AndresMtzP/Globetrotters/README.md

# GlobeTrotter
##SDSU EE/CompE 490 Spring17

* This repository holds the Globetrotter project files (San Diego State University Spring 2017)

##Collaborators
* Leon Tran 
* Kevin Warner 
* Brian Pham 
* Andres Martinez Paz 
* Rence Abar 
* Mark Luna 
* Cristopher Pakosta 
* Jake Jabbora
