AndresMtzP/Globetrotters/ProjectFiles/Project/PCB design/CoilsTop/PCB/LogFiles/ForwardAnnotation.txt

                               Forward Annotation
                               ------------------

                        02:03 PM Tuesday, April 25, 2017
                     Job Name: J:\CoilsTop\PCB\CoilsTop.pcb

Version:  01.01.00

     The PDBs listed in the project file will be searched to satisfy the parts
      requirements of the iCDB only for parts not already found in the
      Target PDB.

     The schematic source is a Common Data Base.

     The AllowAlphaRefDes status indicates that reference
      designators containing all alpha characters should be deleted
      and the relevant symbols repackaged.

     Common Data Base has been read

     Target PDB Name: Work\Layout_Temp\PartsDB.pdb

     Number of Part Numbers: 4
          Part Numb: HallEffectSensor -> Vend Part: HallEffectSensor 
          Part Numb: LED_SMD_1206 -> Vend Part: LED_SMD_1206 
          Part Numb: Res_1206 -> Vend Part: Res_1206 
          Part Numb: 10_pin_sngl -> Vend Part: 10_pin_sngl 

     Number of Part Names: 0

     Number of Part Labels: 0

     Checking for value differences between symbol properties and PartsDB properties

    WARNING: Block Schematic1, Page 1, Symbol XCMP26:
	Symbol / PartsDB property mismatch:
      Resolved PartNumber = LED_SMD_1206
      Symbol Property: Description = LED, Photoemissive Diode
     PartsDB Property: Description = 

    WARNING: Block Schematic1, Page 1, Symbol XCMP26:
	Symbol / PartsDB property mismatch:
      Resolved PartNumber = LED_SMD_1206
      Symbol Property: Type = DIODE
     PartsDB Property: Type = IC

    WARNING: Block Schematic1, Page 1, Symbol XCMP25:
	Symbol / PartsDB property mismatch:
      Resolved PartNumber = LED_SMD_1206
      Symbol Property: Description = LED, Photoemissive Diode
     PartsDB Property: Description = 

    WARNING: Block Schematic1, Page 1, Symbol XCMP25:
	Symbol / PartsDB property mismatch:
      Resolved PartNumber = LED_SMD_1206
      Symbol Property: Type = DIODE
     PartsDB Property: Type = IC

    WARNING: Block Schematic1, Page 1, Symbol XCMP20:
	Symbol / PartsDB property mismatch:
      Resolved PartNumber = LED_SMD_1206
      Symbol Property: Description = LED, Photoemissive Diode
     PartsDB Property: Description = 

    WARNING: Block Schematic1, Page 1, Symbol XCMP20:
	Symbol / PartsDB property mismatch:
      Resolved PartNumber = LED_SMD_1206
      Symbol Property: Type = DIODE
     PartsDB Property: Type = IC

    WARNING: Block Schematic1, Page 1, Symbol XCMP19:
	Symbol / PartsDB property mismatch:
      Resolved PartNumber = LED_SMD_1206
      Symbol Property: Description = LED, Photoemissive Diode
     PartsDB Property: Description = 

    WARNING: Block Schematic1, Page 1, Symbol XCMP19:
	Symbol / PartsDB property mismatch:
      Resolved PartNumber = LED_SMD_1206
      Symbol Property: Type = DIODE
     PartsDB Property: Type = IC

    WARNING: Block Schematic1, Page 1, Symbol XCMP28:
	Symbol / PartsDB property mismatch:
      Resolved PartNumber = Res_1206
      Symbol Property: Description = Resistor
     PartsDB Property: Description = 

    WARNING: Block Schematic1, Page 1, Symbol XCMP28:
	Symbol / PartsDB property mismatch:
      Resolved PartNumber = Res_1206
      Symbol Property: Type = RES
     PartsDB Property: Type = Resistor

    WARNING: Block Schematic1, Page 1, Symbol XCMP27:
	Symbol / PartsDB property mismatch:
      Resolved PartNumber = Res_1206
      Symbol Property: Description = Resistor
     PartsDB Property: Description = 

    WARNING: Block Schematic1, Page 1, Symbol XCMP27:
	Symbol / PartsDB property mismatch:
      Resolved PartNumber = Res_1206
      Symbol Property: Type = RES
     PartsDB Property: Type = Resistor

    WARNING: Block Schematic1, Page 1, Symbol XCMP22:
	Symbol / PartsDB property mismatch:
      Resolved PartNumber = Res_1206
      Symbol Property: Description = Resistor
     PartsDB Property: Description = 

    WARNING: Block Schematic1, Page 1, Symbol XCMP22:
	Symbol / PartsDB property mismatch:
      Resolved PartNumber = Res_1206
      Symbol Property: Type = RES
     PartsDB Property: Type = Resistor

    WARNING: Block Schematic1, Page 1, Symbol XCMP21:
	Symbol / PartsDB property mismatch:
      Resolved PartNumber = Res_1206
      Symbol Property: Description = Resistor
     PartsDB Property: Description = 

    WARNING: Block Schematic1, Page 1, Symbol XCMP21:
	Symbol / PartsDB property mismatch:
      Resolved PartNumber = Res_1206
      Symbol Property: Type = RES
     PartsDB Property: Type = Resistor

     Checking the validity of the packaging of prepackaged schematic
      symbols.  Only the first error in symbols having the same
      Reference Designator will be reported.

     The packaging of all prepackaged schematic symbols is consistent
      with the Parts DataBase data for the cross mapping of
      symbol pin names to Part Number pin numbers.
      Symbols that were not prepackaged will now be packaged correctly.
      
     No errors in Existing Schematic Packaging.

     The Common DataBase has been read and will be packaged.
     Clustering 22 Symbols:
              22  *********************
     Clustering is Complete

     Packager Assignments successfully completed

     14 nets were found containing 38 pins
     13 components were found

     Creating a formatted Schematic Netlist (LogFiles\SchematicNetlist.txt)...
     A formatted Schematic Netlist has been created.

     The Logic DataBase has been compiled from the Schematic Design.
      Use Netload to bring the Component Design into sync.

     This Logic Data was Compiled with 16 warnings.
      Erroneous results may occur if not fixed.

                                     NetLoad
                                     -------

                        02:03 PM Tuesday, April 25, 2017
                     Job Name: J:\CoilsTop\PCB\CoilsTop.pcb

Version:  02.11.12

	Netloading the Layout.  Unused components will be changed to spares.

	Unconnected pins will be set to net "(Net0)".

	Schematic reference designator changes will be forward annotated.

     WARNING:  The "6_pin_sngl_.1sp" cell used by "J1" in the Layout is not
      valid for a "10_pin_sngl" Part Number.
     INFO: Cell "6_pin_sngl_.1sp" is being replaced by cell "10_pin_sngl_.1sp".

     The following 8 components have not been placed:

        D1
        D2
        D3
        D4
        R1
        R2
        R3
        R4

     Netload completed successfully with 1 warning(s).
     
     Back Annotating...

  Updating Logic Database...

     Version:  99.00.05

     No changes made to Existing Schematic Packaging.

     There is no symbol data to be back annotated to the schematic source.

     The Logic DataBase has been updated and the Common DataBase has
      automatically been brought into sync with the Logic DataBase.
      Please proceed with your design.

     Finished updating the Logic Database.

     Creating a formatted Schematic Netlist (LogFiles\AfterBakAnnoNetlist.txt)...
     A formatted Schematic Netlist has been created.

     Creating a new netlist text file (LogFiles\KeyinNetList.txt)
      from the Logic Database (Work\Layout_Temp\LogicDB.lgc)...
  A new netlist text file has been generated.

                 Beginning Netload on the Layout Design.
           ---------------------------------------------------
	Broke back a trace from the point (7112000, -92456000).
	Assigned net XSIG010007 to a trace which was originally on net XSIG010003.
	Broke back a trace from the point (2032000, -92456000).
	Assigned net XSIG010008 to a trace which was originally on net XSIG010004.
	Broke back a trace from the point (-508000, -92456000).
	Assigned net XSIG010009 to a trace which was originally on net XSIG010005.
	Broke back a trace from the point (-5588000, -92456000).
	Assigned net XSIG010010 to a trace which was originally on net XSIG010006.
	Broke back a trace from the point (-3048000, -92456000).

Some nets were completely deleted from the Layout Design....
	Deleted net XSIG010004, which has no pins, from the Layout Design.
	Deleted net XSIG010005, which has no pins, from the Layout Design.
	Deleted net XSIG010006, which has no pins, from the Layout Design.
	Deleted net XSIG010003, which has no pins, from the Layout Design.

Forward-Annotation on the Layout Design has been successfully completed.

There were 4 reassignments of nets.
There were 5 traces broken back.
There were 4 nets removed from the Layout Design.
