AndresMtzP/Globetrotters/ProjectFiles/Project/PCB design/GTLibrary/LayoutTemplates/Micro_mouse/PCB/LogFiles/PCBVersion.txt

Expedition PCB - Pinnacle Version: 05.010425.03 2000C
