AndresMtzP/Globetrotters/ProjectFiles/Project/PCB design/GTLibrary/Templates/Layout/2 Layer Generic Template/LogFiles/BackAnnotation.txt

                                 BackAnnotation
                                 --------------

                       02:56 PM Saturday, October 25, 2008
Job Name: C:\My Data\Design\Mentor\Libs\JPK_Lib\Templates\Layout\2 Layer Logic Root Module Template\Single_7seg.pcb

  Updating Logic Database...

     Version:  99.00.05

     Writing a list of routed plane pins to Logic\rtdplane.caf.

     Finished updating the Logic Database.

     Updating LogicDB Version from 5 to 6.

     Creating a formatted Schematic Netlist (LogFiles\AfterBakAnnoNetlist.txt)...
     A formatted Schematic Netlist has been created.

     Creating a new Keyin Netlist (C:\My Data\Design\Mentor\Libs\JPK_Lib\Templates\Layout\2 Layer Logic Root Module Template\NetList.kyn)
      from the Logic Database (Work\Layout_Temp\LogicDB.lgc)...
  A new Keyin Netlist has been generated.

     Completed Back Annotation
