AndresMtzP/Globetrotters/ProjectFiles/Project/PCB design/GTLibrary/Work/CellEditorFiles/jpk_Antenna/LogFiles/ReadGraphicsSettings.txt

Attempting to read Graphics Settings file <Graphics Settings.hkp>

The full pathname is <C:\cad\CentralLibs\JPK_Lib\Work\CellEditorFiles\jpk_Antenna\Config\Graphics Settings.hkp>

Successful completion
