AndresMtzP/Globetrotters/ProjectFiles/Project/PCB design/GTLibrary/Work/CellEditorFiles/jpk_conn/LogFiles/WriteGraphicsSettings.txt

Attempting to write Graphics Settings file <Graphics Settings.hkp>

The full pathname is   <C:\cad\CentralLibs\JPK_Lib\Work\CellEditorFiles\jpk_conn\Config\Graphics Settings.hkp>
The backup pathname is <C:\cad\CentralLibs\JPK_Lib\Work\CellEditorFiles\jpk_conn\Config\Graphics Settings.bak>

Successful completion
