AndresMtzP/Globetrotters/ProjectFiles/Project/PCB design/GTLibrary/Work/CellEditorFiles/jpk_Pot/LogFiles/ReadGraphicsSettings.txt

Attempting to read Graphics Settings file <Graphics Settings.hkp>

The full pathname is <C:\cad\CentralLibs\JPK_Lib\Work\CellEditorFiles\jpk_Pot\Config\Graphics Settings.hkp>

file <C:\cad\CentralLibs\JPK_Lib\Work\CellEditorFiles\jpk_Pot\Config\Graphics Settings.hkp> does not exist
