AndresMtzP/Globetrotters/ProjectFiles/Project/PCB design/GTLibrary/Work/CellEditorFiles/oda99_fuse/LogFiles/ReadGraphicsSettings.txt

Attempting to read Graphics Settings file <Graphics Settings.hkp>

The full pathname is <C:\cad\CentralLibs\JPK_Lib\Work\CellEditorFiles\oda99_fuse\Config\Graphics Settings.hkp>

file <C:\cad\CentralLibs\JPK_Lib\Work\CellEditorFiles\oda99_fuse\Config\Graphics Settings.hkp> does not exist
