AndresMtzP/Globetrotters/ProjectFiles/Project/PCB design/GTLibrary/Seed_Projects/Santa_Cruz/Santa_Cruz_Level_2/PCB/LogFiles/ReadGraphicsSettings.txt

Attempting to read Graphics Settings file <Graphics Settings.hkp>

The full pathname is <C:\cad\CentralLibs\JPK_Lib\Seed_Projects\Santa_Cruz\Santa_Cruz_Level_2\PCB\Config\Graphics Settings.hkp>

Successful completion
