AndresMtzP/Globetrotters/ProjectFiles/Weekly Reports/03-16-2017/WDRF_Rence_Week6.docx

ECE Senior Design Weekly Report

Engineer’s Name: Piorence Abar Date: 03.16.17

Team Name: The Globetrotters Lab Section: 4

Week’s Task: Finishing up the schematic for dismantled levitation model and researching information for the coils that we will be using for our project.

Results: This week much of my time was spent on preparing for our class presentation for Thursday, March 16. On top of that, I spent majority of my weekend finishing up the schematic of the dismantled levitation model. Being able to see the other side of PCB and being able to connect the pins I wasn’t able to before because of not seeing the connections, I was able to further examine the analog system. I, along with the help of the other EE’s, Chris and Jake, was able to gain a better understanding as to how exactly the analog system works and what changes we’d have to make to change the system from an analog to implementing a microcontroller. I have also been researching what parameters we would need for our coils because that has been my task this week in order to prep for starting the building of our circuit next week. With the help from http://info.ee.surrey.ac.uk/Workshop/advice/coils/index.html, I have a detailed step-by-step description from choosing the type of core, how many turns are needed, what wire is needed, testing and etc.
