AndresMtzP/Globetrotters/ProjectFiles/Weekly Reports/04-27-2017/Leon Tran Weekly Report 4-26-17.docx

ECE Senior Design Weekly Report

Engineer’s Name: Leon Tran Date: 04/26/17

Team Name: The Globetrotters Lab Section: 4

Week’s Task: Adding an about Page and Gallery Page for the GUI. Testing and soldering the PCBs for Levitation. Prepare Final Presentation

Results:

- Testing the PCBs
  - Soldering and fixing the shorts on the PCBs for the Hall Effects Sensor
- GUI
  - Created an About Page for the GUI
  - Created a Gallery Page that documents our progress from the initial creation to the finish product.
- Presentation
  - Constructed and organized the slides for the final presentation
