AndresMtzP/Globetrotters/ProjectFiles/Project/Minutes/Notes - 2-23-17.docx

# The Globetrotters Notes – 2/23/17

# Hugh Comments

## Try to look for cheap Mold for Globe

## Voice

- Change Alexa hot word to something else

## Design

- 3D Print Mounts

## Levitation

### Jake

- Get some calculations for the force and energy
  - Look into half Bridge and off-Bridge
  - Look at the Data Sheet

### Chris

- Calculations
- Get Calculations on the drive

### Rence
