AndresMtzP/Globetrotters/ProjectFiles/Project/Minutes/Notes - 3-14-17.docx

# The Globetrotters Notes – 3/14/17

# Reports

- Sensors and motors ordered last Friday
- Levitation team met last Friday and designed a new schematic
- Official Name of the project is Trotter

# Presentation

- Alexea will introduce the presentation
