AndresMtzP/Globetrotters/ProjectFiles/Project/Minutes/Notes - 4-6-17 .docx

# The Globetrotters Notes – 4/6/17

# Feedback

- Control System
  - H-Bridge
    - Control the Position of the Magnets
  - Get Numbers and know why and how it will affect the system
  - Find the correct voltage to get the sweet spot for PWM
    - Middle Range
- Need Heat Sensor to know when to shutdown the system
- Keep Looking into painting material
- Frequency of PWM has to be faster than the sampling rate
- Describe the details of the Chips in the presentation
  - H-Bridge
