AndresMtzP/Globetrotters/ProjectFiles/Project Proposal/Progress Report.pdf

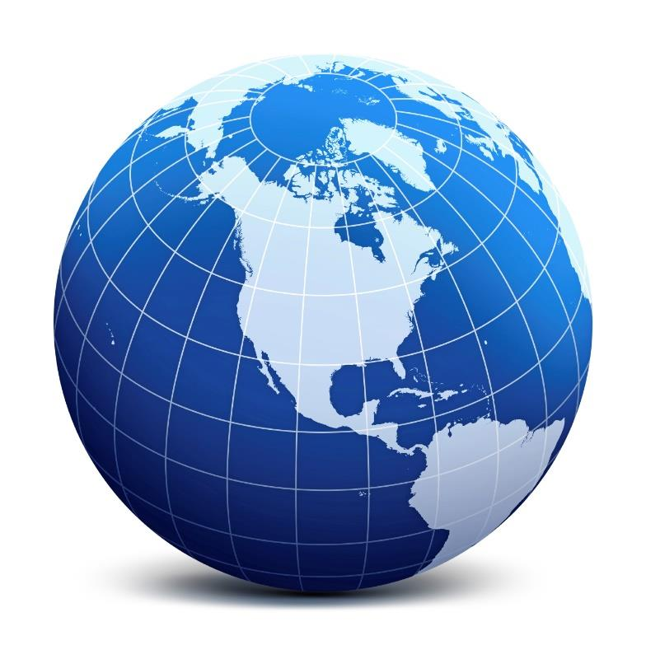
[picture p28: figure]

2017

# The GlobeTrotters

## PROPOSAL FOR MAGLEV GLOBE ENGINEERS ____________________________

## Brian Pham Andres Martinez Paz Leon Tran Christopher Pakosta Kevin Warner Rence Abar Mark Luna Jake Jabbora

## Sponsored By: Morris Cerullo World Evangelism

1 | P a g e | T h e G l o b e t r o t t e r s

## Table of Contents

## Introduction | 1

### Abstract | 2 Project Description | 2

## Design | 3

### Block Diagrams | 3, 4, 5 Mock-Up Illustration | 5, 6 Performance Requirement | 7

## Testing and Verification | 8

### Testing Procedures | 8 Benchmarks | 8

## Project Management | 9

### Project Plan (Gantt Charts) | 9 Milestones | 10

## Budget | 10

### Cost Analysis | 10, 11

## Promotional Flyer | 12

2 | P a g e | T h e G l o b e t r o t t e r s

## I. Introduction

## Abstract:

MCWE has requested for a levitating globe that users can interact with to explore and learn about different regions of the world. The user will be able to use non-contact methods, such as gesture and voice commands, to navigate the globe and select areas of interest. Information about the area will be collected through various API sources which will be stored on a local database. The Raspberry Pi will then present the information on an external display while the globe rotates to the location selected by the user.

## Project Description:

### Levitating interactive globe

The globe will enable the user to provide gesture inputs and make vocal requests for various geographical facts. It will present the user with geographic and statistical data about the various countries and cities of the world upon request while it rotates to the requested country. The globe is designed with a focus on ease of use and accommodating people with disabilities.

### Features

- Raspberry Pi 3 and PIC microcontroller powered
- 12-inch acrylic globe surface
- Electromagnetic levitation
- Laser projected azimuthal equidistant maps
- Non-contact IR based gesture inputs with velocity control
- Voice enabled user input and feedback using Amazon Web Services
- QGIS enabled graphical user interface elements
- DSI connected 7-inch 800 x 480 LCD display
- Ultrasonic sensor for user detection and greeting

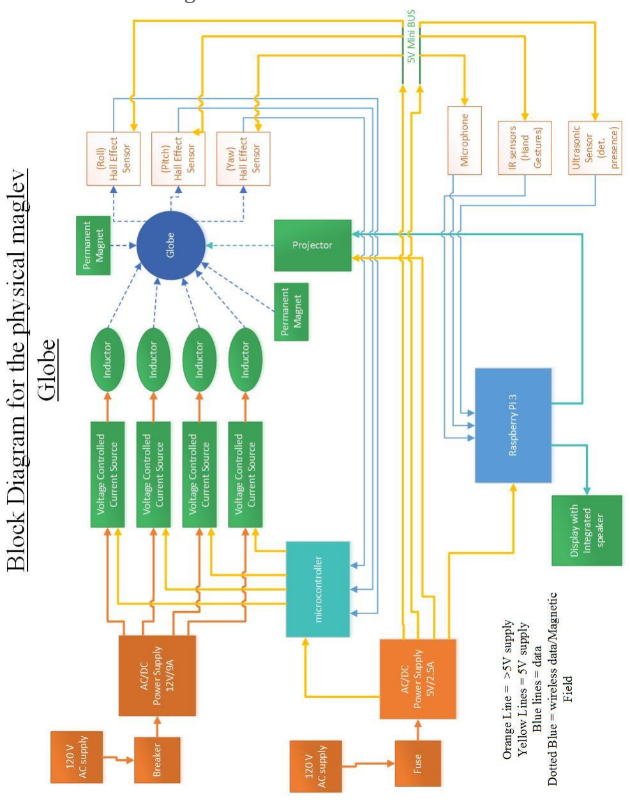
[picture p29: figure]

3 | P a g e | T h e G l o b e t r o t t e r s

## II. Design

## Hardware Block Diagram

### Figure 1 | Top Level Hardware Hierarchy

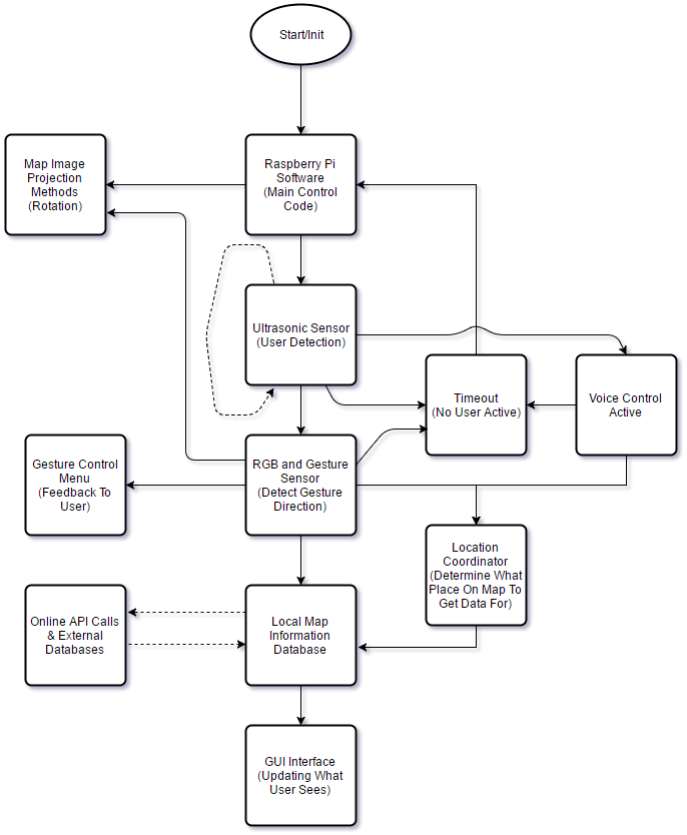
[picture p30: figure]

4 | P a g e | T h e G l o b e t r o t t e r s

## Software Block Diagram

### Software Block Diagram Flow Charts

### Figure 2 | GUI, Projection, and Map Data Processing View

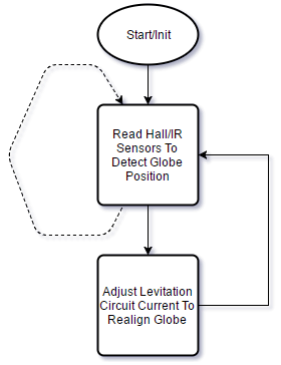
[picture p31: figure]
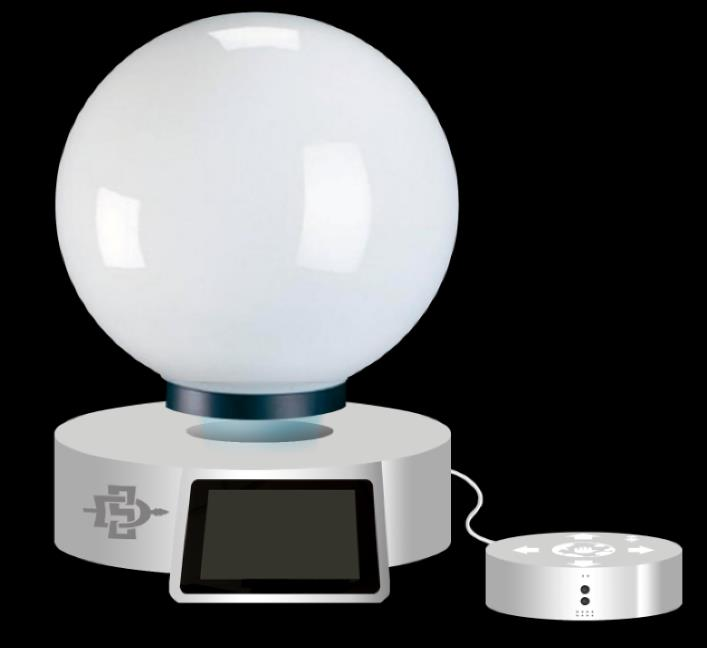
[picture p32: figure]

5 | P a g e | T h e G l o b e t r o t t e r s

### Levitation Microcontroller

### Figure 3 | Top Level Control View

## Mock Up Illustrations

### Figure 4 | General View

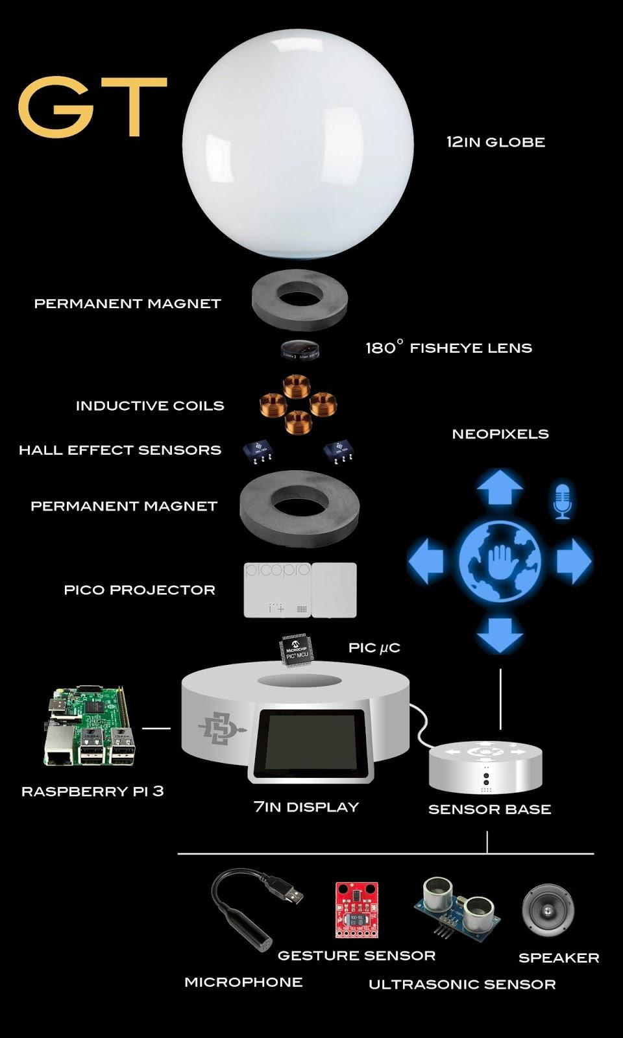
[picture p33: figure]

6 | P a g e | T h e G l o b e t r o t t e r s

### Figure 5 | Drill Down View

7 | P a g e | T h e G l o b e t r o t t e r s

## Performance Requirements

### Hardware

Power Supply
The two Power Supply’s for the system will continue to operate continuously provided the line power stays on. The power supply for the electronics will provide a continuous DC supply of 5V/3A. The power supply for the larger maglev system will provide a continuous DC supply of 12V/9A.

Sample Rate
The current and voltage sensors will operate at a sampling rate of 3 kHz. This will allow detection of signals up to the 15th harmonic.

Hall effect sensors
Latching Hall effect sensors will be able to provide feedback into the system with a switching time fall and rise of 1.5 microseconds allowing enough time to correct for disturbances within the system.

APDS-9960 Digital Proximity, Ambient Light, RGB and Gesture Sensor
UV and IR blocking filters - Programmable gain and integration time - Very high sensitivity – Ideally suited for operation behind dark glass

Microphone
The microphone will be able to pick up speech about 10 feet away from the sensor. The holding time for the sensor is 30ms.

Magnasonic PP71 Mini Portable Pico Video Projector
Will provide an adequate projection onto the acrylic globe.

Raspberry Pi 3
Provide adequate timing for proper response to I/O ports, and other function. See raspberry pi 3 datasheets from manufacturer.

PIC16(L)F18325/18345
Provide adequate timing for proper response to I/O ports, and other function. See datasheets from manufacturer for more detail.

### Software

- Requests to APIs will timeout in the range of 3 - 5 seconds
- Parsed JSON response will be stored in MySQL database within 7 - 8 units of time after the response is received
- Globe will respond to user interaction and display location-specific information under 5 seconds
- Software applications will be multithreaded in Python

8 | P a g e | T h e G l o b e t r o t t e r s

## III. Testing and Verification

## Testing Procedures

### Levitating test

Due to the use of Hall effect sensors, we will demonstrate the globe’s magnetic levitation by simply having a ring magnet for the levitating portion of the system as well as a larger ring magnet for the base part of the system. We will expose the globe to different scenarios, for example weight increase/decrease and maldistribution. We will also test for other disturbances to the system due to human interaction, and forces due to the environment— to analyze the stability of the levitation and how well the mechanism corrects itself under disorder.

### Voice test

The second test is to show the globe moving to a specific location based only on voice commands. Changing between three places will complete the test. For example, when someone says “Go to USA”, the globe will rotate to the United States of America, once the globe has stopped rotating we will provide another command and repeat the same process for different geographic locations. As we expand the registry of voice commands, an adequate test will be incorporated for every new command.

### Sensor test

This test will be similar to voice commands, but instead focusing on gesture controls. Our tests will measure the globe’s reaction to our gesture controls in different settings, such as varying the amount of light in the room, and proximity to the sensors. We will observe how well the sensor inputs integrate into the project, and what the response time will be.

### Display test

The display must show the information of the location that is being projected on the globe (min. of 2 second stop time to display image to prevent display from looking like it is glitching out from passing so many countries at once).

### Rotating test

The projection for the globe is implemented using an interactive graphics library. For this reason, our tests must measure the frame rate of the projection under heavy use of the Raspberry Pi’s processor. The goal is to optimize the algorithms so that the globe’s rotation looks as smooth and natural as possible. As a constraint, the globe must continue to rotate while it is idle. By introducing this constraint, we are making the projection a finite-state machine, so we will incorporate adequate testing techniques to ensure that the timing and response of the program work well.

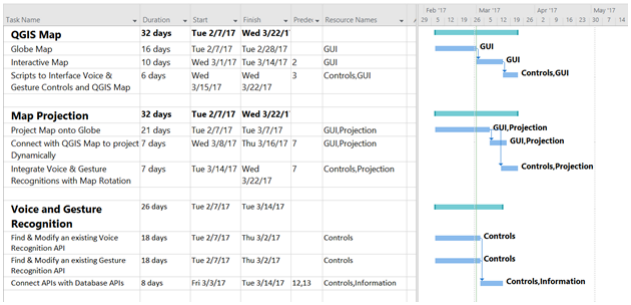
[picture p34: figure]

9 | P a g e | T h e G l o b e t r o t t e r s

## Benchmarks

### Software Benchmarks

- The projected images of the map will transition to give the appearance of rotation
- The globe will allow non-contact commands to rotate to a specified area
- The globe will present location-specific information on a GUI
- The globe will have Wi-Fi connectivity and be able to retrieve information from the internet
- The globe will continuously rotate when idle and no user is detected

### Hardware Benchmarks

- Stability achieved by using the hall effect sensors for feedback
- Voltage controlled Current Sources will respond fast enough to support feedback.
- Microcontroller I/O timing achieved fast enough for minimum power consumption
- The physical globe will levitate via the maglev system.

## IV. Program Management

## Gantt Chart: Software

### Figure 6 | Software Tasks

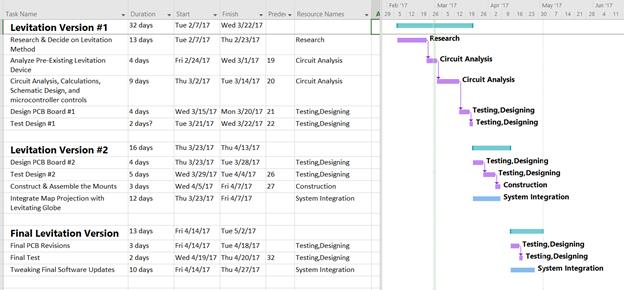
[picture p35: figure]

10 | P a g e | T h e G l o b e t r o t t e r s

## Gantt Chart: Hardware

### Figure 7 | Hardware Tasks

## Milestones

Task | Date Requirements
Software Individually Complete | Fri 3/17/17 | Complete the QGIS Maps (both for the Globe & Monitor), Control Systems, and Projection Separately
Software Integration at 50% | Wed 3/22/17 | Able to control the QGIS Maps with Gesture and Voice Recognition Controls
Software Integration at 100% | Thu 4/13/17 | Able to Project the QGIS Maps onto the Globe and able to control it with Gesture and Voice Recognition
Levitate an Object | Fri 3/24/17 | Able to Levitate any small object
Levitate the Globe | Fri 4/7/17 | Able to Levitate the weight of the Globe with the additional add-ons (lens & magnets)
Levitate the Projected Globe | Fri 4/28/17 | Able to levitate the projected Globe and control it through voice and gesture controls

### Figure 8 | Milestone Deadlines

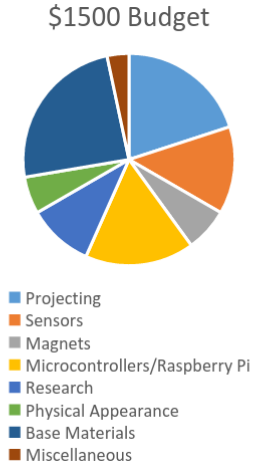
[picture p36: figure]

11 | P a g e | T h e G l o b e t r o t t e r s

## V. Budget

## Cost Analysis

Area | Amount
Research | $150
Sensors | $200
Magnets | $100
Microcontrollers/Raspberry Pi | $250
Projecting | $300
Physical Appearance | $85
Base Materials | $365
Miscellaneous | $50
Total | $1500

### Figure 9| Budget Breakdown

### Figure 10| PI Chart Budget Breakdown

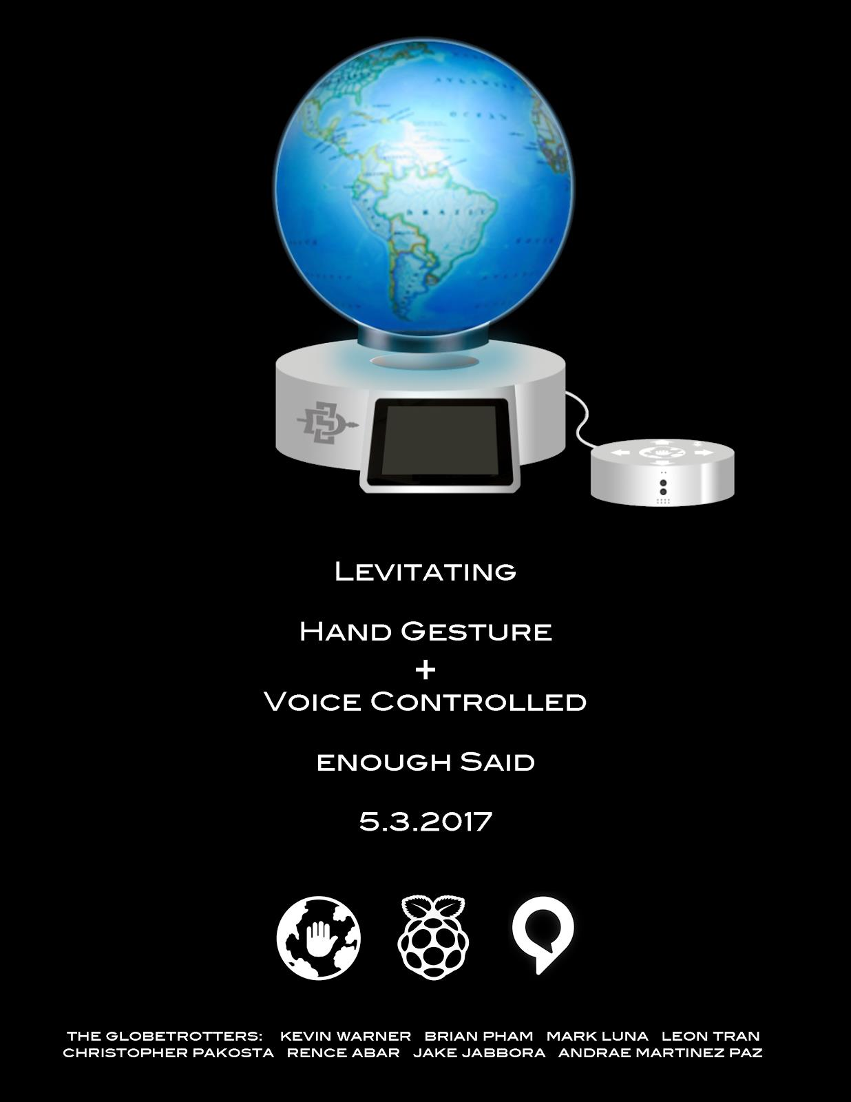
[picture p37: figure]

12 | P a g e | T h e G l o b e t r o t t e r s

## VI. Promo Flyer

### Figure 10| Flyer
