AndresMtzP/Globetrotters/ProjectFiles/Gantt Chart.pdf

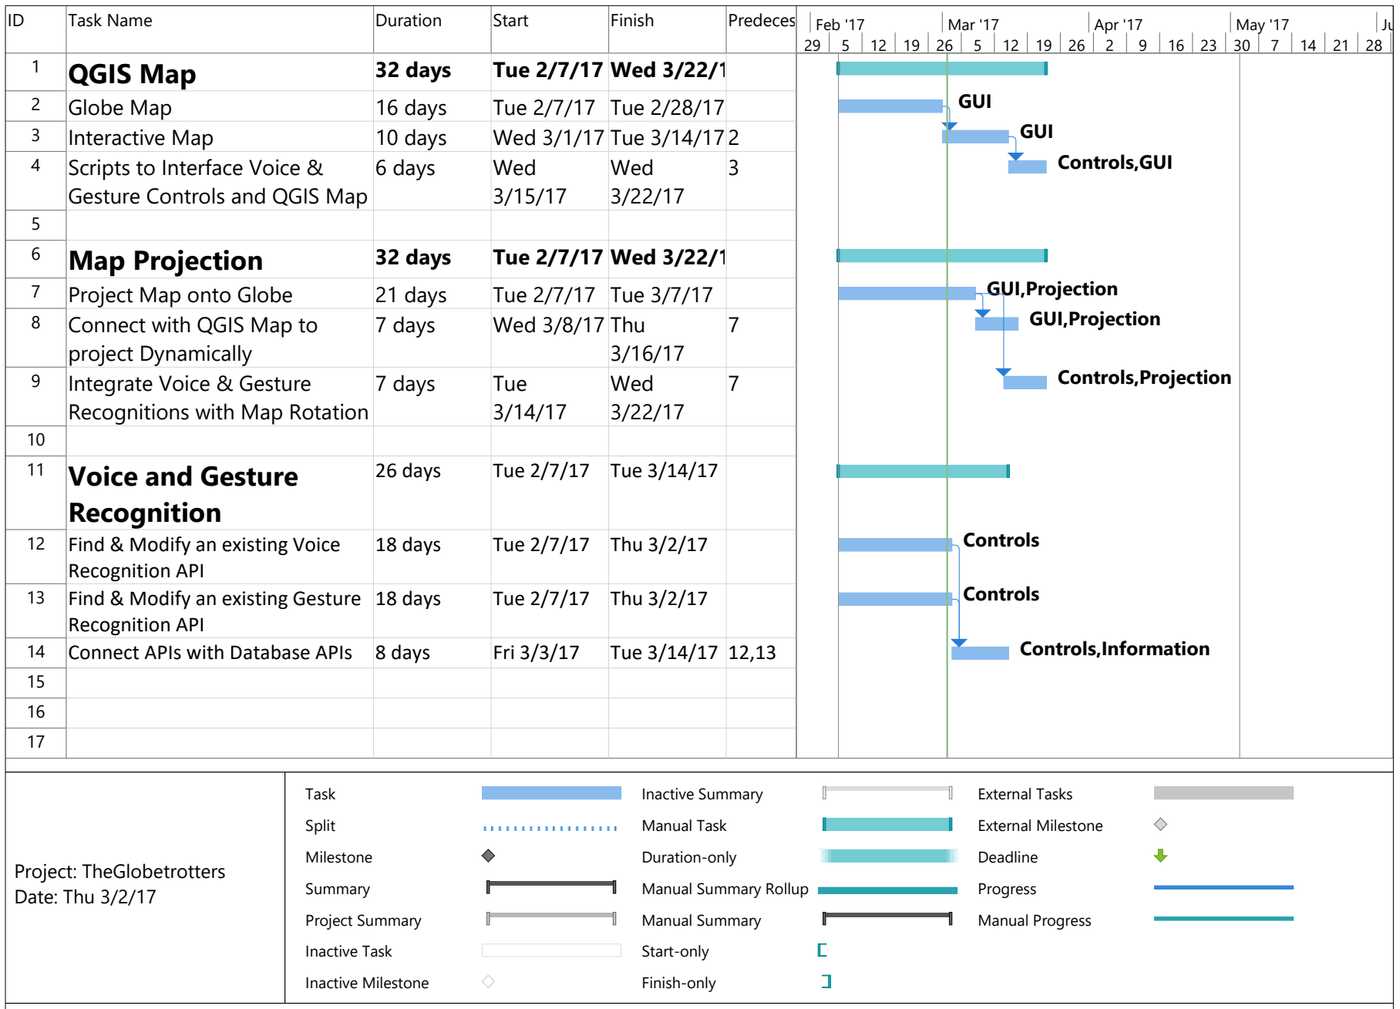
[picture p38: figure]
Task Name; Duration; Start; Finish; Predecessors; QGIS Map; 32 days; Tue 2/7/17; Wed 3/22/17; Globe Map; 16 days; Tue 2/28/17; Interactive Map; 10 days; Wed 3/1/17 Tue 3/14/17 2; Scripts to Interface Voice &; Gesture Controls and QGIS Map; 6 days; Wed; Map Projection; Project Map onto Globe; 21 days; Tue 3/7/17; Connect with QGIS Map to; project Dynamically; 7 days; Wed 3/8/17 Thu; Integrate Voice & Gesture; Recognitions with Map Rotation; Tue; Voice and Gesture; Recognition; 26 days; Tue 3/14/17; Find & Modify an existing Voice; Recognition API; 18 days; Thu 3/2/17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
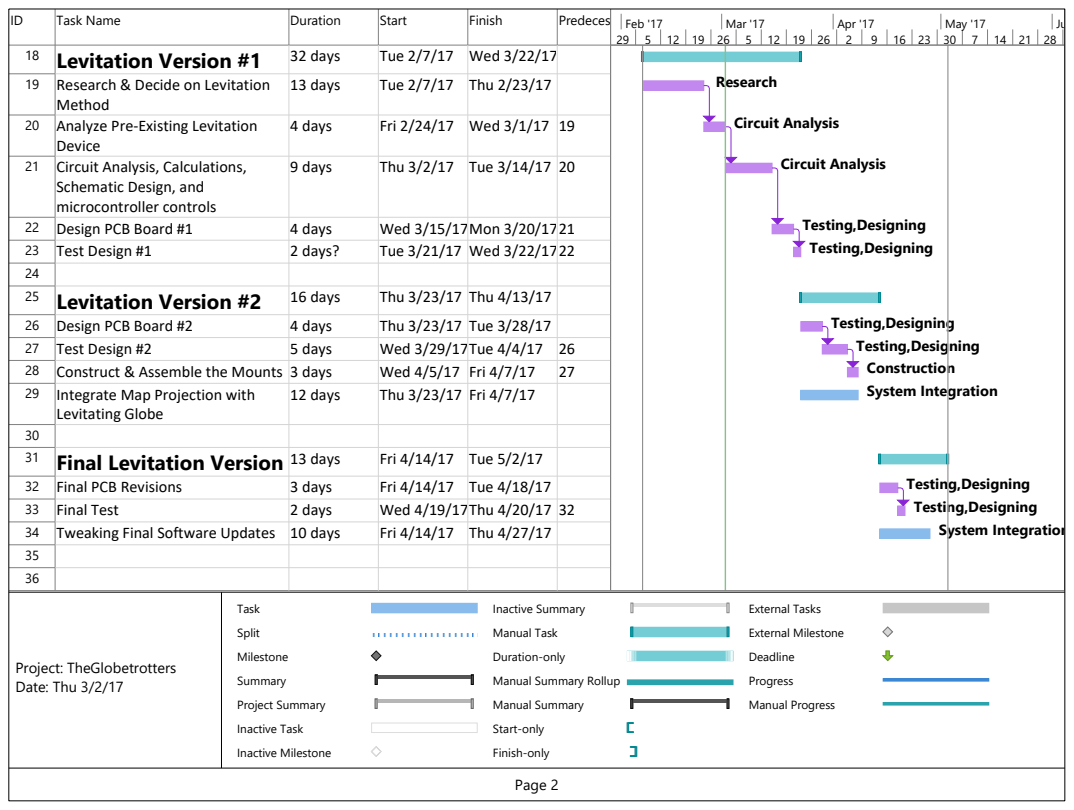
[picture p39: page 2]
Levitation Version #1; 32 days; Tue 2/7/17; Wed 3/22/17; Research & Decide on Levitation; 13 days; Thu 2/23/17; Analyze Pre-Existing Levitation; 4 days; Fri 2/24/17; Wed 3/1/17; Circuit Analysis, Calculations,; 9 days; Thu 3/2/17; Tue 3/14/17; Design PCB Board #1; Wed 3/15/17Mon 3/20/1721; Test Design #1; 2 days?; Tue 3/21/17; Wed 3/22/1722; Levitation Version #2; 16 days; Thu 3/23/17; Thu 4/13/17; Design PCB Board #2; Tue 3/28/17; Test Design #2; 5 days; Wed 3/29/17Tue 4/4/17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

Method
Device
Schematic Design, and
microcontroller controls

Manual Summary Rollup

37 | Milestones
38 | Software Individually Complete | 0 days | Fri 3/17/17 | Fri 3/17/17
39 | Software Integration at 50% | 0 days | Wed 3/22/17Wed 3/22/17
40 | Software Integration at 100% | 0 days | Thu 4/13/17 | Thu 4/13/17

41
42 | Levitate an Object | 0 days | Fri 3/24/17 | Fri 3/24/17
43 | Levitate the Globe | 0 days | Fri 4/7/17 | Fri 4/7/17
44 | Construct an Aesthetic Levitating Globe | 0 days | Fri 4/28/17 | Fri 4/28/17

3/17
3/22
4/13

3/24
4/7
4/28
29 | 5 | 12 | 19 | 26 | 5 | 12 | 19 | 26 | 2 | 9 | 16 | 23 | 30 | 7 | 14 | 21 | 28

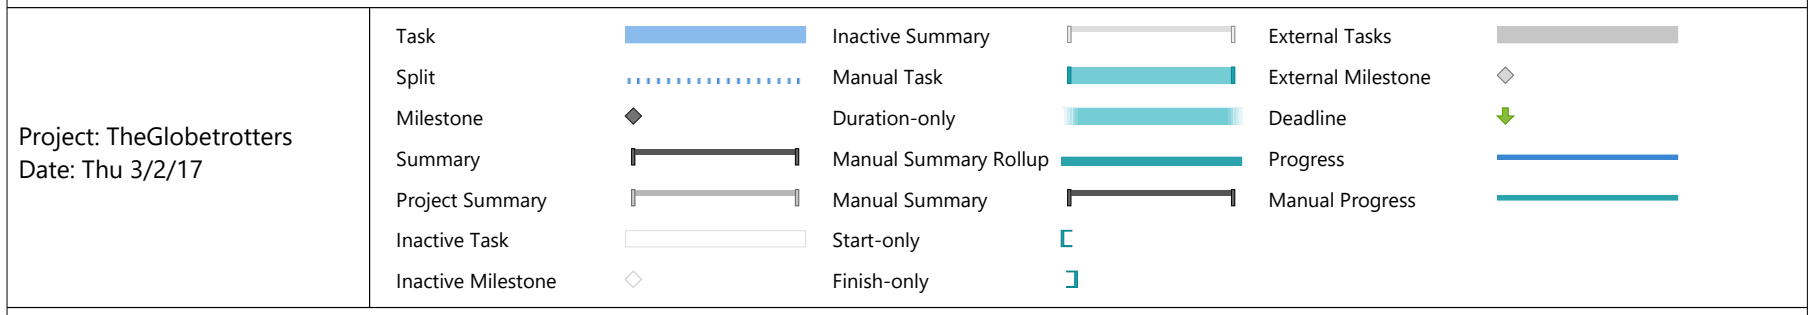
[picture p40: figure]
Task; Split; Milestone; Summary; Project Summary; Inactive Task; Inactive Milestone; Inactive Summary; Manual Task; Duration-only; Manual Summary Rollup; Manual Summary; Start-only; Finish-only; External Tasks; External Milestone; Deadline; Progress; Manual Progress; Project: TheGlobetrotters Date: Thu 3/2/17
