AndresMtzP/Globetrotters/ProjectFiles/Project/PCB design/GTLibrary/Notes/DRILLS AND PADS.xls

Hole Size | Drill Number | Pad Size TH. | Plane Size TH. | Soldermask TH.
12.5 | T82 | 44.5 | 25.0 | 50.5
15.8 | T298 | 47.8 | 31.6 | 53.8
19.7 | T299 | 51.7 | 39.4 | 57.7
20.0 | T76 | 52.0 | 40.0 | 58.0
25.0 | T72 | 57.0 | 50.0 | 63.0
27.6 | T301 | 59.6 | 55.2 | 65.6
31.5 | T302 | 63.5 | 63.0 | 69.5
35.4 | T303 | 67.4 | 70.8 | 73.4
39.4 | T304 | 71.4 | 78.8 | 77.4
45.3 | T305.5 | 77.3 | 90.6 | 83.3
52.0 | T55 | 84.0 | 104.0 | 90.0
59.1 | T310 | 91.1 | 118.2 | 97.1
59.5 | T53 | 91.5 | 119.0 | 97.5
78.7 | T315 | 110.7 | 157.4 | 116.7
116.1 | T321.35 | 148.1 | 232.2 | 154.1
118.1 | T322 | 150.1 | 236.2 | 156.1
