AndresMtzP/Globetrotters/ProjectFiles/Weekly Reports/03-23-2017/Leon Tran Weekly Report 3-23-17.docx

ECE Senior Design Weekly Report

Engineer’s Name: Leon Tran Date: 03/23/17

Team Name: The Globetrotters Lab Section: 4

Week’s Task: Make the GUI formatted for various different sizes, integrate the various voice commands, creating additional windows for the GUI and testing out the new projector.

Results:

- GUI is successfully formatted for different screen size
- Integrated zooming, opening different windows(Help screen, Info about the Project, more details about the location)
- We received our new projector and the image quality on the 12 inch acrylic sphere is much sharper than before.
  - I’m currently looking into purchasing a new globe and frosting it with a lighter level of frost so we would be able to get a clearer image quality on the globe.
