AndresMtzP/Globetrotters/ProjectFiles/Weekly Reports/04-06-2017/Weekly Report 8 (Brian Pham).docx

ECE Senior Design Weekly Report

Engineer’s Name: Brian Pham Date: April 5, 2017

Team Name: Globetrotters Lab Section: TH

Week’s Task: Incorporate some database tables into user search requests to provide more options for locations and to refine searches. Reformatted JSON returned from queries to make them more general regardless of location type to support new ‘options’ feature. Worked on basic content for website and moving files to Jason servers.

Results:

MySQL Database and Teleport API

- Searches now use database information that is included in JSON file generated
- Searches now query for locations in the order of country>state>city to refine searches
- Reformatted JSON file to provide a list of dictionaries for locations and to support new features added
- Dictionaries return in list in order of largest geographical area to smallest (ex. Countries have more priority than states and cities)

Website

- Added different sections to website including software, hardware, media
- Began adding content to software section
- Transferred files onto Jason servers and verified that it’s running

Summary

The past week I have been including the MySQL database information on countries and states to refine our searches and support new features for our GUI. Now the user has a list of options to choose from that are related to the location requested for in case locations have naming and region conflicts. I’ve been working closely with the Kevin and Leon to provide a standard format for our JSON files to support several types of location. I’ve also made progress on our website by adding interesting content of our project. The website is also up but still under construction at globetrotters.sdsu.edu
