AndresMtzP/Globetrotters/ProjectFiles/Project/PCB design/GTLibrary/Notes/MM-TH-MM Conversion Chart.xls

MM-TH-MM Conversion Chart
MM | TH | MM | TH | TH | MM | TH | MM
0.0 | 0.000 | 5.0 | 196.850 | 0 | 0.000 | 250 | 6.350
0.1 | 3.937 | 5.1 | 200.787 | 5 | 0.127 | 255 | 6.477
0.2 | 7.874 | 5.2 | 204.724 | 10 | 0.254 | 260 | 6.604
0.3 | 11.811 | 5.3 | 208.661 | 15 | 0.381 | 265 | 6.731
0.4 | 15.748 | 5.4 | 212.598 | 20 | 0.508 | 270 | 6.858
0.5 | 19.685 | 5.5 | 216.535 | 25 | 0.635 | 275 | 6.985
0.6 | 23.622 | 5.6 | 220.472 | 30 | 0.762 | 280 | 7.112
0.7 | 27.559 | 5.7 | 224.409 | 35 | 0.889 | 285 | 7.239
0.8 | 31.496 | 5.8 | 228.346 | 40 | 1.016 | 290 | 7.366
0.9 | 35.433 | 5.9 | 232.283 | 45 | 1.143 | 295 | 7.493
1.0 | 39.370 | 6.0 | 236.220 | 50 | 1.270 | 300 | 7.620
1.1 | 43.307 | 6.1 | 240.157 | 55 | 1.397 | 305 | 7.747
1.2 | 47.244 | 6.2 | 244.094 | 60 | 1.524 | 310 | 7.874
1.3 | 51.181 | 6.3 | 248.031 | 65 | 1.651 | 315 | 8.001
1.4 | 55.118 | 6.4 | 251.969 | 70 | 1.778 | 320 | 8.128
1.5 | 59.055 | 6.5 | 255.906 | 75 | 1.905 | 325 | 8.255
1.6 | 62.992 | 6.6 | 259.843 | 80 | 2.032 | 330 | 8.382
1.7 | 66.929 | 6.7 | 263.780 | 85 | 2.159 | 335 | 8.509
1.8 | 70.866 | 6.8 | 267.717 | 90 | 2.286 | 340 | 8.636
1.9 | 74.803 | 6.9 | 271.654 | 95 | 2.413 | 345 | 8.763
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
