AndresMtzP/Globetrotters/ProjectFiles/Project/Gesture/apds9960 layout.png

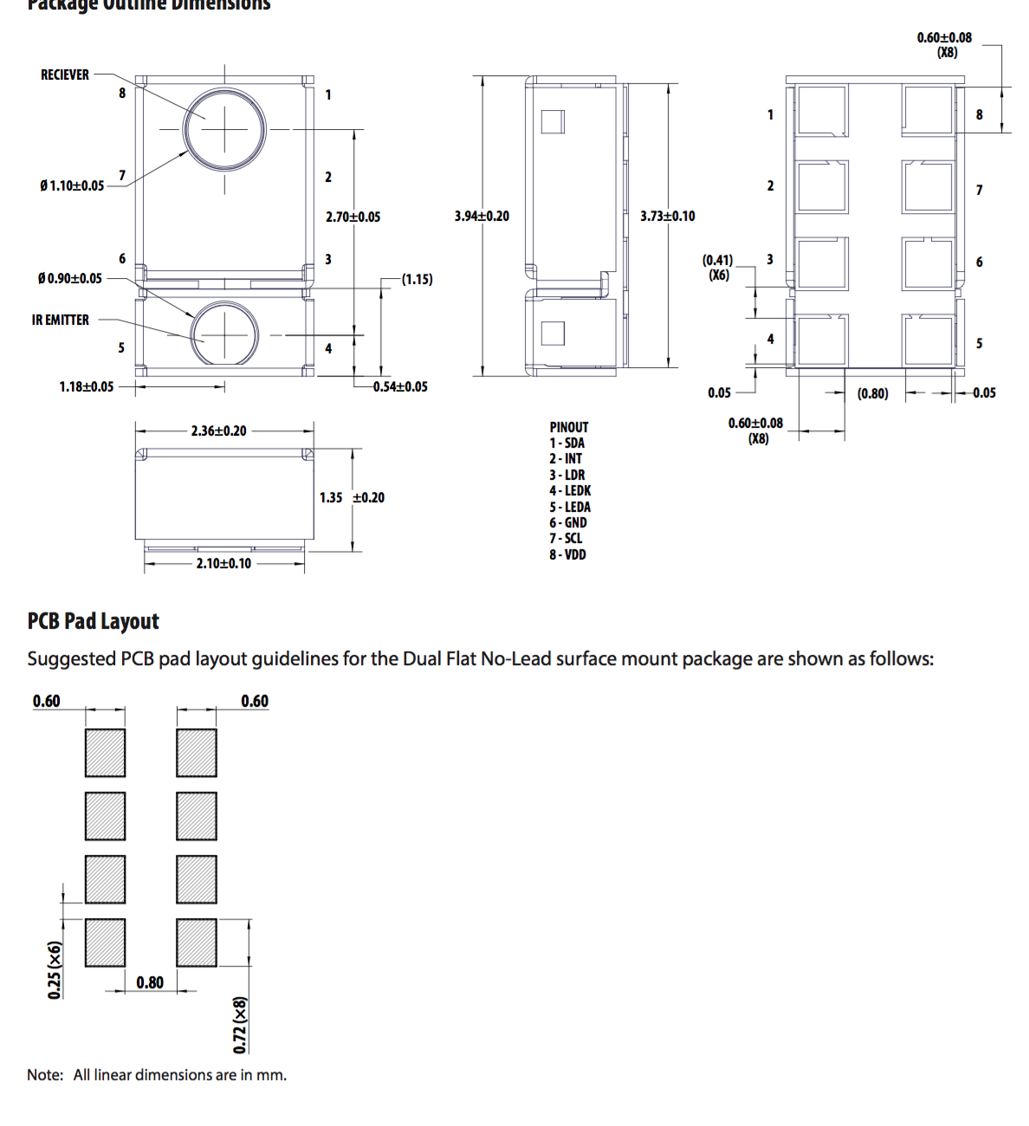
ProjectFiles/Project/Gesture/apds9960 layout.png
