AndresMtzP/Globetrotters/ProjectFiles/Project/PCB design/CoilsTop/PCBSS.JPG

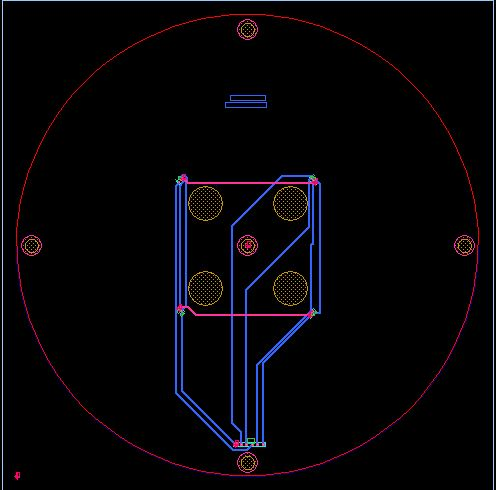
ProjectFiles/Project/PCB design/CoilsTop/PCBSS.JPG
