AndresMtzP/Globetrotters/ProjectFiles/Website/images/backendflow.png

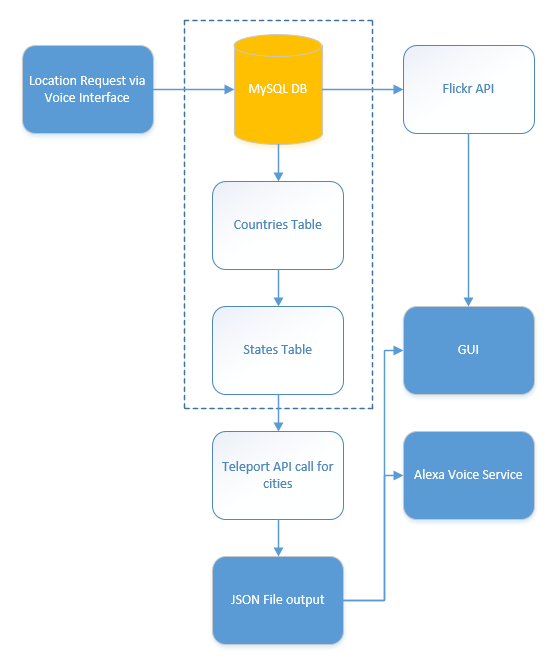
ProjectFiles/Website/images/backendflow.png
