AndresMtzP/Globetrotters/ProjectFiles/Website/images/breakout.png

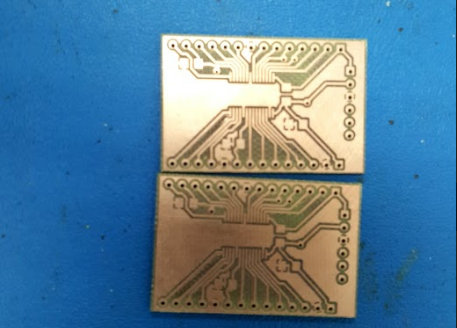
ProjectFiles/Website/images/breakout.png
