AndresMtzP/Globetrotters/ProjectFiles/Website/images/coil1.jpg

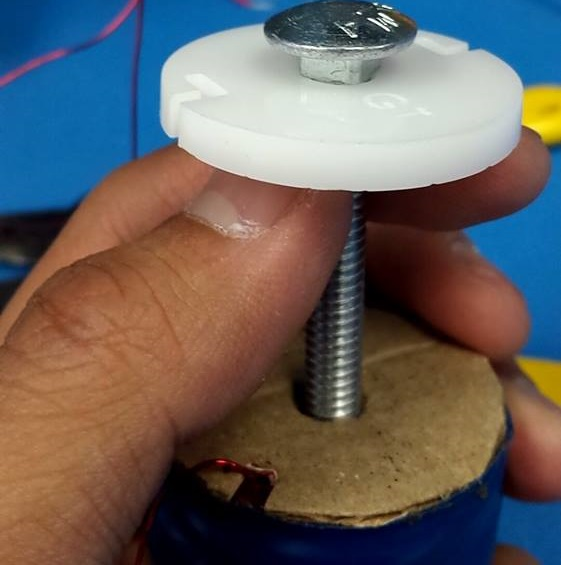
ProjectFiles/Website/images/coil1.jpg
