AndresMtzP/Globetrotters/ProjectFiles/Website/images/coil2.jpg

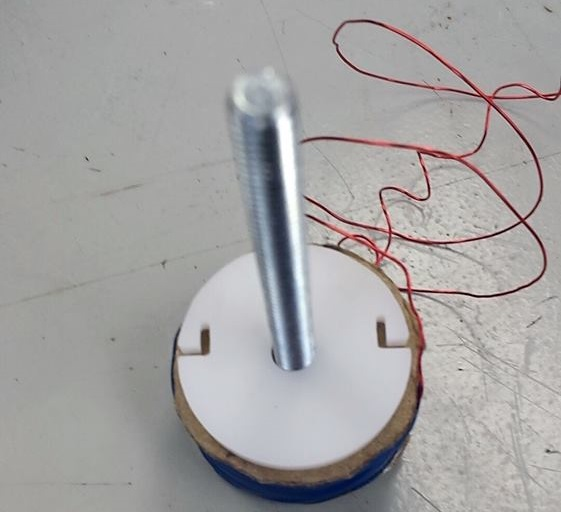
ProjectFiles/Website/images/coil2.jpg
