AndresMtzP/Globetrotters/ProjectFiles/Website/images/coilcaps.jpg

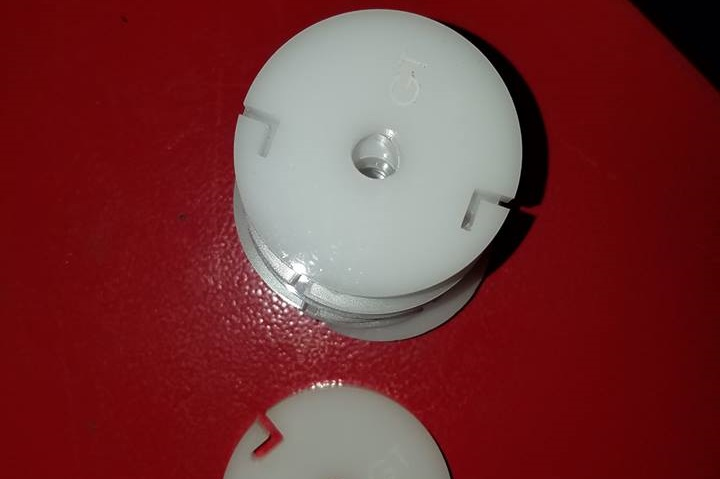
ProjectFiles/Website/images/coilcaps.jpg
