AndresMtzP/Globetrotters/ProjectFiles/Website/images/coilspace1.jpg

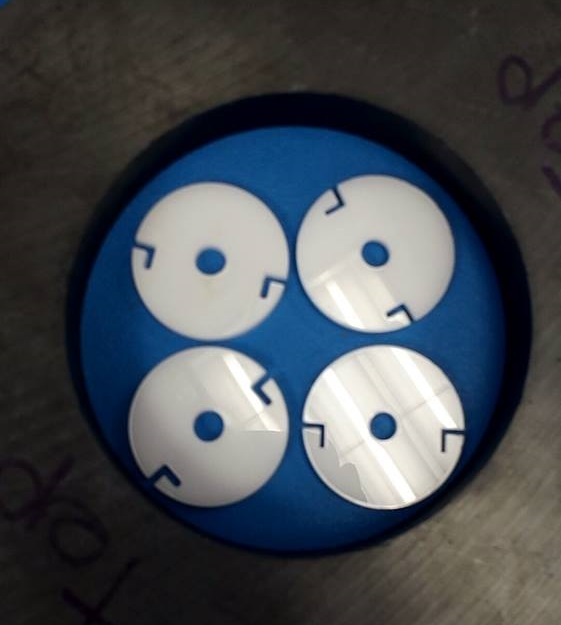
ProjectFiles/Website/images/coilspace1.jpg
