AndresMtzP/Globetrotters/ProjectFiles/Website/images/coilstest2.jpg

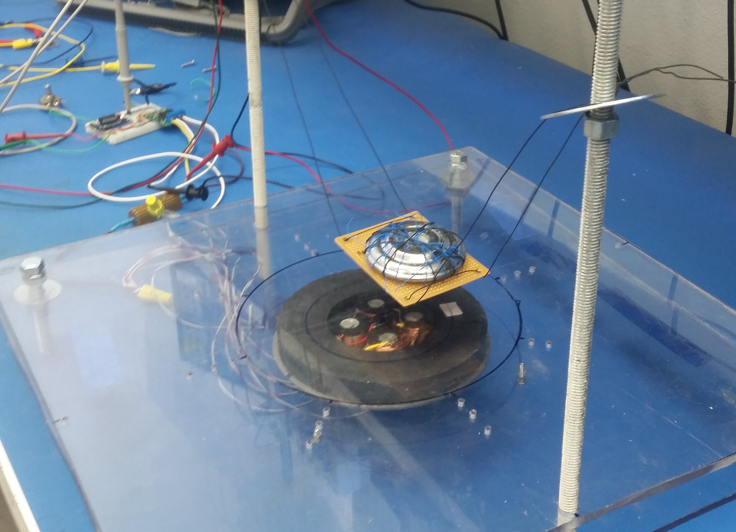
ProjectFiles/Website/images/coilstest2.jpg
