AndresMtzP/Globetrotters/ProjectFiles/Website/images/coilstest.jpg

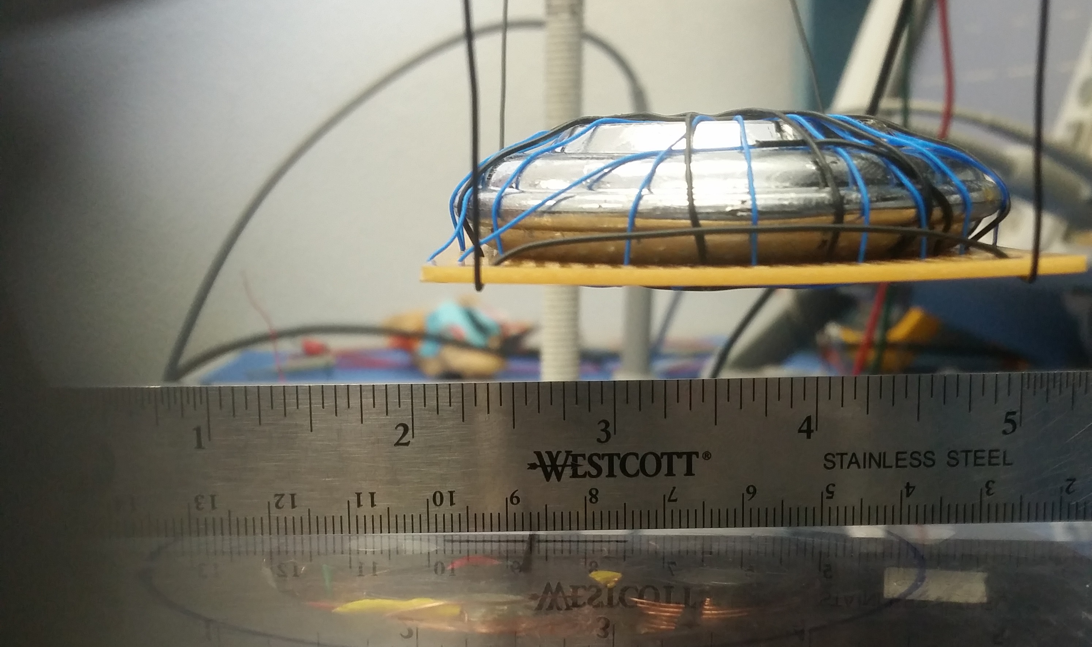
ProjectFiles/Website/images/coilstest.jpg
