AndresMtzP/Globetrotters/ProjectFiles/Website/images/comparison.png

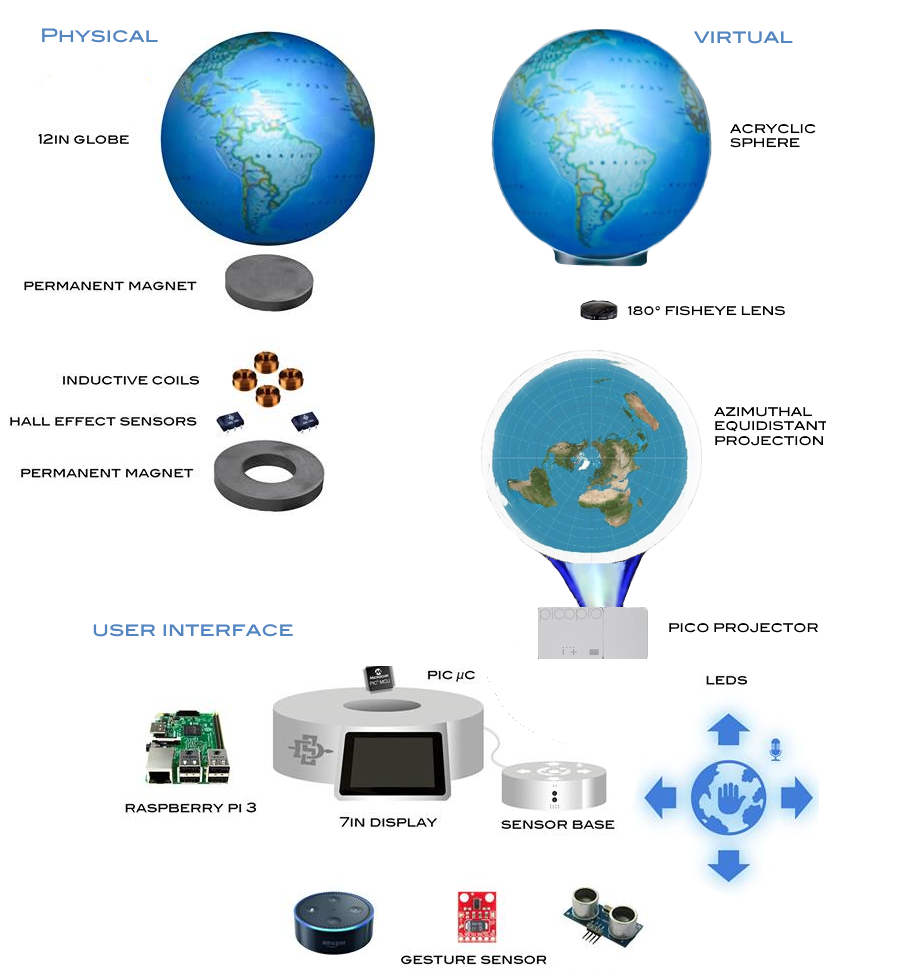
ProjectFiles/Website/images/comparison.png
