AndresMtzP/Globetrotters/ProjectFiles/Website/images/display1.jpg

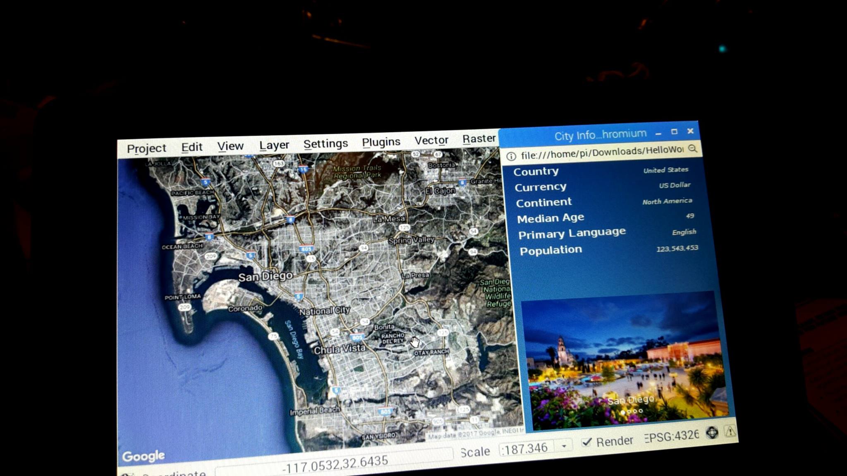
ProjectFiles/Website/images/display1.jpg
