AndresMtzP/Globetrotters/ProjectFiles/Website/images/Globe.png

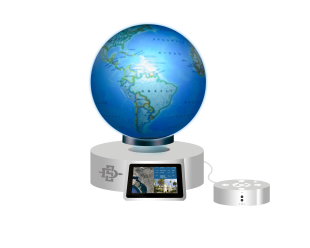
ProjectFiles/Website/images/Globe.png
