AndresMtzP/Globetrotters/ProjectFiles/Website/images/gui_display.png

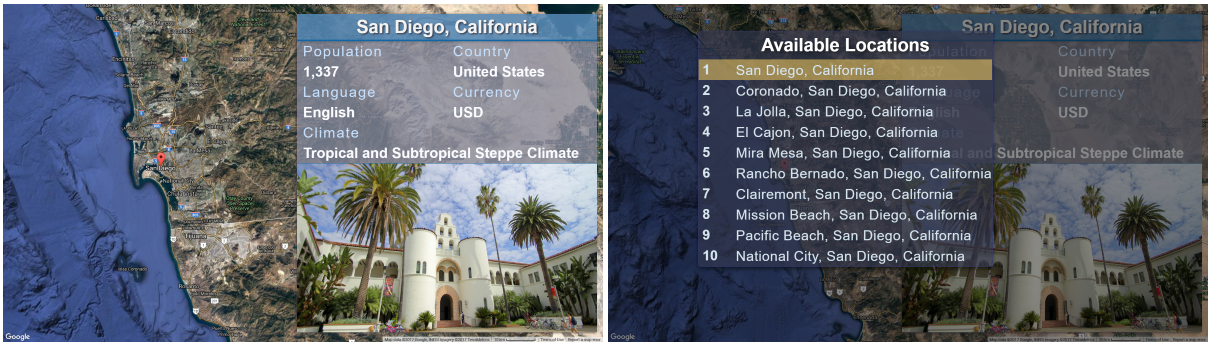
ProjectFiles/Website/images/gui_display.png
