AndresMtzP/Globetrotters/ProjectFiles/Website/images/guimain.png

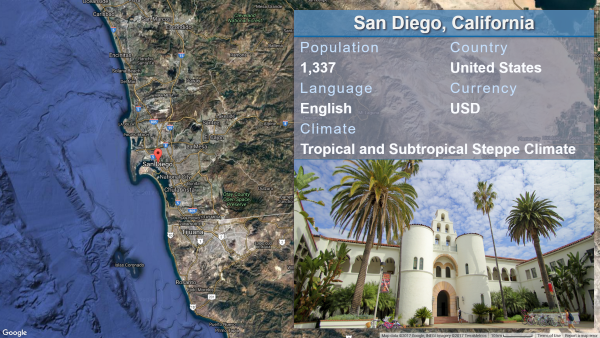
ProjectFiles/Website/images/guimain.png
