AndresMtzP/Globetrotters/ProjectFiles/Website/images/guioptions.png

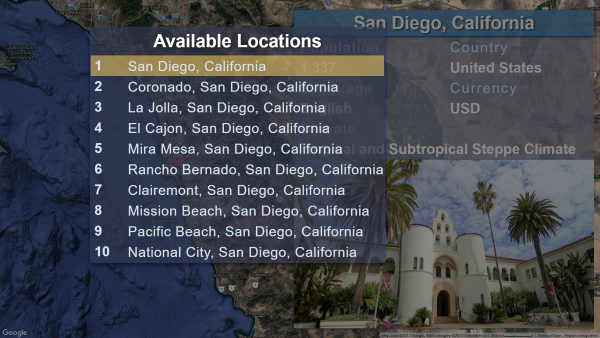
ProjectFiles/Website/images/guioptions.png
