AndresMtzP/Globetrotters/ProjectFiles/Website/images/hallmapping2.jpg

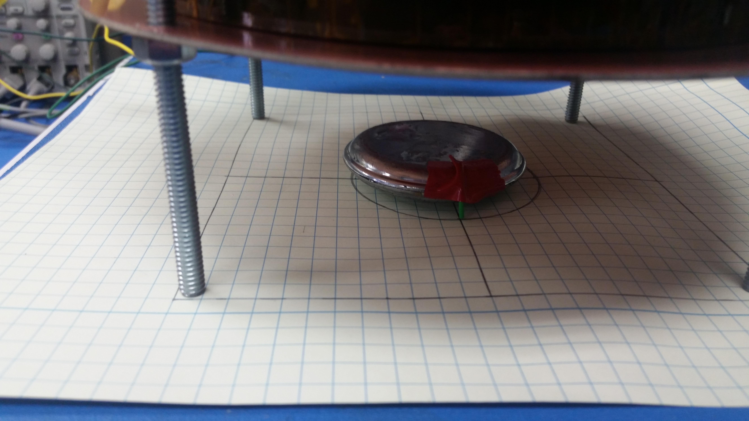
ProjectFiles/Website/images/hallmapping2.jpg
