AndresMtzP/Globetrotters/ProjectFiles/Website/images/hallmapping.jpg

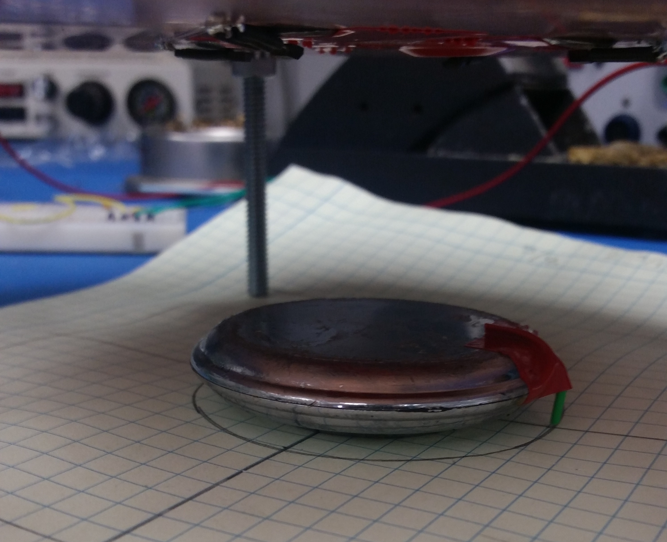
ProjectFiles/Website/images/hallmapping.jpg
