AndresMtzP/Globetrotters/ProjectFiles/Website/images/halltest1.jpg

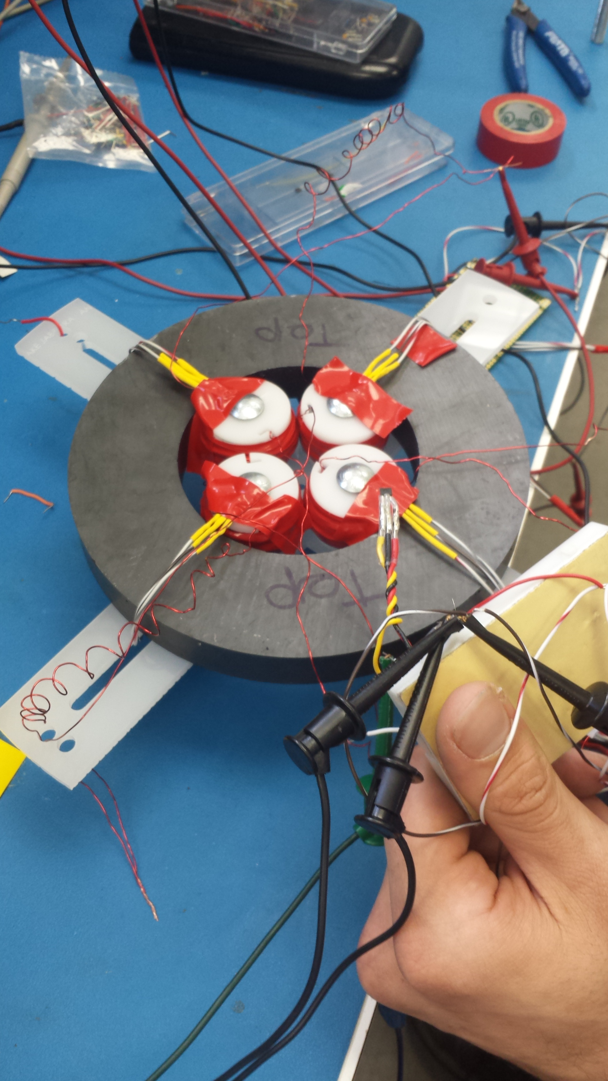
ProjectFiles/Website/images/halltest1.jpg
