AndresMtzP/Globetrotters/ProjectFiles/Website/images/hardware_comm.png

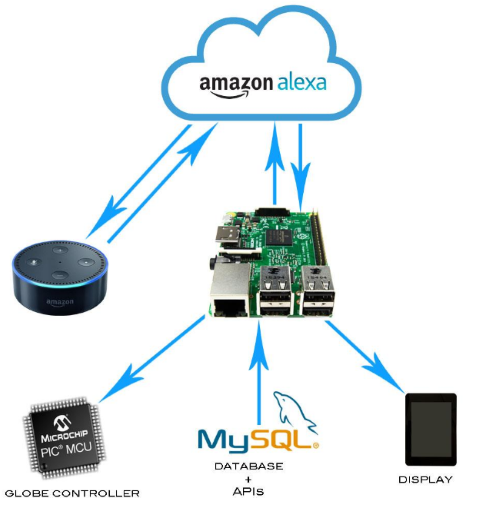
ProjectFiles/Website/images/hardware_comm.png
