AndresMtzP/Globetrotters/ProjectFiles/Website/images/KW1.jpg

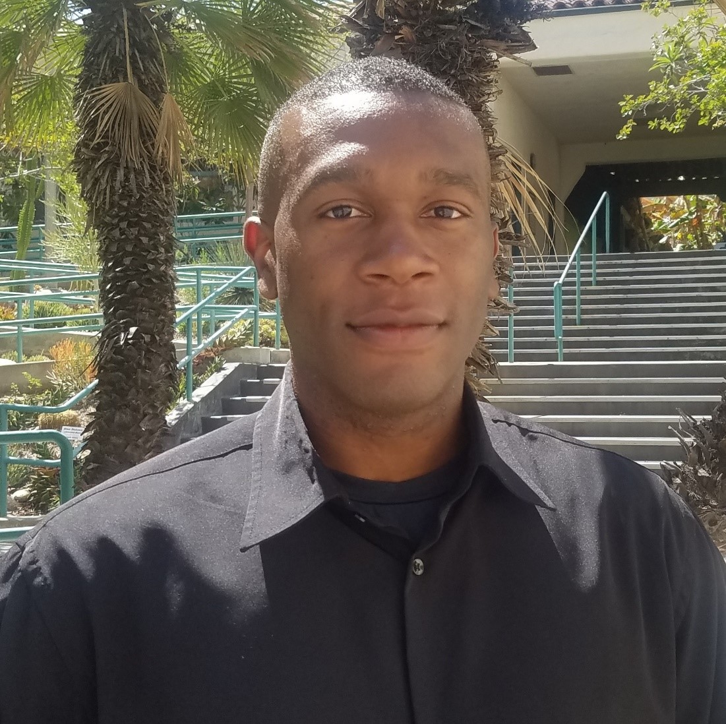
ProjectFiles/Website/images/KW1.jpg
