AndresMtzP/Globetrotters/ProjectFiles/Website/images/lev_circuit.png

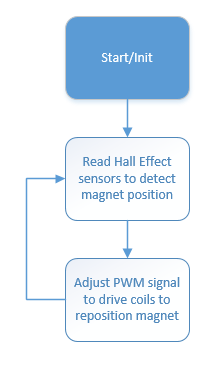
ProjectFiles/Website/images/lev_circuit.png
