AndresMtzP/Globetrotters/ProjectFiles/Website/images/mount1.jpg

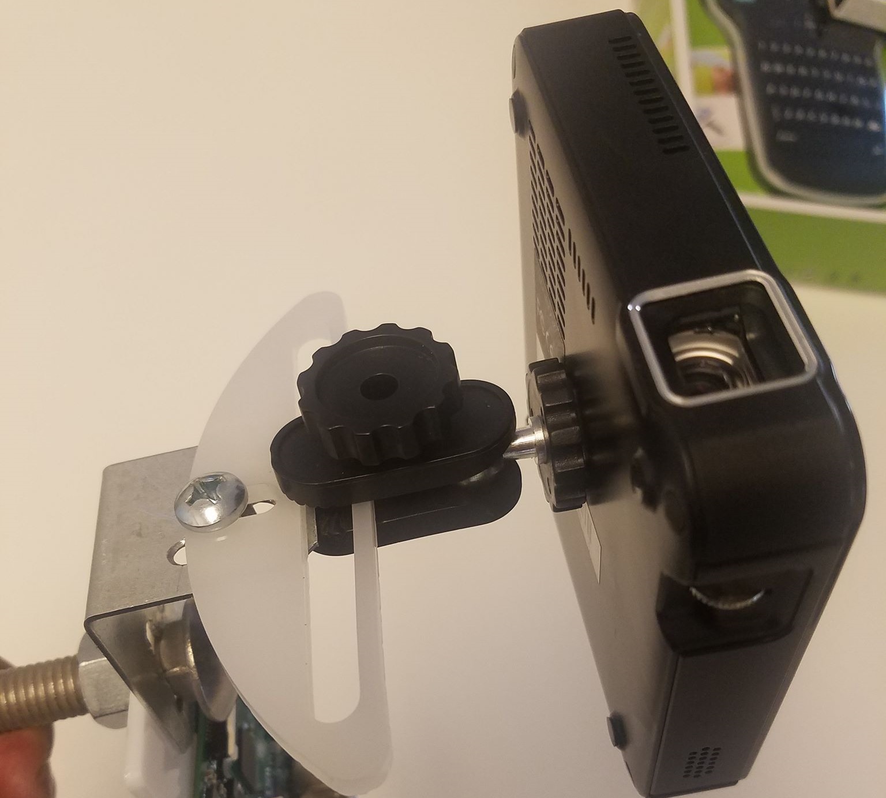
ProjectFiles/Website/images/mount1.jpg
