AndresMtzP/Globetrotters/ProjectFiles/Website/images/mount2.jpg

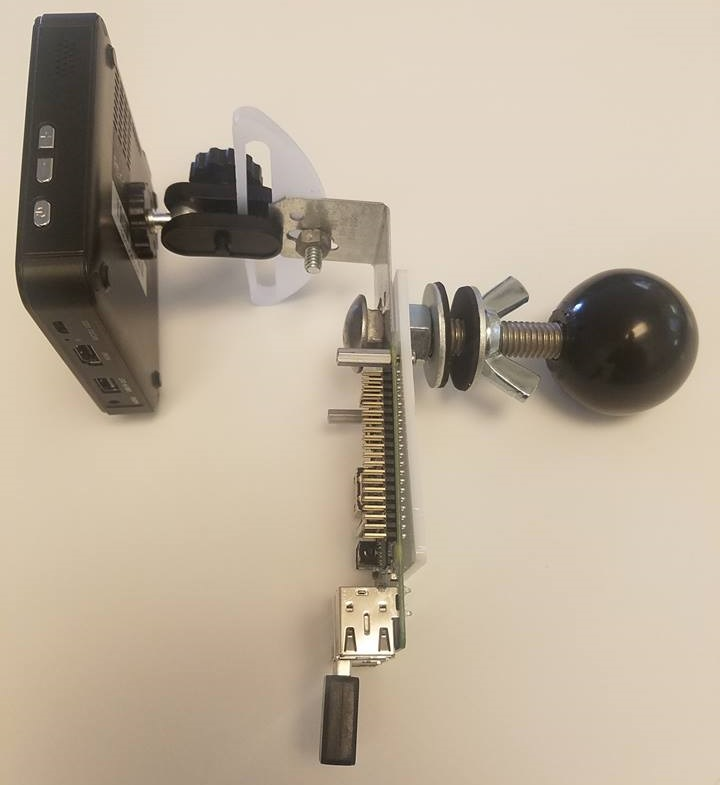
ProjectFiles/Website/images/mount2.jpg
