AndresMtzP/Globetrotters/ProjectFiles/Website/images/mount3.jpg

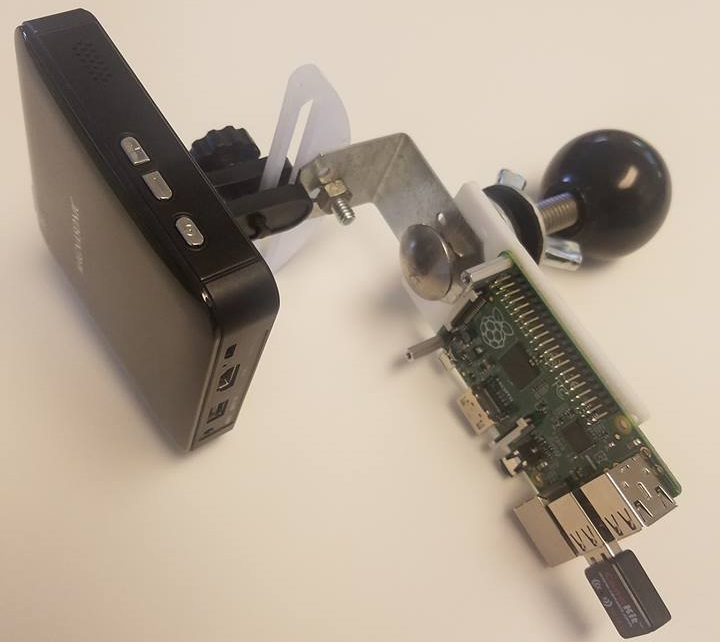
ProjectFiles/Website/images/mount3.jpg
