AndresMtzP/Globetrotters/ProjectFiles/Website/images/mount4.jpg

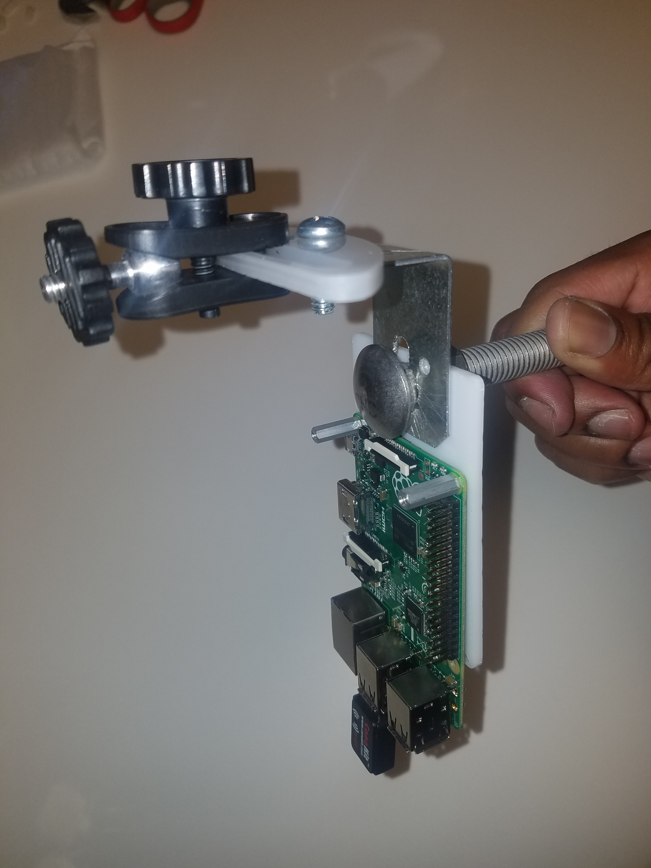
ProjectFiles/Website/images/mount4.jpg
