AndresMtzP/Globetrotters/ProjectFiles/Website/images/mount5.jpg

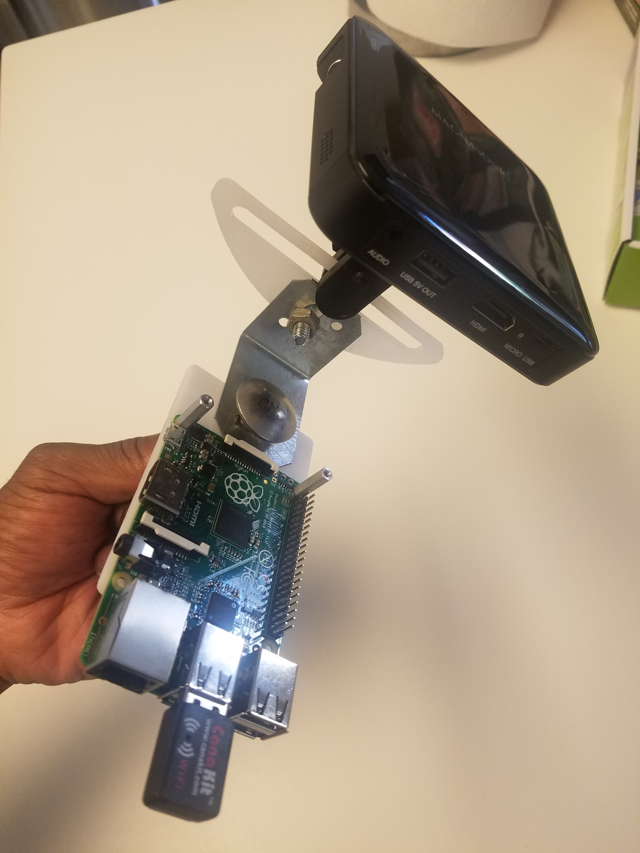
ProjectFiles/Website/images/mount5.jpg
