AndresMtzP/Globetrotters/ProjectFiles/Website/images/physexplosion.jpg

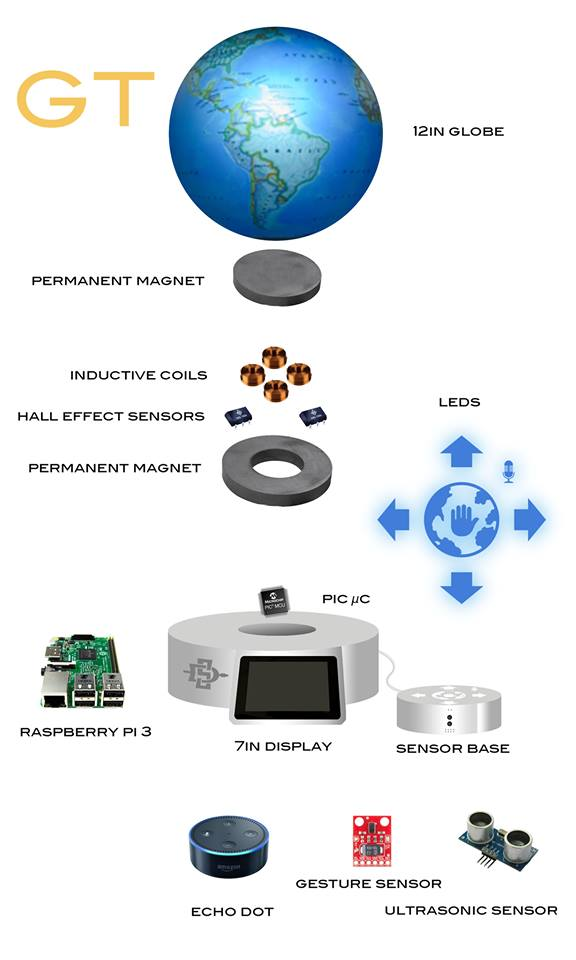
ProjectFiles/Website/images/physexplosion.jpg
