AndresMtzP/Globetrotters/ProjectFiles/Website/images/pic24.png

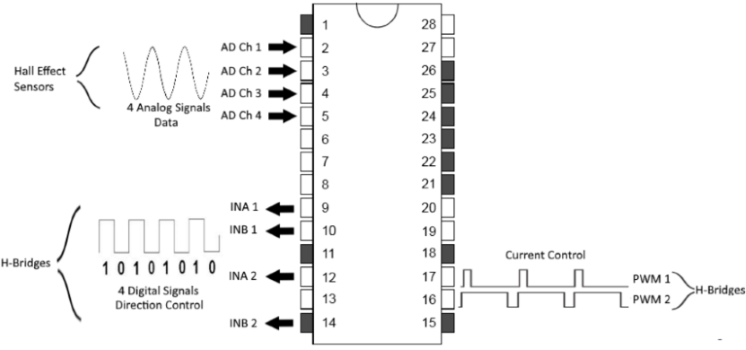
ProjectFiles/Website/images/pic24.png
