AndresMtzP/Globetrotters/ProjectFiles/Website/images/proj1.png

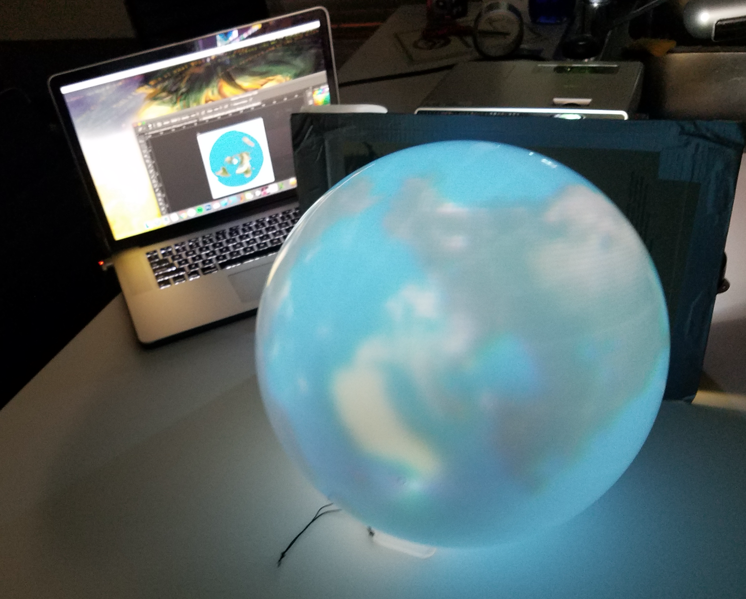
ProjectFiles/Website/images/proj1.png
