AndresMtzP/Globetrotters/ProjectFiles/Website/images/projglobe2.jpg

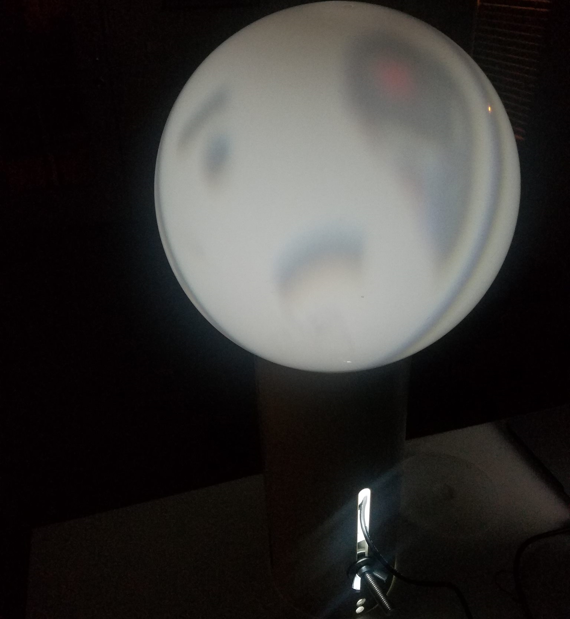
ProjectFiles/Website/images/projglobe2.jpg
