AndresMtzP/Globetrotters/ProjectFiles/Website/images/projglobe.jpg

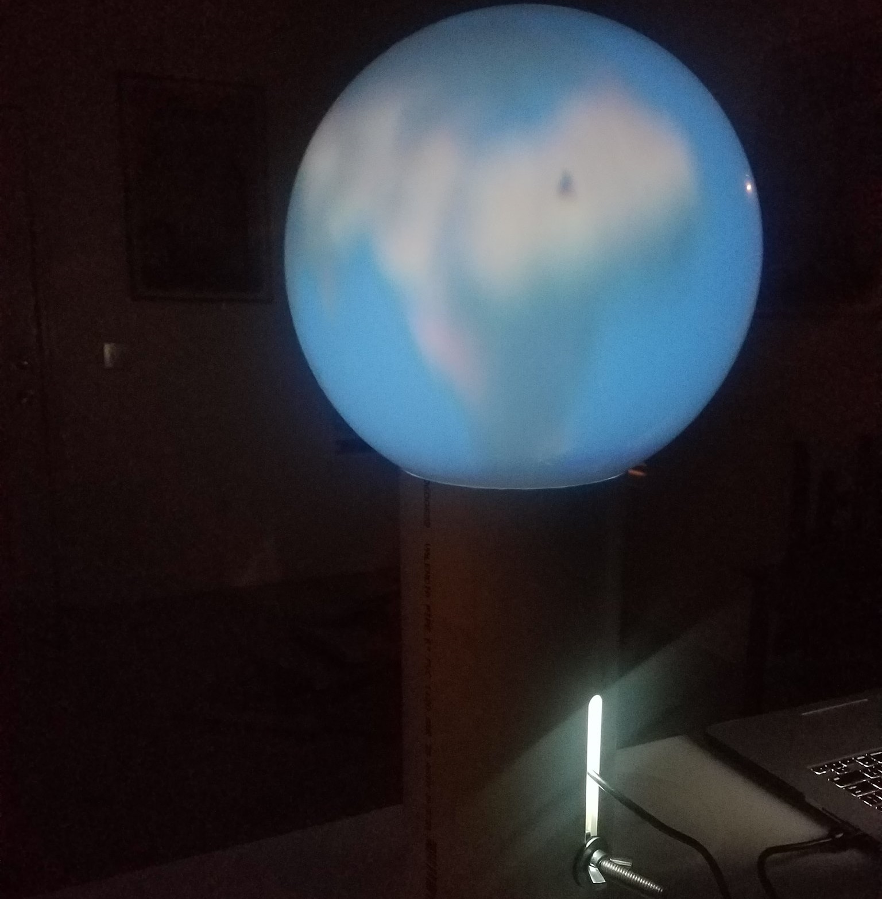
ProjectFiles/Website/images/projglobe.jpg
