AndresMtzP/Globetrotters/ProjectFiles/Website/images/projglobe.png

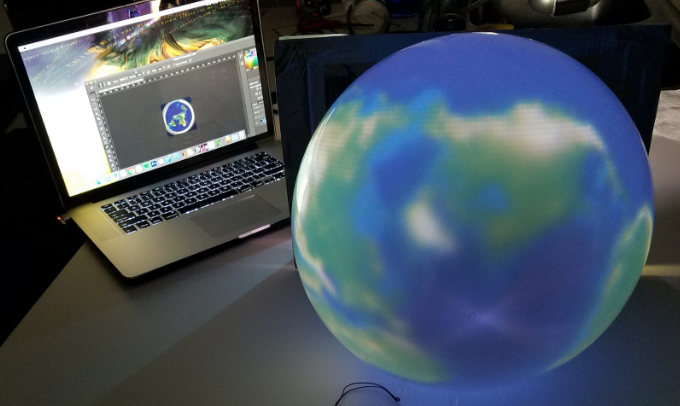
ProjectFiles/Website/images/projglobe.png
