AndresMtzP/Globetrotters/ProjectFiles/Website/images/projtest4.png

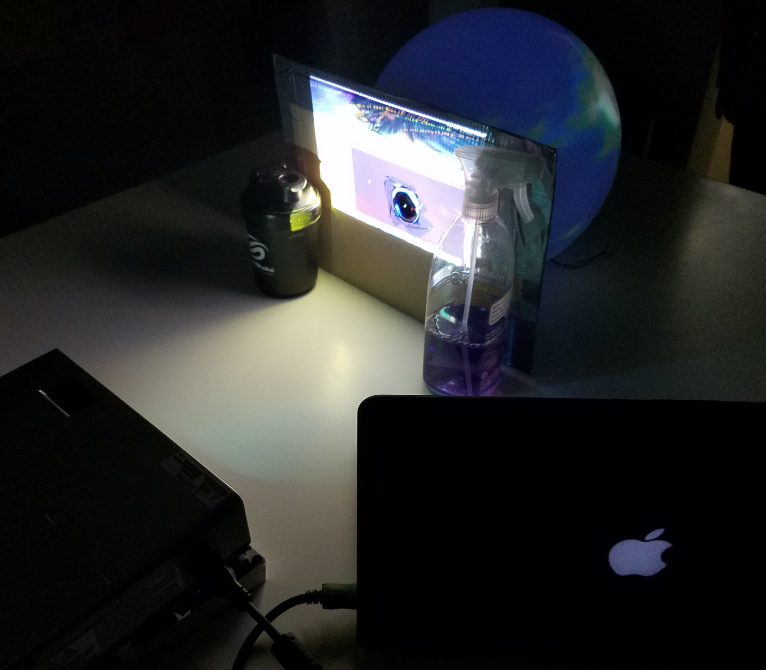
ProjectFiles/Website/images/projtest4.png
