AndresMtzP/Globetrotters/ProjectFiles/Website/images/secondrevpcb.jpg

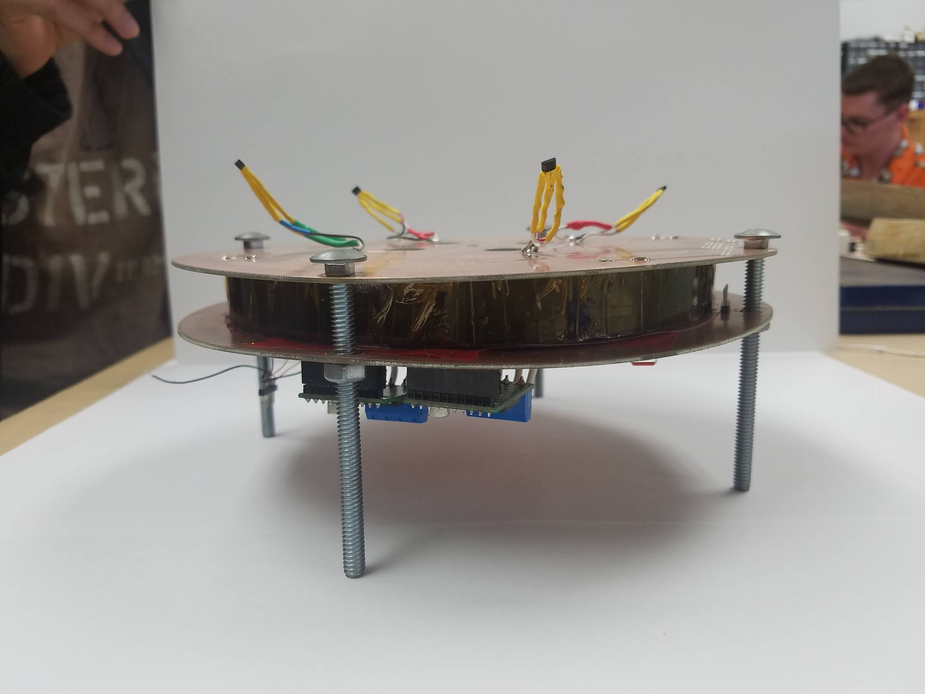
ProjectFiles/Website/images/secondrevpcb.jpg
