AndresMtzP/Globetrotters/ProjectFiles/Website/images/secondrevtop2.png

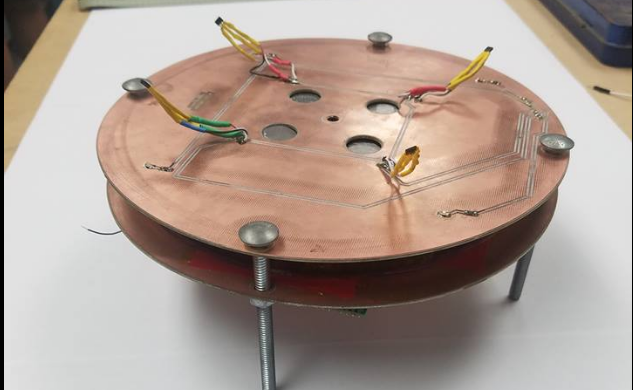
ProjectFiles/Website/images/secondrevtop2.png
