AndresMtzP/Globetrotters/ProjectFiles/Website/images/secondrevtop.png

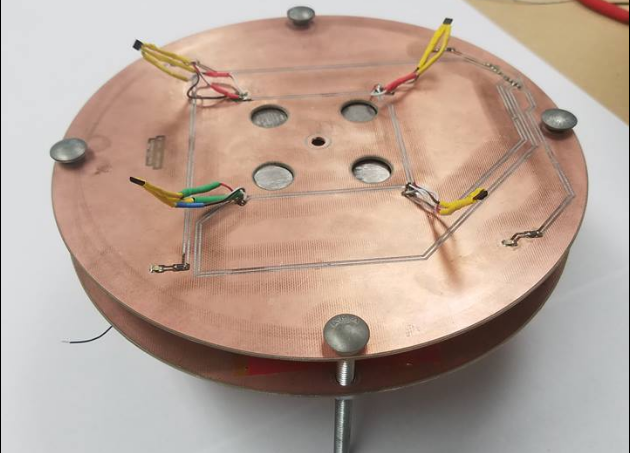
ProjectFiles/Website/images/secondrevtop.png
