AndresMtzP/Globetrotters/ProjectFiles/Website/images/software_flow.png

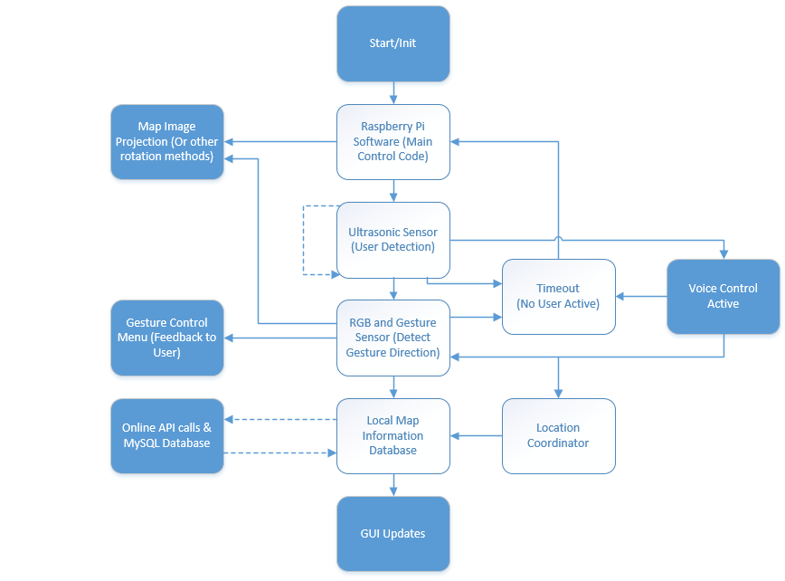
ProjectFiles/Website/images/software_flow.png
