AndresMtzP/Globetrotters/ProjectFiles/Website/images/sponsors.png

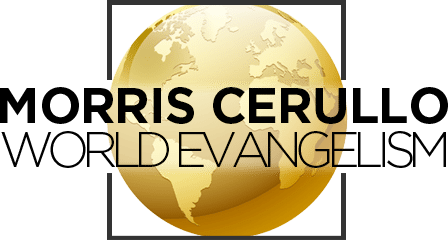
ProjectFiles/Website/images/sponsors.png
