AndresMtzP/Globetrotters/ProjectFiles/Website/images/stand2.jpg

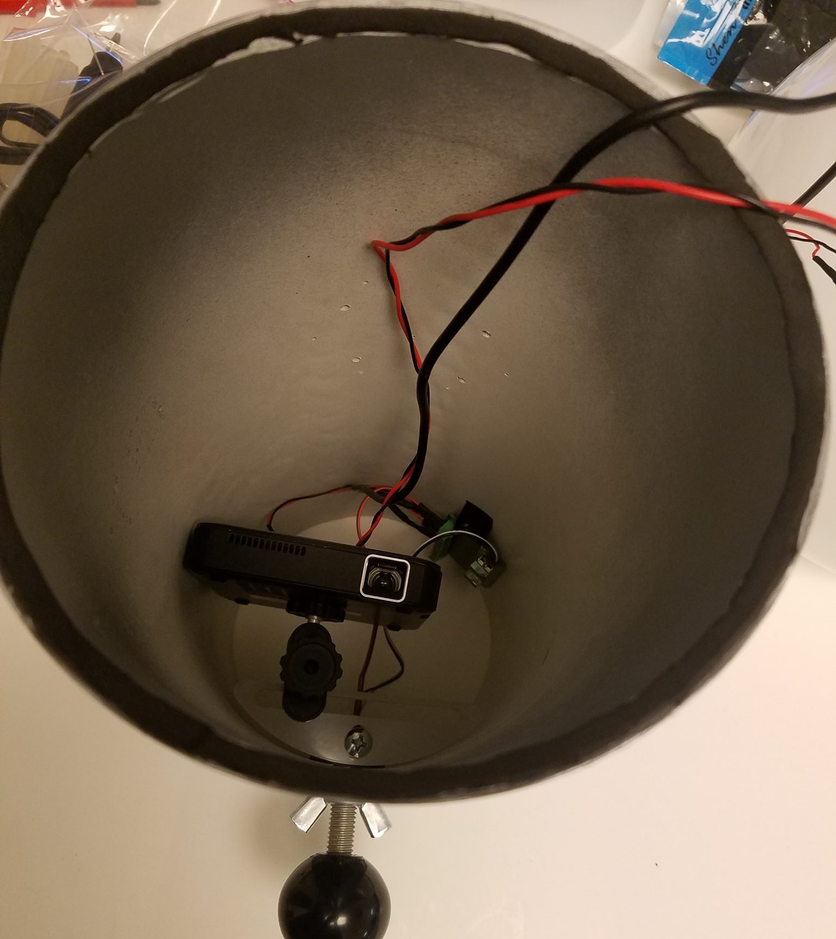
ProjectFiles/Website/images/stand2.jpg
