AndresMtzP/Globetrotters/ProjectFiles/Website/images/stand3.jpg

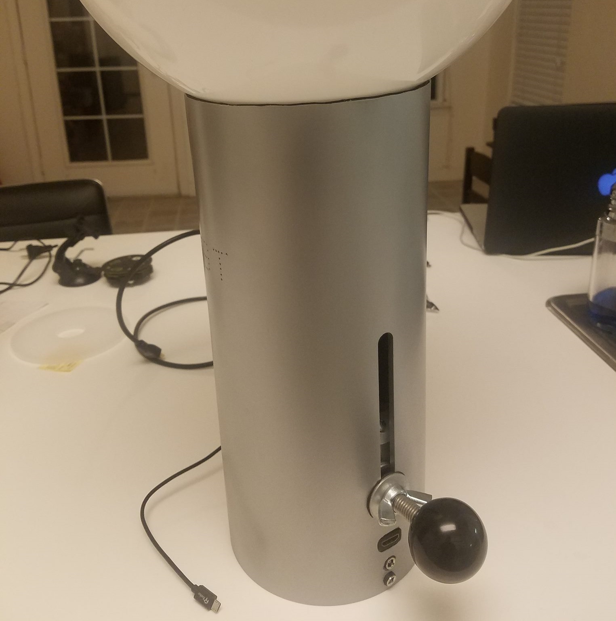
ProjectFiles/Website/images/stand3.jpg
