AndresMtzP/Globetrotters/ProjectFiles/Website/images/stand.jpg

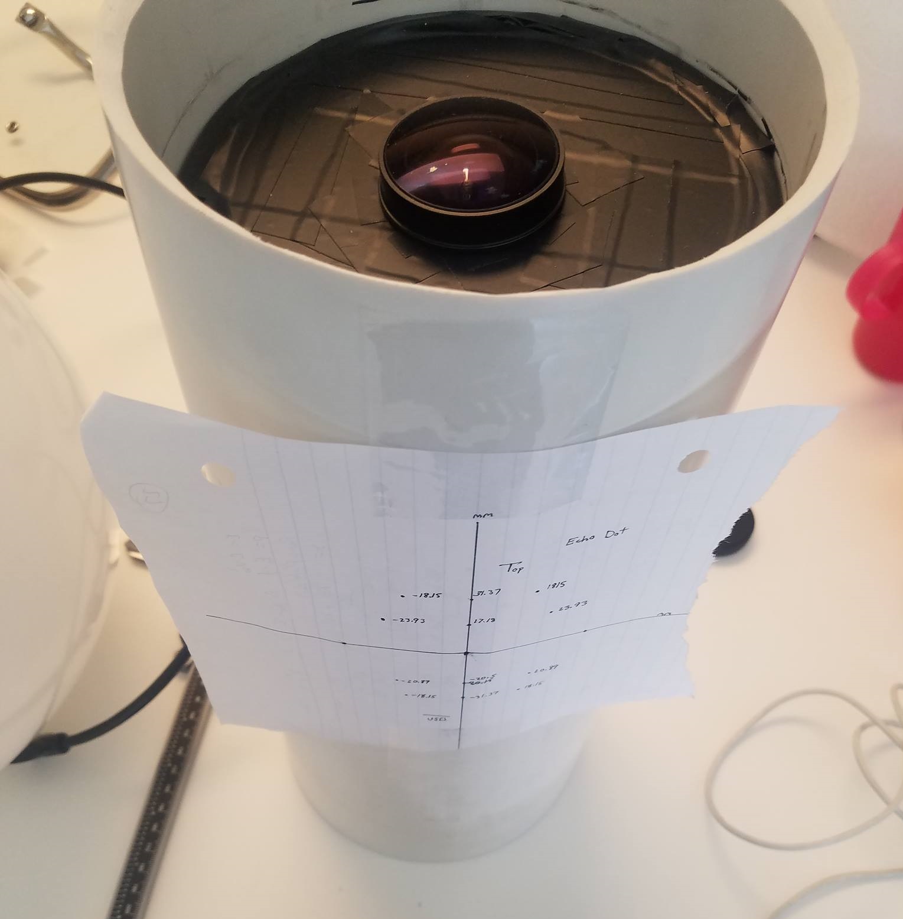
ProjectFiles/Website/images/stand.jpg
