AndresMtzP/Globetrotters/ProjectFiles/Weekly Reports/02-09-2017/20170208_204041.jpg

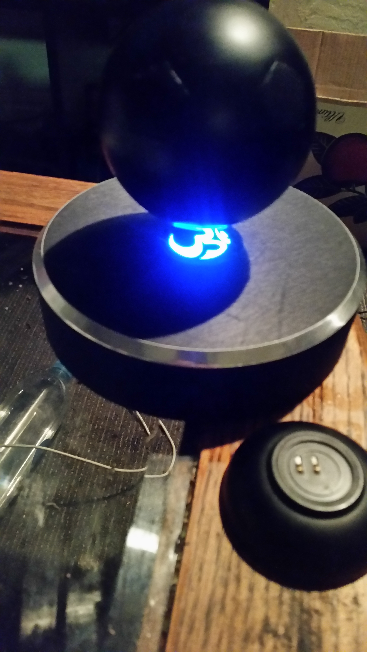
ProjectFiles/Weekly Reports/02-09-2017/20170208_204041.jpg
