AndresMtzP/Globetrotters/ProjectFiles/Project/PCB design/GTLibrary/Notes/LIB PART INFO.xls

Sheet: PART INFORMATION
ECE MENTOR GRAPHICS LIBRARY PARTS INFORMATION FILE
FILE NAME: LIB PART INFO
DIR:C:/Documents and Settings/blizzard/Desktop/ECE Lib Info
 |  | PART ORDERING INFORMATION |  |  |  |  |  |  | PARTITION INFORMATION |  |  |  |  |  |  | PAD STACK INFORMATION
RESITORS - THRU - MOUNT - CARBON FILM - 5%Tol |  |  |  |  |  |  |  | RESITORS - CARBON - 1/4Watt - 5%Tol |  |  |  |  |  |  |  | RESITORS - CARBON - 1/4Watt - 5%Tol
DESCRIPTION | VALUE | DISTRIBUTOR | BRAND | PART # | Ls (mm) | Ls (in) | Lead dia (in) | PART PARTITION | PART NAME | SYMBOL PARTITION | SYMBOL NAME | SYMBOL IMPORT | CELL PARTITION | CELL NAME | CELL IMPORT | PADSTACK | PAD TYPE | HOLE | Drill # | COMMENTS
1/4Watt | ALL | MOUSER | XICON | 291-XXX / 1000 | 30.7 | 0.475 | 0.024 | RESISTORS | RES.25W | RESISTORS | RES | EE210.lmc | RESISTORS | RC07_.25W | vbcore.lmc / RC07 | RND_45pad_27.6drl_T301 | Round 45 | 27.6th | T301 | Verified Cell
1/2Watt | ALL | MOUSER | XICON |  |  |  |  | RESISTORS | RES_.5W | RESISTORS | RES | EE210.lmc | RESISTORS | RC07_.5W | vbcore.lmc / RC07 | RND_45pad_27.6drl_T301 | Round 45 | 27.6th | T301
1Watt | ALL | MOUSER | XICON |  |  |  |  |  |  | RESISTORS | RES | EE210.lmc | RESISTORS
 |  |  |  |  |  |  |  |  |  |  |  |  |  |  |  |  |  |  |  | Verified Cell
RESISTORS - THROUGH - SIP |  |  |  |  |  |  |  | RESISTORS - SIP |  |  |  |  |  |  |  | RESISTORS - SIP
DESCRIPTION | VALUE | DISTRIBUTOR | BRAND | PART # | Ls(mm) | Ls(in) | Lead dia (in) | PART PARTITION | PART NAME | SYMBOL PARTITION | SYMBOL NAME | SYMBOL IMPORT | CELL PARTITION | CELL NAME | CELL IMPORT | PAD STACK | PAD TYPE | HOLE | DRILL # | COMMENTS
10Pin Sip Package Resistors | ALL | MOUSER | XICON | 266-Value | 2.54 | 0.1 | 0.025 | RESISTORS | 10Pin_Sip | Resistors | RES | EE210.lmc | RESISTORS | SIP10 | vbcore.lmc / SIP10 | RND _55pad_35.4drl_T303 | Round 55 | 35.4th | T303 | Common Buss Pin = Sqare Pin / Cell Verified
RESISTORS - THRU - MOUNT - TRIM |  |  |  |  |  |  |  | RESISTORS - TRIM |  |  |  |  |  |  |  | RESISTORS - TRIM
DESCRIPTION | VALUE | DISTRIBUTOR | BRAND | PART # | LS (MM) | LS (in) | LEAD dia (in) | PART PARTITION | PART NAME | SYMBOL PARTITION | SYMBOL NAME | SYMBOL IMPORT | CELL PARTITION | CELL NAME | CELL IMPORT | PAD STACK | PAD TYPE | HOLE | DRILL # | COMMENTS
BOURNS TYPE 3386P | ALL | MOUSER | BOURNS | SEE CATALOG | 2.54 | 0.1 | 0.02 | POTENTIOMETERS | TRIM_POT | POTENTIOMETERS | POT | vbcore.lmc / POT | POTENTIOMETERS | TRIM_3386P | ECECore.lmc | RND_50pad_27.6drl_T301 | Round 50 | 27.6th | T301 | CELL UNVERIFIED
BOURNS TYPE 3386C | ALL | MOUSER | BOURNS | SEE CATALOG | 2.54 | 0.1 | 0.02 | POTENTIOMETERS | TRIM_POT | POTENTIOMETERS | POT | vbcore.lmc / POT | POTENTIOMETERS | TRIM_3386C | ECECore.lmc | RND_50pad_27.6drl_T301 | Round 50 | 27.6th | T301 | CELL UNVERIFIED
RESISTORS - SURFACE - MOUNT |  |  |  |  |  |  |  | RESISTORS - SURFACE - MOUNT |  |  |  |  |  |  |  | RESISTORS - SURFACE - MOUNT
DESCRIPTION | VALUE | DISTRIBUTOR | BRAND | PART # | LS (MM) | LS (in) | LEAD dia (in) | PART PARTITION | PART NAME | SYMBOL PARTITION | SYMBOL NAME | SYMBOL IMPORT | CELL PARTITION | CELL NAME | CELL IMPORT | PAD STACK | PAD TYPE | HOLE | DRILL # | COMMENTS
CAPACITORS - ELECTROLYTIC - 50V |  |  |  |  |  |  |  | CAPACITORS - ELECTROLYTIC - 50V |  |  |  |  |  |  |  | CAPACITORS - ELECTROLYTIC - 50V
DESCRIPTION | VALUE uF | DISTRIBUTOR | BRAND | PART # | Ls (mm) | Ls (in) | Ld (in) | PART PARTITION | PART NAME | SYMBOL PARTITION | SYMBOL NAME | SYMBOL IMPORT | CELL PARTITION | CELL NAME | CELL IMPORT | PADSTACK | PAD TYPE | HOLE | Drill # | COMMENTS
 | 1 | MOUSER | XICON | 140-XRL50V1.0 | 2.0 | 0.0787 | 0.0197 | Capacitors_Electrolytic | 1uF | Capacitors_Electrolytic | 1uF | vbcore.lmc / ECAP | Capacitors_Electrolytic | 1_10uF_Electrolytic | ECECore.lmc | RND_35pad_27.6drl_T301 | RND/SQR 35 | 27.6th | T301
 | 2.2 | MOUSER |  |  | 2.0 | 0.0787 | 0.0197 | Capacitors_Electrolytic | 2.2uF | Capacitors_Electrolytic | 2.2uF | vbcore.lmc / ECAP | Capacitors_Electrolytic | 1_10uF_Electrolytic | ECECore.lmc | RND_35pad_27.6drl_T301 | RND/SQR 35 | 27.6th | T301
 | 3.3 | MOUSER | XICON | 140-XRL50V3.3 | 2.0 | 0.0787 | 0.0197 | Capacitors_Electrolytic | 3.3uF | Capacitors_Electrolytic | 3.3uF | vbcore.lmc / ECAP | Capacitors_Electrolytic | 1_10uF_Electrolytic | ECECore.lmc | RND_35pad_27.6drl_T301 | RND/SQR 35 | 27.6th | T301
 | 4.7 | MOUSER |  |  | 2.0 | 0.0787 | 0.0197 | Capacitors_Electrolytic | 4.7uF | Capacitors_Electrolytic | 4.7uF | vbcore.lmc / ECAP | Capacitors_Electrolytic | 1_10uF_Electrolytic | ECECore.lmc | RND_35pad_27.6drl_T301 | RND/SQR 35 | 27.6th | T301
 | 10 | MOUSER |  |  | 2.0 | 0.0787 | 0.0197 | Capacitors_Electrolytic | 10uF | Capacitors_Electrolytic | 10uF | vbcore.lmc / ECAP | Capacitors_Electrolytic | 1_10uF_Electrolytic | ECECore.lmc | RND_35pad_27.6drl_T301 | RND/SQR 35 | 27.6th | T301
 | 22 | MOUSER |  |  | 2.5 | 0.0984 | 0.0197 | Capacitors_Electrolytic | 22uF | Capacitors_Electrolytic | 22uF | vbcore.lmc / ECAP | Capacitors_Electrolytic | 22_33uF_Electrolytic | ECECore.lmc | RND_45pad_27.6drl_T301 | RND/SQR 45 | 27.6th | T301
 | 33 | MOUSER | XICON | 140-XRL50V33 | 2.5 | 0.0984 | 0.0197 | Capacitors_Electrolytic | 33uF | Capacitors_Electrolytic | 33uF | vbcore.lmc / ECAP | Capacitors_Electrolytic | 22_33uF_Electrolytic | ECECore.lmc | RND_45pad_27.6drl_T301 | RND/SQR 45 | 27.6th | T301
 | 47 | MOUSER |  |  | 3.5 | 0.1377 | 0.0197 | Capacitors_Electrolytic | 47uF | Capacitors_Electrolytic | 47uF | vbcore.lmc / ECAP | Capacitors_Electrolytic | 47_100uF_Electrolytic | ECECore.lmc | RND_45pad_27.6drl_T301 | RND/SQR 45 | 27.6th | T301
 | 100 | MOUSER | XICON | 140-XRL50V100 | 3.5 | 0.1377 | 0.0237 | Capacitors_Electrolytic | 100uF | Capacitors_Electrolytic | 100uF | vbcore.lmc / ECAP | Capacitors_Electrolytic | 47_100uF_Electrolytic | ECECore.lmc | RND_45pad_27.6drl_T301 | RND/SQR 65 | 27.6th | T301
 | 220 | MOUSER |  |  | 5.0 | 0.1968 | 0.0237 | Capacitors_Electrolytic | 220uF | Capacitors_Electrolytic | 220uF | vbcore.lmc / ECAP | Capacitors_Electrolytic | 220_470uF_Electrolytic | ECECore.lmc | RND_75pad_31.5drl_T302 | RND/SQR 75 | 27.6th | T302
 | 330 | MOUSER | XICON | 140-XRL50V330 | 5.0 | 0.1968 | 0.0237 | Capacitors_Electrolytic | 330uF | Capacitors_Electrolytic | 330uF | vbcore.lmc / ECAP | Capacitors_Electrolytic | 220_470uF_Electrolytic | ECECore.lmc | RND_75pad_31.5drl_T302 | RND/SQR 75 | 27.6th | T302
 | 470 | MOUSER |  |  | 5.0 | 0.1968 | 0.0237 | Capacitors_Electrolytic | 470uF | Capacitors_Electrolytic | 470uF | vbcore.lmc / ECAP | Capacitors_Electrolytic | 220_470uF_Electrolytic | ECECore.lmc | RND_75pad_31.5drl_T302 | RND/SQR 75 | 27.6th | T302
 | 1000 | MOUSER |  |  | 7.5 | 0.2952 | 0.0315 | Capacitors_Electrolytic | 1000uF | Capacitors_Electrolytic | 1000uF | vbcore.lmc / ECAP | Capacitors_Electrolytic | 1000uF_Electrolytic | ECECore.lmc | RND_75pad_35.4drl_T303 | RND/SQR 75 | 27.6th | T303
 | Any Other |  |  |  |  |  |  | Capacitors_Electrolytic | Cap_Elect | Capacitors_Electrolytic | ECAP | vbcore.lmc / ECAP | Capacitors_Electrolytic | All Electrolytic Cells Available | ECECore.lmc
CAPACITORS - POLYESTER FILM (100V) 10% TOL |  |  |  |  |  |  |  | CAPACITORS - POLYESTER FILM (100V) 10% TOL |  |  |  |  |  |  |  | CAPACITORS - POLYESTER FILM (100V) 10% TOL
DESCRIPTION | VALUE uF | DISTRIBUTOR | BRAND | PART # | Ls (mm) | Ls (in) | Ld (in) | PART PARTITION | PART NAME | SYMBOL PARTITION | SYMBOL NAME | SYMBOL IMPORT | CELL PARTITION | CELL NAME | CELL IMPORT | PADSTACK | PAD TYPE | HOLE | Drill # | COMMENTS
 | 0.001 | MOUSER | XICON | 140-PF2A102K | 3.5 | 0.138 | 0.0197 | Capacitors_ Film | .001uF | Capacitors_Non Polarized | .001uF | EE210.lmc / Cap_NP | Capacitors_Non_Polarized | .001_.01_Film | ECECore.lmc | RND_45pad_27.6drl_T301 | Round 45 | 27.6th | T301
 | 0.0022 | MOUSER | XICON | 140-PF2A222K | 3.5 | 0.138 | 0.0197 | Capacitors_ Film | .0022uF | Capacitors_Non Polarized | .0022uF | EE210.lmc / Cap_NP | Capacitors_Non_Polarized | .001_.01_Film | ECECore.lmc | RND_45pad_27.6drl_T301 | Round 45 | 27.6th | T301
 | 0.0033 | MOUSER | XICON | 140-PF2A332K | 3.5 | 0.138 | 0.0197 | Capacitors_ Film | .0033uF | Capacitors_Non Polarized | .0033uF | EE210.lmc / Cap_NP | Capacitors_Non_Polarized | .001_.01_Film | ECECore.lmc | RND_45pad_27.6drl_T301 | Round 45 | 27.6th | T301
 | 0.0047 | MOUSER | XICON | 140-PF2A472K | 3.5 | 0.138 | 0.0197 | Capacitors_ Film | .0047uF | Capacitors_Non Polarized | .0047uF | EE210.lmc / Cap_NP | Capacitors_Non_Polarized | .001_.01_Film | ECECore.lmc | RND_45pad_27.6drl_T301 | Round 45 | 27.6th | T301
 | 0.0056 | MOUSER | XICON | 140-PF2A562K | 3.5 | 0.138 | 0.0197 | Capacitors_ Film | .0056uF | Capacitors_Non Polarized | .0056uF | EE210.lmc / Cap_NP | Capacitors_Non_Polarized | .001_.01_Film | ECECore.lmc | RND_45pad_27.6drl_T301 | Round 45 | 27.6th | T301
 | 0.0068 | MOUSER | XICON | 140-PF2A682K | 3.5 | 0.138 | 0.0197 | Capacitors_ Film | .0068uF | Capacitors_Non Polarized | .0068uF | EE210.lmc / Cap_NP | Capacitors_Non_Polarized | .001_.01_Film | ECECore.lmc | RND_45pad_27.6drl_T301 | Round 45 | 27.6th | T301
 | 0.0082 | MOUSER | XICON | 140-PF2A822K | 3.5 | 0.138 | 0.0197 | Capacitors_ Film | .0082uF | Capacitors_Non Polarized | .0082uF | EE210.lmc / Cap_NP | Capacitors_Non_Polarized | .001_.01_Film | ECECore.lmc | RND_45pad_27.6drl_T301 | Round 45 | 27.6th | T301
 | 0.01 | MOUSER | XICON | 140-PF2A103K | 3.5 | 0.138 | 0.0197 | Capacitors_ Film | .01uF | Capacitors_Non Polarized | .01uF | EE210.lmc / Cap_NP | Capacitors_Non_Polarized | .001_.01_Film | ECECore.lmc | RND_45pad_27.6drl_T301 | Round 45 | 27.6th | T301 | out of stock
 | 0.022 | MOUSER | XICON | 140-PF2A223K | 4.0 | 0.157 | 0.0197 | Capacitors_ Film | .022uF | Capacitors_Non Polarized | .022uF | EE210.lmc / Cap_NP | Capacitors_Non_Polarized | .022_.056_Film | ECECore.lmc | RND_45pad_27.6drl_T301 | Round 45 | 27.6th | T301
 | 0.027 | MOUSER | XICON | 140-PF2A273K | 4.0 | 0.157 | 0.0197 | Capacitors_ Film | .027uF | Capacitors_Non Polarized | .027uF | EE210.lmc / Cap_NP | Capacitors_Non_Polarized | .022_.056_Film | ECECore.lmc | RND_45pad_27.6drl_T301 | Round 45 | 27.6th | T301
 | 0.047 | MOUSER | XICON | 140-PF2A473K | 5.0 | 0.197 | 0.0197 | Capacitors_ Film | .047uF | Capacitors_Non Polarized | .047uF | EE210.lmc / Cap_NP | Capacitors_Non_Polarized | .022_.056_Film | ECECore.lmc | RND_45pad_27.6drl_T301 | Round 45 | 27.6th | T301
 | 0.056 | MOUSER | XICON | 140-PF2A563K | 5.0 | 0.197 | 0.0197 | Capacitors_ Film | .056uF | Capacitors_Non Polarized | .056uF | EE210.lmc / Cap_NP | Capacitors_Non_Polarized | .022_.056_Film | ECECore.lmc | RND_45pad_27.6drl_T301 | Round 45 | 27.6th | T301
 | 0.068 | MOUSER | XICON | 140-PF2A683K | 7.5 | 0.295 | 0.0197 | Capacitors_ Film | .068uF | Capacitors_Non Polarized | .068uF | EE210.lmc / Cap_NP | Capacitors_Non_Polarized | .068_Film | ECECore.lmc | RND_45pad_27.6drl_T301 | Round 45 | 27.6th | T301
 | 0.1 | MOUSER | XICON | 140-PF2A104K | 7.5 | 0.295 | 0.0197 | Capacitors_ Film | .1uF | Capacitors_Non Polarized | .1uF | EE210.lmc / Cap_NP | Capacitors_Non_Polarized | .1_Film | ECECore.lmc | RND_45pad_27.6drl_T301 | Round 45 | 27.6th | T301
 | 0.22 | MOUSER | XICON | 140-PF2A224K | 9.0 | 0.354 | 0.0197 | Capacitors_ Film | .22uF | Capacitors_Non Polarized | .22uF | EE210.lmc / Cap_NP | Capacitors_Non_Polarized | .22_Film | ECECore.lmc | RND_45pad_27.6drl_T301 | Round 45 | 27.6th | T301
 | 0.27 | MOUSER | XICON | 140-PF2A274K | 9.0 | 0.354 | 0.0197 | Capacitors_ Film | .27uF | Capacitors_Non Polarized | .27uF | EE210.lmc / Cap_NP | Capacitors_Non_Polarized | .27_.47_Film | ECECore.lmc | RND_45pad_27.6drl_T301 | Round 45 | 27.6th | T301
 | 0.47 | MOUSER | XICON | 140-PF2A474K | 10.0 | 0.394 | 0.0237 | Capacitors_ Film | .47uF | Capacitors_Non Polarized | .47uF | EE210.lmc / Cap_NP | Capacitors_Non_Polarized | .27_.47_Film | ECECore.lmc | RND_45pad_27.6drl_T301 | Round 45 | 27.6th | T301
 | Any Other |  |  |  |  |  |  | Capacitors_ Film | uF_Cap | Capacitors_Non Polarized | Generic_uF_Cap | EE210.lmc / Cap_NP | Capacitors_Non_Polarized | All Non Polarized Cells Available | ECECore.lmc | SEE CELL NAMES
CAPACITORS - CERAMIC - 5% |  |  |  |  |  |  |  |  | CAPACITORS - CERAMIC - 5% |  |  |  |  |  |  | CAPACITORS - CERAMIC - 5%
DESCRIPTION | VALUE pF | DISTRIBUTOR | BRAND | PART # | Ls (mm) | Ls (in) | Ld (in) | PART PARTITION | PART NAME | SYMBOL PARTITION | SYMBOL NAME | SYMBOL IMPORT | CELL PARTITION | CELL NAME | CELL IMPORT | PADSTACK | Pad Size | Hole dia (in) | Drill # | COMMENTS
 | 22 | MOUSER | XICON | 140-100N5-220J | 5.0 | 0.197 | 0.0197 | Capacitors_Ceramic | 22pF | Capacitors_Non Polarized | 22pF | EE210.lmc / Cap_NP | Capacitors_Non_Polarized | pF_CAP | ECECore.lmc | RND_45pad_27.6drl_T301 | Round 45 | 27.6th | T301
 | 33 | MOUSER | XICON | 140-100N5-330J | 5.0 | 0.197 | 0.0197 | Capacitors_Ceramic | 33pF | Capacitors_Non Polarized | 33pF | EE210.lmc / Cap_NP | Capacitors_Non_Polarized | pF_CAP | ECECore.lmc | RND_45pad_27.6drl_T301 | Round 45 | 27.6th | T301
 | 47 | MOUSER | XICON | 140-100N5-470J | 5.0 | 0.197 | 0.0197 | Capacitors_Ceramic | 47pF | Capacitors_Non Polarized | 47pF | EE210.lmc / Cap_NP | Capacitors_Non_Polarized | pF_CAP | ECECore.lmc | RND_45pad_27.6drl_T301 | Round 45 | 27.6th | T301
 | 56 | MOUSER | XICON | 140-100N5-560J | 5.0 | 0.248 | 0.0197 | Capacitors_Ceramic | 56pF | Capacitors_Non Polarized | 56pF | EE210.lmc / Cap_NP | Capacitors_Non_Polarized | pF_CAP | ECECore.lmc | RND_45pad_27.6drl_T301 | Round 45 | 27.6th | T301
 | 68 | MOUSER | XICON | 140-100N5-680J | 5.0 | 0.248 | 0.0197 | Capacitors_Ceramic | 68pF | Capacitors_Non Polarized | 68pF | EE210.lmc / Cap_NP | Capacitors_Non_Polarized | pF_CAP | ECECore.lmc | RND_45pad_27.6drl_T301 | Round 45 | 27.6th | T301
 | 100 | MOUSER | XICON | 140-100N5-101J | 5.0 | 0.197 | 0.0197 | Capacitors_Ceramic | 100pF | Capacitors_Non Polarized | 100pF | EE210.lmc / Cap_NP | Capacitors_Non_Polarized | pF_CAP | ECECore.lmc | RND_45pad_27.6drl_T301 | Round 45 | 27.6th | T301
 | 180 | MOUSER | XICON |  | 5.0 | 0.197 | 0.0197 | Capacitors_Ceramic | 180pF | Capacitors_Non Polarized | 180pF | EE210.lmc / Cap_NP | Capacitors_Non_Polarized | pF_CAP | ECECore.lmc | RND_45pad_27.6drl_T301 | Round 45 | 27.6th | T301
 | 270 | MOUSER | XICON |  | 5.0 | 0.197 | 0.0197 | Capacitors_Ceramic | 270pF | Capacitors_Non Polarized | 270pF | EE210.lmc / Cap_NP | Capacitors_Non_Polarized | pF_CAP | ECECore.lmc | RND_45pad_27.6drl_T301 | Round 45 | 27.6th | T301
 | 330 | MOUSER | XICON |  | 5.0 | 0.197 | 0.0197 | Capacitors_Ceramic | 330pF | Capacitors_Non Polarized | 330pF | EE210.lmc / Cap_NP | Capacitors_Non_Polarized | pF_CAP | ECECore.lmc | RND_45pad_27.6drl_T301 | Round 45 | 27.6th | T301
 | 470 | MOUSER | XICON |  | 5.0 | 0.197 | 0.0197 | Capacitors_Ceramic | 470pF | Capacitors_Non Polarized | 470pF | EE210.lmc / Cap_NP | Capacitors_Non_Polarized | pF_CAP | ECECore.lmc | RND_45pad_27.6drl_T301 | Round 45 | 27.6th | T301
 | 680 | MOUSER | XICON |  | 5.0 | 0.197 | 0.0197 | Capacitors_Ceramic | 680pF | Capacitors_Non Polarized | 680pF | EE210.lmc / Cap_NP | Capacitors_Non_Polarized | pF_CAP | ECECore.lmc | RND_45pad_27.6drl_T301 | Round 45 | 27.6th | T301
 |  |  |  |  |  |  |  |  |  | Capacitors_Non Polarized | Generic_pF_Cap | EE210.lmc / Cap_NP | Capacitors_Non_Polarized | pF_CAP | ECECore.lmc | RND_45pad_27.6drl_T302
OP-AMPS |  |  |  |  |  |  |  | OP-AMPS |  |  |  |  |  |  |  | OP-AMPS - THRU - MOUNT
DESCRIPTION | TYPE | DISTRIBUTOR | BRAND | PART # | SPACING | LS (in) | Lead dia | PART PARTITION | PART NAME | SYMBOL PARTITION | SYMBOL NAME | SYMBOL IMPORT | CELL PARTITION | CELL NAME | CELL IMPORT | PADSTACK | Pad Size | Hole dia (in) | Drill # | COMMENTS
Dual_OP_ Thru | 1458 | MOUSER |  |  | DIP 8 |  |  | OP AMPS | 1458 | OP_AMPS | 1458 | vbcore.lmc / OPAMP5 | DIP_IC's | DIP8 | vbcore.lmc / DIP8 | RND_65pad_27.6drl_T301 | Round 65 | 27.6th | T301
Dual_OP_ Thru | 5532 | MOUSER | NJR | 513-NJM5532D | DIP 8 |  |  | OP AMPS | 5532 | OP_AMPS | 5532 | vbcore.lmc / OPAMP5 | DIP_IC's | DIP8 | vbcore.lmc / DIP8 | RND_65pad_27.6drl_T301 | Round 65 | 27.6th | T301
Dual_OP_ Thru | 4558 | MOUSER | ROHM |  | DIP 8 |  |  | OP AMPS | 4558 | OP_AMPS | 4558 | vbcore.lmc / OPAMP5 | DIP_IC's | DIP8 | vbcore.lmc / DIP8 | RND_65pad_27.6drl_T301 | Round 65 | 27.6th | T301
Dual_OP_ Surface | 4558 | MOUSER | ST | 511-MC4558CD | SO8 |  |  | OP AMPS | 4558 | OP_AMPS | 4558 | vbcore.lmc / OPAMP5 | Surface_IC's | SO8 / SO8NB / SO8WB | vbcore.lmc / SO8/NB/WB | SMT Plus,74th x 24th oblong | 74th x 24th oblong | None | None
Dual_OP_ Surface | 1458 | MOUSER | ST | 511-MC1458D | SO8 |  |  | OP AMPS | 1458 | OP_AMPS | 1458 | vbcore.lmc / OPAMP5 | Surface_IC's | SO8 / SO8NB / SO8WB | vbcore.lmc / SO8/NB/WB | SMT Plus,74th x 24th oblong | 74th x 24th oblong | None | None
INTEGRATED CIRCUITS |  |  |  |  |  |  |  | INTEGRATED CIRCUITS |  |  |  |  |  |  |  | INTEGRATED CIRCUITS
 | TYPE | DISTRIBUTOR | BRAND | PART # | SPACING | LS (in) | Lead dia | PART PARTITION | PART NAME | SYMBOL PARTITION | SYMBOL NAME | SYMBOL IMPORT | CELL PARTITION | CELL NAME | CELL IMPORT | PADSTACK | Pad Size | Hole dia (in) | Drill # | COMMENTS
RS 232 LEVEL SHIFTER | ICL232 | MOUSER | INTERSIL | 570-ICL232CPE | DIP16 | 0.1 | 0.018 | INTEGRATED CIRCUITS | ICL232 | Integrated Circuits | ICL_232 | ECECore.lmc | DIP_IC's | DIP16 | vbcore.lmc | RND_65pad_27.6drl_T301 | Round 65 | 27.6th | T301
A/D LED Display Driver | ICL7107 | JDR/Jameco | INTERSIL | SEE CATALOG | DIP40 | 0.1 | 0.018 | DISPLAY DRIVERS | ICL_7107 | Display Drivers | ICL_7107 | ECECore.lmc | DIP_IC's | DIP40X | vbcore.lmc | RND_65pad_27.6drl_T301 | Round 65 | 27.6th | T301
DIODES - THRU |  |  |  |  |  |  |  | DIODES - RECTIFIYING - ZENER - SIGNAL |  |  |  |  |  |  |  | DIODES - RECTIFIYING - ZENER - SIGNAL
DESCRIPTION | TYPE | DISTRIBUTOR | BRAND | PART # | SPACING | LS (in) | Lead dia | PART PARTITION | PART NAME | SYMBOL PARTITION | SYMBOL NAME | SYMBOL IMPORT | CELL PARTITION | CELL NAME | CELL IMPORT | PADSTACK | Pad Size | Hole dia (in) | Drill # | COMMENTS
Rectifying Diode | 1N4001 |  |  |  |  |  |  | DIODES | 1N4001 | DIODES | 1N4001 | EE330.lmc | DIODES | Diode_1NXXXX_Thru | vbcore.lmc / T18 | RND_60pad_31.5drl_T302 | Round 60 | 31.5th | T302
Rectifying Diode | 1N4003 |  |  |  |  |  |  | DIODES | 1N4003 | DIODES | 1N4003 | EE330.lmc | DIODES | Diode_1NXXXX_Thru | vbcore.lmc / T18 | RND_60pad_31.5drl_T302 | Round 60 | 31.5th | T302
Rectifying Diode | 1N4004 |  |  |  |  |  |  | DIODES | 1N4004 | DIODES | 1N4004 | EE330.lmc | DIODES | Diode_1NXXXX_Thru | vbcore.lmc / T18 | RND_60pad_31.5drl_T302 | Round 60 | 31.5th | T302
Rectifying Diode | 1N4007 |  |  |  |  |  |  | DIODES | 1N4007 | DIODES | 1N4007 | EE330.lmc | DIODES | Diode_1NXXXX_Thru | vbcore.lmc / T18 | RND_60pad_31.5drl_T302 | Round 60 | 31.5th | T302
Signal Diode | 1N914 |  |  |  |  |  |  | DIODES | 1N914 | DIODES | 1N914 | EE330.lmc | DIODES | Diode_1NXXXX_Thru | vbcore.lmc / T18 | RND_60pad_31.5drl_T302 | Round 60 | 31.5th | T302
Zener Diode |  |  |  |  |  |  |  | DIODES | Zener | DIODES | Zener | EE330.lmc | DIODES | Diode_1NXXXX_Thru | vbcore.lmc / T18 | RND_60pad_31.5drl_T302 | Round 60 | 31.5th | T302
FUSE MOUNTS
DESCRIPTION | TYPE | DISTRIBUTOR | BRAND | PART # | SPACING | LS(in) | Lead dia | PART PARTITION | PART NAME | SYMBOL PARTITION | SYMBOL NAME | SYMBOL IMPORT | CELL PARTITION | CELL NAME | CELL IMPORT
PCB MOUNT | 5X20mm |  |  |  |  |  |  | Fuse_Mounts_Sockets | PCBt_5x20mm | Fuses | Fuse | vbcore.lmc / | Fuses | PCB_5X20mm | ECECore.lmc | REC_90x50pad_27.6x60slot | REC_90x50 | 27.6x60slot
PCB MOUNT | 1/4 X 1 1/4 |  |  |  |  |  |  | Fuse_Mounts_Sockets | PCB_1/4x1_1/4 | Fuses | Fuse | vbcore.lmc / | Fuses | PCB_1/4X1_1/4 | ECECore.lmc | REC_90x50pad_27.6x60slot | REC_90x51 | 27.6x60slot

Sheet: CELL INFORMATION
CELL INFORMATION
RESISTORS
RANGE | Cell # | Pad size | Hole size | Drill #
1/4W All Values
1/2W All Values
1W All Values
5W
CAPACITORS ELECTROLYTIC 50V
RANGE | Cell # | Pad size | Hole size | Drill #
1.0uF - 22uF
33uF - 100uF
220uF - 470uF
1000uF
CAPACITORS POLY FILM
RANGE | Cell # | Pad size | Hole size | Drill #
.001uF - .022uF
.047uF - .1uF
.22uF - .47uF
CAPACITORS CERAMIC
RANGE | Cell # | Pad size | Hole size | Drill #
22pF - 680pF
RANGE | Cell # | Pad size | Hole size

Sheet: SEARCH BY CELL#
SEARCH BY CELL #
CELL # | PART | DESCRIPTION
