AndresMtzP/Globetrotters/ProjectFiles/Project/PCB design/GTLibrary/Docs/ECE Lib Info/lpkf  bit  Info.xls

LPKF PCB - DRILL - ROUTER - CUTTER - BIT INFORMATION
File: lpkf bit Info
Updated: 7/01/01
DRILL BITS
PART # | SIZE th | SIZE mm | QTY
T 53 | 59.5 | 1.51 | 10
T 55 | 52.0 | 1.32 | 10
T 72 | 25.0 | 0.635 | 9
T 76 | 20.0 | 0.508 | 10
T 82 | 12.5 | 0.3175 | 8
T 298 | 15.8 | 0.4 | 9
T 299 | 19.7 | 0.5 | 10
T 301 | 27.6 | 0.7 | 10
T302 | 31.5 | 0.8 | 6
T 303 | 35.4 | 0.9 | 9
T 304 | 39.4 | 1.0 | 11
T 305.5 | 45.3 | 1.1 | 10
T 310 | 59.1 | 1.5 | 14
T 315 | 78.7 | 2.0 | 10
T 321.35 Guide Drl | 116.1 | 2.95 | 3
T 322 PCB Drl | 118.1 | 3.0 | 2
ROUTER BITS
PART # | SIZE th | SIZE mm | QTY
RH 300 | 39.4 | 1.0 | 12
RH 302 | 78.7 | 2.0 | 15
CUTTER BITS
PART # | SIZE th | SIZE mm | QTY
C 200 | UNIVERSAL CUTTER |  | 14
