AndresMtzP/Globetrotters/ProjectFiles/Website/images/PCBsetup1.jpg

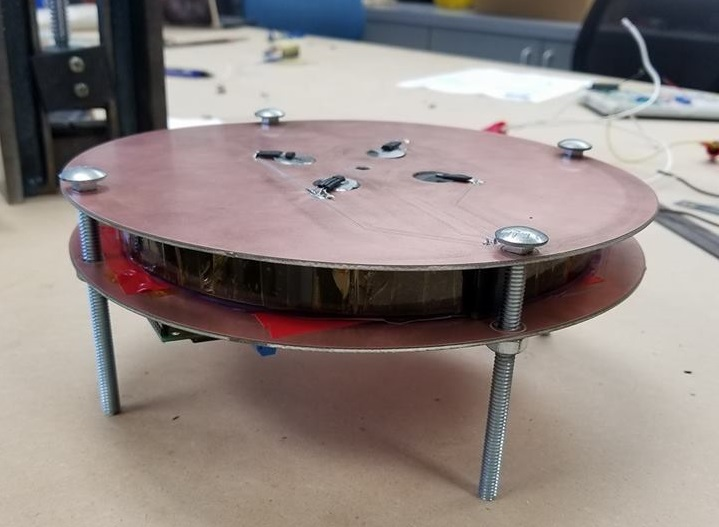
ProjectFiles/Website/images/PCBsetup1.jpg
