AndresMtzP/Globetrotters/ProjectFiles/Website/images/initialtestsetup.jpg

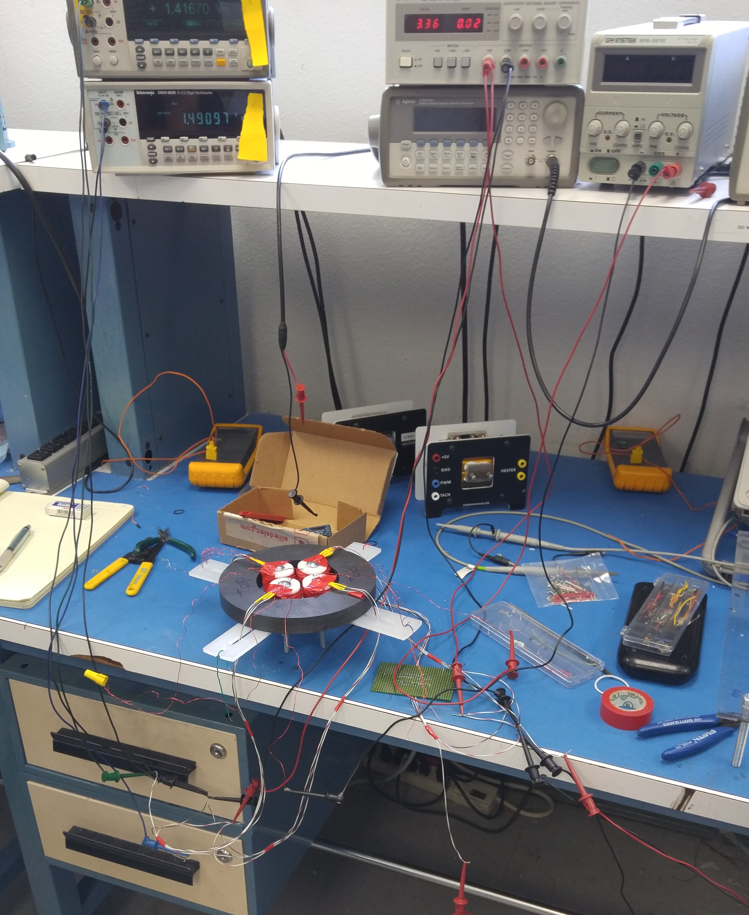
ProjectFiles/Website/images/initialtestsetup.jpg
