AndresMtzP/Globetrotters/ProjectFiles/Website/images/testing.jpg

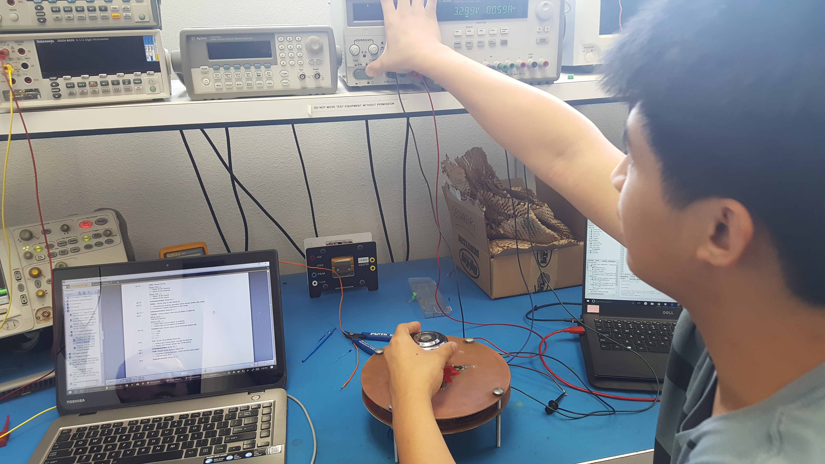
ProjectFiles/Website/images/testing.jpg
