AndresMtzP/Globetrotters/ProjectFiles/Website/images/testproj2.jpg

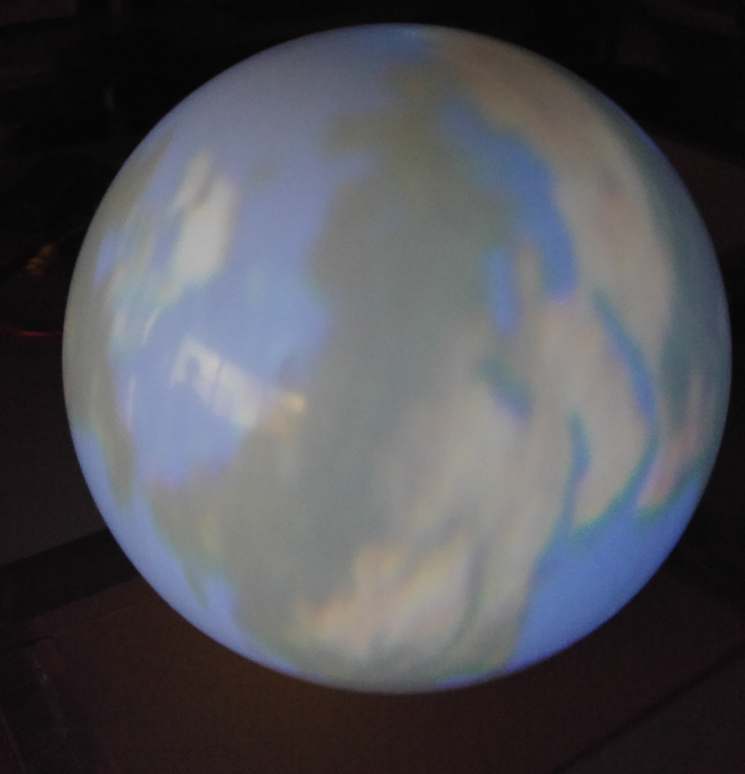
ProjectFiles/Website/images/testproj2.jpg
