AndresMtzP/Globetrotters/ProjectFiles/Website/images/testproj.jpg

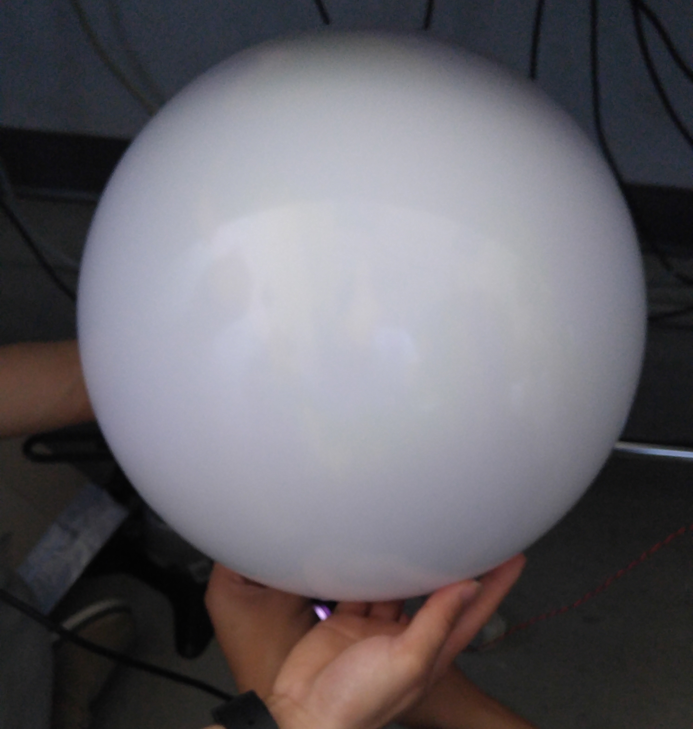
ProjectFiles/Website/images/testproj.jpg
