AndresMtzP/Globetrotters/ProjectFiles/Project/Gesture/SparkFun_APDS-9960_RGB_and_Gesture_Sensor-v10.pdf

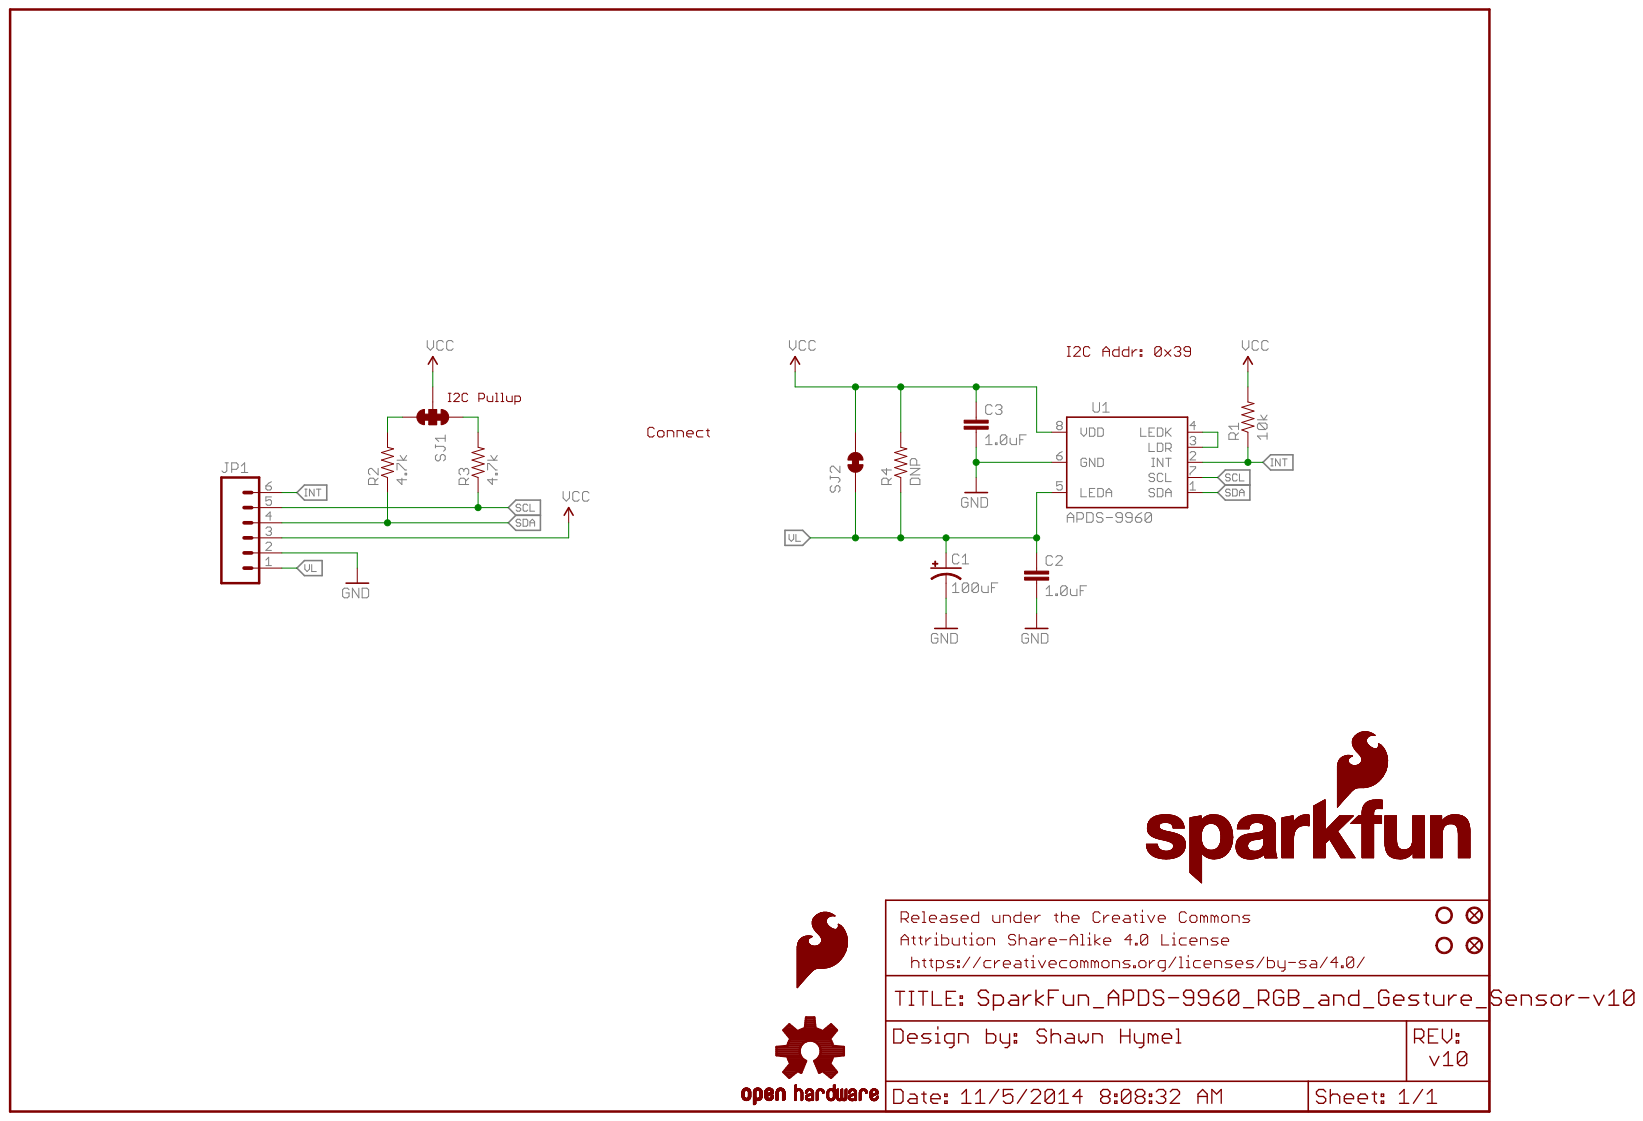
[picture p98: page 1]
