AndresMtzP/Globetrotters/(list of files, drawings)

Other design files:
ProjectFiles/Project/PCB design/Coils_bottom_RevA/PCB/Coils_bottom_2.pcb
ProjectFiles/Project/PCB design/Coils_bottom_RevA/PCB/Layout/LayoutDB.lyt
ProjectFiles/Project/PCB design/Coils_bottom_RevA/PCB/Output/Gerber/Coils_bottom_2.dsn
ProjectFiles/Project/PCB design/Coils_bottom_RevA/PCB/Output/Gerber/Single_7seg.dsn
ProjectFiles/Project/PCB design/Coils_bottom_RevA/PCB/Work/BackupDatabase/LayoutDB.lyt
ProjectFiles/Project/PCB design/Coils_bottom_RevA/PCB/Work/Layout_Temp/LayoutDB.lyt
ProjectFiles/Project/PCB design/Coils_bottom_RevB/PCB/Coils_bottom_2.pcb
ProjectFiles/Project/PCB design/Coils_bottom_RevB/PCB/Layout/LayoutDB.lyt
ProjectFiles/Project/PCB design/Coils_bottom_RevB/PCB/Output/Gerber/Single_7seg.dsn
ProjectFiles/Project/PCB design/Coils_bottom_RevB/PCB/Work/BackupDatabase/LayoutDB.lyt
ProjectFiles/Project/PCB design/Coils_bottom_RevB/PCB/Work/Layout_Temp/LayoutDB.lyt
ProjectFiles/Project/PCB design/CoilsTop/PCB/CoilsTop.pcb
ProjectFiles/Project/PCB design/CoilsTop/PCB/Layout/LayoutDB.lyt
ProjectFiles/Project/PCB design/CoilsTop/PCB/Output/Gerber/CoilsTop.dsn
ProjectFiles/Project/PCB design/CoilsTop/PCB/Output/Gerber/Single_7seg.dsn
ProjectFiles/Project/PCB design/CoilsTop/PCB/Work/BackupDatabase/LayoutDB.lyt
ProjectFiles/Project/PCB design/CoilsTop/PCB/Work/Layout_Temp/LayoutDB.lyt
ProjectFiles/Project/PCB design/CoilsTopRevB/PCB/CoilsTopRevB.pcb
ProjectFiles/Project/PCB design/CoilsTopRevB/PCB/Layout/LayoutDB.lyt
ProjectFiles/Project/PCB design/CoilsTopRevB/PCB/Output/Gerber/CoilsTopRevB.dsn
ProjectFiles/Project/PCB design/CoilsTopRevB/PCB/Output/Gerber/Single_7seg.dsn
ProjectFiles/Project/PCB design/CoilsTopRevB/PCB/Work/BackupDatabase/LayoutDB.lyt
ProjectFiles/Project/PCB design/CoilsTopRevB/PCB/Work/Layout_Temp/LayoutDB.lyt
ProjectFiles/Project/PCB design/CommandModule/PCB/CommandModule.pcb
ProjectFiles/Project/PCB design/CommandModule/PCB/Layout/LayoutDB.lyt
ProjectFiles/Project/PCB design/CommandModule/PCB/Output/Gerber/CommandModule.dsn
ProjectFiles/Project/PCB design/CommandModule/PCB/Output/Gerber/Single_7seg.dsn
ProjectFiles/Project/PCB design/CommandModule/PCB/Work/BackupDatabase/LayoutDB.lyt
ProjectFiles/Project/PCB design/CommandModule/PCB/Work/Layout_Temp/LayoutDB.lyt
ProjectFiles/Project/PCB design/GT_PowerBoard/PCB/GT_PowerBoard.pcb
ProjectFiles/Project/PCB design/GT_PowerBoard/PCB/Layout/LayoutDB.lyt
ProjectFiles/Project/PCB design/GT_PowerBoard/PCB/Output/Gerber/GT_PowerBoard.dsn
ProjectFiles/Project/PCB design/GT_PowerBoard/PCB/Output/Gerber/Single_7seg.dsn
ProjectFiles/Project/PCB design/GT_PowerBoard/PCB/Work/BackupDatabase/LayoutDB.lyt
ProjectFiles/Project/PCB design/GT_PowerBoard/PCB/Work/Layout_Temp/LayoutDB.lyt
ProjectFiles/Project/PCB design/GTLibrary/LayoutTemplates/2 Layer Template/PCB/Layout/LayoutDB.lyt
ProjectFiles/Project/PCB design/GTLibrary/LayoutTemplates/2 Layer Template/PCB/template.pcb
ProjectFiles/Project/PCB design/GTLibrary/LayoutTemplates/2 Layer Template/PCB/Work/BackupDatabase/LayoutDB.lyt
ProjectFiles/Project/PCB design/GTLibrary/LayoutTemplates/2 Layer Template/PCB/Work/Layout_Temp/LayoutDB.lyt
ProjectFiles/Project/PCB design/GTLibrary/LayoutTemplates/4 Layer Template/Layout/LayoutDB.lyt
ProjectFiles/Project/PCB design/GTLibrary/LayoutTemplates/4 Layer Template/template.pcb
ProjectFiles/Project/PCB design/GTLibrary/LayoutTemplates/8 Layer Template/Layout/LayoutDB.lyt
ProjectFiles/Project/PCB design/GTLibrary/LayoutTemplates/8 Layer Template/template.pcb
ProjectFiles/Project/PCB design/GTLibrary/LayoutTemplates/Micro_mouse/PCB/Layout/LayoutDB.lyt
ProjectFiles/Project/PCB design/GTLibrary/LayoutTemplates/Micro_mouse/PCB/template.pcb
ProjectFiles/Project/PCB design/GTLibrary/LayoutTemplates/Micro_mouse/PCB/Work/BackupDatabase/LayoutDB.lyt
ProjectFiles/Project/PCB design/GTLibrary/Seed_Projects/Santa_Cruz/Santa_Cruz_Level_1/PCB/Layout/LayoutDB.lyt
ProjectFiles/Project/PCB design/GTLibrary/Seed_Projects/Santa_Cruz/Santa_Cruz_Level_1/PCB/Santa_Cruz_Level1.pcb
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
