AndresMtzP/Globetrotters/ProjectFiles/Project/Code/p24EP64GP202.h

/*-------------------------------------------------------------------------
 * MPLAB-Cxx  PIC24EP64GP202 processor header
 *
 * (c) Copyright 1999-2011 Microchip Technology, All rights reserved
 *-------------------------------------------------------------------------*/

#ifndef __PIC24EP64GP202__
#error "Include file does not match processor setting"
#endif

#ifndef __24EP64GP202_H
#define __24EP64GP202_H

extern volatile unsigned int  WREG0 __attribute__((__sfr__,__deprecated__,__unsafe__));
extern volatile unsigned int  WREG1 __attribute__((__sfr__,__deprecated__,__unsafe__));
extern volatile unsigned int  WREG2 __attribute__((__sfr__,__deprecated__,__unsafe__));
extern volatile unsigned int  WREG3 __attribute__((__sfr__,__deprecated__,__unsafe__));
extern volatile unsigned int  WREG4 __attribute__((__sfr__,__deprecated__,__unsafe__));
extern volatile unsigned int  WREG5 __attribute__((__sfr__,__deprecated__,__unsafe__));
extern volatile unsigned int  WREG6 __attribute__((__sfr__,__deprecated__,__unsafe__));
extern volatile unsigned int  WREG7 __attribute__((__sfr__,__deprecated__,__unsafe__));
extern volatile unsigned int  WREG8 __attribute__((__sfr__,__deprecated__,__unsafe__));
extern volatile unsigned int  WREG9 __attribute__((__sfr__,__deprecated__,__unsafe__));
extern volatile unsigned int  WREG10 __attribute__((__sfr__,__deprecated__,__unsafe__));
extern volatile unsigned int  WREG11 __attribute__((__sfr__,__deprecated__,__unsafe__));
extern volatile unsigned int  WREG12 __attribute__((__sfr__,__deprecated__,__unsafe__));
extern volatile unsigned int  WREG13 __attribute__((__sfr__,__deprecated__,__unsafe__));
extern volatile unsigned int  WREG14 __attribute__((__sfr__,__deprecated__,__unsafe__));
extern volatile unsigned int  WREG15 __attribute__((__sfr__,__deprecated__,__unsafe__));
extern volatile unsigned int  SPLIM __attribute__((__sfr__));
extern volatile unsigned int  PCL __attribute__((__sfr__));
extern volatile unsigned char PCH __attribute__((__sfr__));
extern volatile unsigned int  DSRPAG __attribute__((__sfr__));
typedef struct tagDSRPAGBITS {
  unsigned DSRPAG:10;
} DSRPAGBITS;
extern volatile DSRPAGBITS DSRPAGbits __attribute__((__sfr__));

extern volatile unsigned int  DSWPAG __attribute__((__sfr__));
typedef struct tagDSWPAGBITS {
  unsigned DSWPAG:9;
} DSWPAGBITS;
extern volatile DSWPAGBITS DSWPAGbits __attribute__((__sfr__));

extern volatile unsigned int  RCOUNT __attribute__((__sfr__));
extern volatile unsigned int  SR __attribute__((__sfr__));
__extension__ typedef struct tagSRBITS {
  union {
    struct {
      unsigned C:1;
      unsigned Z:1;
      unsigned OV:1;
      unsigned N:1;
      unsigned RA:1;
      unsigned IPL:3;
      unsigned DC:1;
      unsigned DA:1;
      unsigned SAB:1;
      unsigned OAB:1;
      unsigned SB:1;
      unsigned SA:1;
      unsigned OB:1;
      unsigned OA:1;
    };
    struct {
      unsigned :5;
      unsigned IPL0:1;
      unsigned IPL1:1;
      unsigned IPL2:1;
    };
  };
} SRBITS;
extern volatile SRBITS SRbits __attribute__((__sfr__));

extern volatile unsigned int  CORCON __attribute__((__sfr__));
__extension__ typedef struct tagCORCONBITS {
  union {
    struct {
      unsigned IF:1;
      unsigned RND:1;
      unsigned SFA:1;
      unsigned IPL3:1;
      unsigned ACCSAT:1;
      unsigned SATDW:1;
      unsigned SATB:1;
      unsigned SATA:1;
      unsigned DL:3;
      unsigned EDT:1;
      unsigned US:2;
      unsigned :1;
      unsigned VAR:1;
    };
    struct {
      unsigned :8;
      unsigned DL0:1;
      unsigned DL1:1;
      unsigned DL2:1;
      unsigned :1;
      unsigned US0:1;
      unsigned US1:1;
    };
  };
} CORCONBITS;
extern volatile CORCONBITS CORCONbits __attribute__((__sfr__));

extern volatile unsigned int  DISICNT __attribute__((__sfr__));
extern volatile unsigned int  TBLPAG __attribute__((__sfr__));
typedef struct tagTBLPAGBITS {
  unsigned TBLPAG:8;
} TBLPAGBITS;
extern volatile TBLPAGBITS TBLPAGbits __attribute__((__sfr__));

extern volatile unsigned int  MSTRPR __attribute__((__sfr__));
extern volatile unsigned int  TMR1 __attribute__((__sfr__));
extern volatile unsigned int  PR1 __attribute__((__sfr__));
extern volatile unsigned int  T1CON __attribute__((__sfr__));
__extension__ typedef struct tagT1CONBITS {
  union {
    struct {
      unsigned :1;
      unsigned TCS:1;
      unsigned TSYNC:1;
      unsigned :1;
      unsigned TCKPS:2;
      unsigned TGATE:1;
      unsigned :6;
      unsigned TSIDL:1;
      unsigned :1;
      unsigned TON:1;
    };
    struct {
      unsigned :4;
      unsigned TCKPS0:1;
      unsigned TCKPS1:1;
    };
  };
} T1CONBITS;
extern volatile T1CONBITS T1CONbits __attribute__((__sfr__));

extern volatile unsigned int  TMR2 __attribute__((__sfr__));
extern volatile unsigned int  TMR3HLD __attribute__((__sfr__));
extern volatile unsigned int  TMR3 __attribute__((__sfr__));
extern volatile unsigned int  PR2 __attribute__((__sfr__));
extern volatile unsigned int  PR3 __attribute__((__sfr__));
extern volatile unsigned int  T2CON __attribute__((__sfr__));
__extension__ typedef struct tagT2CONBITS {
  union {
    struct {
      unsigned :1;
      unsigned TCS:1;
      unsigned :1;
      unsigned T32:1;
      unsigned TCKPS:2;
      unsigned TGATE:1;
      unsigned :6;
      unsigned TSIDL:1;
      unsigned :1;
      unsigned TON:1;
    };
    struct {
      unsigned :4;
      unsigned TCKPS0:1;
      unsigned TCKPS1:1;
    };
  };
} T2CONBITS;
extern volatile T2CONBITS T2CONbits __attribute__((__sfr__));

extern volatile unsigned int  T3CON __attribute__((__sfr__));
__extension__ typedef struct tagT3CONBITS {
  union {
    struct {
      unsigned :1;
      unsigned TCS:1;
      unsigned :2;
      unsigned TCKPS:2;
      unsigned TGATE:1;
      unsigned :6;
      unsigned TSIDL:1;
      unsigned :1;
      unsigned TON:1;
    };
    struct {
      unsigned :4;
      unsigned TCKPS0:1;
      unsigned TCKPS1:1;
    };
  };
} T3CONBITS;
extern volatile T3CONBITS T3CONbits __attribute__((__sfr__));

extern volatile unsigned int  TMR4 __attribute__((__sfr__));
extern volatile unsigned int  TMR5HLD __attribute__((__sfr__));
extern volatile unsigned int  TMR5 __attribute__((__sfr__));
extern volatile unsigned int  PR4 __attribute__((__sfr__));
extern volatile unsigned int  PR5 __attribute__((__sfr__));
extern volatile unsigned int  T4CON __attribute__((__sfr__));
__extension__ typedef struct tagT4CONBITS {
  union {
    struct {
      unsigned :1;
      unsigned TCS:1;
      unsigned :1;
      unsigned T32:1;
      unsigned TCKPS:2;
      unsigned TGATE:1;
      unsigned :6;
      unsigned TSIDL:1;
      unsigned :1;
      unsigned TON:1;
    };
    struct {
      unsigned :4;
      unsigned TCKPS0:1;
      unsigned TCKPS1:1;
    };
  };
} T4CONBITS;
extern volatile T4CONBITS T4CONbits __attribute__((__sfr__));

extern volatile unsigned int  T5CON __attribute__((__sfr__));
__extension__ typedef struct tagT5CONBITS {
  union {
    struct {
      unsigned :1;
      unsigned TCS:1;
      unsigned :2;
      unsigned TCKPS:2;
      unsigned TGATE:1;
      unsigned :6;
      unsigned TSIDL:1;
      unsigned :1;
      unsigned TON:1;
    };
    struct {
      unsigned :4;
      unsigned TCKPS0:1;
      unsigned TCKPS1:1;
    };
  };
} T5CONBITS;
extern volatile T5CONBITS T5CONbits __attribute__((__sfr__));

extern volatile unsigned int  IC1CON1 __attribute__((__sfr__));
__extension__ typedef struct tagIC1CON1BITS {
  union {
    struct {
      unsigned ICM:3;
      unsigned ICBNE:1;
      unsigned ICOV:1;
      unsigned ICI:2;
      unsigned :3;
      unsigned ICTSEL:3;
      unsigned ICSIDL:1;
    };
    struct {
      unsigned ICM0:1;
      unsigned ICM1:1;
      unsigned ICM2:1;
      unsigned :2;
      unsigned ICI0:1;
      unsigned ICI1:1;
      unsigned :3;
      unsigned ICTSEL0:1;
      unsigned ICTSEL1:1;
      unsigned ICTSEL2:1;
    };
  };
} IC1CON1BITS;
extern volatile IC1CON1BITS IC1CON1bits __attribute__((__sfr__));

extern volatile unsigned int  IC1CON2 __attribute__((__sfr__));
__extension__ typedef struct tagIC1CON2BITS {
  union {
    struct {
      unsigned SYNCSEL:5;
      unsigned :1;
      unsigned TRIGSTAT:1;
      unsigned ICTRIG:1;
      unsigned IC32:1;
    };
    struct {
      unsigned SYNCSEL0:1;
      unsigned SYNCSEL1:1;
      unsigned SYNCSEL2:1;
      unsigned SYNCSEL3:1;
      unsigned SYNCSEL4:1;
    };
  };
} IC1CON2BITS;
extern volatile IC1CON2BITS IC1CON2bits __attribute__((__sfr__));


/* Generic structure of entire SFR area for Input Capture modules */
typedef struct tagIC {
        unsigned int icxbuf;
        unsigned int icxcon;
} IC, *PIC;

/* SFR blocks for Input Capture modules */
extern volatile IC IC1 __attribute__((__sfr__));
extern volatile IC IC2 __attribute__((__sfr__));
extern volatile IC IC3 __attribute__((__sfr__));
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
      unsigned ICTRIG:1;
      unsigned IC32:1;
    };
    struct {
      unsigned SYNCSEL0:1;
      unsigned SYNCSEL1:1;
      unsigned SYNCSEL2:1;
      unsigned SYNCSEL3:1;
      unsigned SYNCSEL4:1;
    };
  };
} IC4CON2BITS;
extern volatile IC4CON2BITS IC4CON2bits __attribute__((__sfr__));

extern volatile unsigned int  IC4BUF __attribute__((__sfr__));
extern volatile unsigned int  IC4TMR __attribute__((__sfr__));
extern volatile unsigned int  I2C1RCV __attribute__((__sfr__));
extern volatile unsigned int  I2C1TRN __attribute__((__sfr__));
extern volatile unsigned int  I2C1BRG __attribute__((__sfr__));
extern volatile unsigned int  I2C1CON __attribute__((__sfr__));
typedef struct tagI2C1CONBITS {
  unsigned SEN:1;
  unsigned RSEN:1;
  unsigned PEN:1;
  unsigned RCEN:1;
  unsigned ACKEN:1;
  unsigned ACKDT:1;
  unsigned STREN:1;
  unsigned GCEN:1;
  unsigned SMEN:1;
  unsigned DISSLW:1;
  unsigned A10M:1;
  unsigned IPMIEN:1;
  unsigned SCLREL:1;
  unsigned I2CSIDL:1;
  unsigned :1;
  unsigned I2CEN:1;
} I2C1CONBITS;
extern volatile I2C1CONBITS I2C1CONbits __attribute__((__sfr__));

extern volatile unsigned int  I2C1STAT __attribute__((__sfr__));
typedef struct tagI2C1STATBITS {
  unsigned TBF:1;
  unsigned RBF:1;
  unsigned R_W:1;
  unsigned S:1;
  unsigned P:1;
  unsigned D_A:1;
  unsigned I2COV:1;
  unsigned IWCOL:1;
  unsigned ADD10:1;
  unsigned GCSTAT:1;
  unsigned BCL:1;
  unsigned :3;
  unsigned TRSTAT:1;
  unsigned ACKSTAT:1;
} I2C1STATBITS;
extern volatile I2C1STATBITS I2C1STATbits __attribute__((__sfr__));

extern volatile unsigned int  I2C1ADD __attribute__((__sfr__));
extern volatile unsigned int  I2C1MSK __attribute__((__sfr__));
extern volatile unsigned int  I2C2RCV __attribute__((__sfr__));
extern volatile unsigned int  I2C2TRN __attribute__((__sfr__));
extern volatile unsigned int  I2C2BRG __attribute__((__sfr__));
extern volatile unsigned int  I2C2CON __attribute__((__sfr__));
typedef struct tagI2C2CONBITS {
  unsigned SEN:1;
  unsigned RSEN:1;
  unsigned PEN:1;
  unsigned RCEN:1;
  unsigned ACKEN:1;
  unsigned ACKDT:1;
  unsigned STREN:1;
  unsigned GCEN:1;
  unsigned SMEN:1;
  unsigned DISSLW:1;
  unsigned A10M:1;
  unsigned IPMIEN:1;
  unsigned SCLREL:1;
  unsigned I2CSIDL:1;
  unsigned :1;
  unsigned I2CEN:1;
} I2C2CONBITS;
extern volatile I2C2CONBITS I2C2CONbits __attribute__((__sfr__));

extern volatile unsigned int  I2C2STAT __attribute__((__sfr__));
typedef struct tagI2C2STATBITS {
  unsigned TBF:1;
  unsigned RBF:1;
  unsigned R_W:1;
  unsigned S:1;
  unsigned P:1;
  unsigned D_A:1;
  unsigned I2COV:1;
  unsigned IWCOL:1;
  unsigned ADD10:1;
  unsigned GCSTAT:1;
  unsigned BCL:1;
  unsigned :3;
  unsigned TRSTAT:1;
  unsigned ACKSTAT:1;
} I2C2STATBITS;
extern volatile I2C2STATBITS I2C2STATbits __attribute__((__sfr__));

extern volatile unsigned int  I2C2ADD __attribute__((__sfr__));
extern volatile unsigned int  I2C2MSK __attribute__((__sfr__));

/* Generic structure of entire SFR area for each UART module */
typedef struct tagUART {
        unsigned int uxmode;
        unsigned int uxsta;
        unsigned int uxtxreg;
        unsigned int uxrxreg;
        unsigned int uxbrg;
} UART, *PUART;

#define UxMODEBITS U1MODEBITS
#define UxSTABITS U1STABITS
#define UxTXREGBITS U1TXREGBITS
#define UxRXREGBITS U1RXREGBITS
#define UxBRGBITS U1BRGBITS

/* SFR blocks for each UART module */
extern volatile UART UART1 __attribute__((__sfr__));
extern volatile UART UART2 __attribute__((__sfr__));

extern volatile unsigned int  U1MODE __attribute__((__sfr__));
__extension__ typedef struct tagU1MODEBITS {
  union {
    struct {
      unsigned STSEL:1;
      unsigned PDSEL:2;
      unsigned BRGH:1;
      unsigned URXINV:1;
      unsigned ABAUD:1;
      unsigned LPBACK:1;
      unsigned WAKE:1;
      unsigned UEN:2;
      unsigned :1;
      unsigned RTSMD:1;
      unsigned IREN:1;
      unsigned USIDL:1;
      unsigned :1;
      unsigned UARTEN:1;
    };
    struct {
      unsigned :1;
      unsigned PDSEL0:1;
      unsigned PDSEL1:1;
      unsigned :1;
      unsigned RXINV:1;
      unsigned :3;
      unsigned UEN0:1;
      unsigned UEN1:1;
    };
  };
} U1MODEBITS;
extern volatile U1MODEBITS U1MODEbits __attribute__((__sfr__));

extern volatile unsigned int  U1STA __attribute__((__sfr__));
__extension__ typedef struct tagU1STABITS {
  union {
    struct {
      unsigned URXDA:1;
      unsigned OERR:1;
      unsigned FERR:1;
      unsigned PERR:1;
      unsigned RIDLE:1;
      unsigned ADDEN:1;
      unsigned URXISEL:2;
      unsigned TRMT:1;
      unsigned UTXBF:1;
      unsigned UTXEN:1;
      unsigned UTXBRK:1;
      unsigned :1;
      unsigned UTXISEL0:1;
      unsigned UTXINV:1;
      unsigned UTXISEL1:1;
    };
    struct {
      unsigned :6;
      unsigned URXISEL0:1;
      unsigned URXISEL1:1;
    };
  };
} U1STABITS;
extern volatile U1STABITS U1STAbits __attribute__((__sfr__));

extern volatile unsigned int  U1TXREG __attribute__((__sfr__));
extern volatile unsigned int  U1RXREG __attribute__((__sfr__));
extern volatile unsigned int  U1BRG __attribute__((__sfr__));
extern volatile unsigned int  U2MODE __attribute__((__sfr__));
__extension__ typedef struct tagU2MODEBITS {
  union {
    struct {
      unsigned STSEL:1;
      unsigned PDSEL:2;
      unsigned BRGH:1;
      unsigned URXINV:1;
      unsigned ABAUD:1;
      unsigned LPBACK:1;
      unsigned WAKE:1;
      unsigned UEN:2;
      unsigned :1;
      unsigned RTSMD:1;
      unsigned IREN:1;
      unsigned USIDL:1;
      unsigned :1;
      unsigned UARTEN:1;
    };
    struct {
      unsigned :1;
      unsigned PDSEL0:1;
      unsigned PDSEL1:1;
      unsigned :1;
      unsigned RXINV:1;
      unsigned :3;
      unsigned UEN0:1;
      unsigned UEN1:1;
    };
  };
} U2MODEBITS;
extern volatile U2MODEBITS U2MODEbits __attribute__((__sfr__));

extern volatile unsigned int  U2STA __attribute__((__sfr__));
__extension__ typedef struct tagU2STABITS {
  union {
    struct {
      unsigned URXDA:1;
      unsigned OERR:1;
      unsigned FERR:1;
      unsigned PERR:1;
      unsigned RIDLE:1;
      unsigned ADDEN:1;
      unsigned URXISEL:2;
      unsigned TRMT:1;
      unsigned UTXBF:1;
      unsigned UTXEN:1;
      unsigned UTXBRK:1;
      unsigned :1;
      unsigned UTXISEL0:1;
      unsigned UTXINV:1;
      unsigned UTXISEL1:1;
    };
    struct {
      unsigned :6;
      unsigned URXISEL0:1;
      unsigned URXISEL1:1;
    };
  };
} U2STABITS;
extern volatile U2STABITS U2STAbits __attribute__((__sfr__));

extern volatile unsigned int  U2TXREG __attribute__((__sfr__));
extern volatile unsigned int  U2RXREG __attribute__((__sfr__));
extern volatile unsigned int  U2BRG __attribute__((__sfr__));

/* Generic structure of entire SFR area for each SPI module */
typedef struct tagSPI {
        unsigned int spixstat;
        unsigned int spixcon1;
        unsigned int spixcon2;
        unsigned int unused;
        unsigned int spixbuf;
} SPI, *PSPI;

#define SPIxSTATBITS SPI1STATBITS
#define SPIxCONBITS SPI1CONBITS

/* SFR blocks for each SPI module */
extern volatile SPI SPI1 __attribute__((__sfr__));
extern volatile SPI SPI2 __attribute__((__sfr__));

extern volatile unsigned int  SPI1STAT __attribute__((__sfr__));
__extension__ typedef struct tagSPI1STATBITS {
  union {
    struct {
      unsigned SPIRBF:1;
      unsigned SPITBF:1;
      unsigned SISEL:3;
      unsigned SRXMPT:1;
      unsigned SPIROV:1;
      unsigned SRMPT:1;
      unsigned SPIBEC:3;
      unsigned :2;
      unsigned SPISIDL:1;
      unsigned :1;
      unsigned SPIEN:1;
    };
    struct {
      unsigned :2;
      unsigned SISEL0:1;
      unsigned SISEL1:1;
      unsigned SISEL2:1;
      unsigned :3;
      unsigned SPIBEC0:1;
      unsigned SPIBEC1:1;
      unsigned SPIBEC2:1;
    };
  };
} SPI1STATBITS;
extern volatile SPI1STATBITS SPI1STATbits __attribute__((__sfr__));

extern volatile unsigned int  SPI1CON1 __attribute__((__sfr__));
__extension__ typedef struct tagSPI1CON1BITS {
  union {
    struct {
      unsigned PPRE:2;
      unsigned SPRE:3;
      unsigned MSTEN:1;
      unsigned CKP:1;
      unsigned SSEN:1;
      unsigned CKE:1;
      unsigned SMP:1;
      unsigned MODE16:1;
      unsigned DISSDO:1;
      unsigned DISSCK:1;
    };
    struct {
      unsigned PPRE0:1;
      unsigned PPRE1:1;
      unsigned SPRE0:1;
      unsigned SPRE1:1;
      unsigned SPRE2:1;
    };
  };
} SPI1CON1BITS;
extern volatile SPI1CON1BITS SPI1CON1bits __attribute__((__sfr__));

extern volatile unsigned int  SPI1CON2 __attribute__((__sfr__));
typedef struct tagSPI1CON2BITS {
  unsigned SPIBEN:1;
  unsigned FRMDLY:1;
  unsigned :11;
  unsigned FRMPOL:1;
  unsigned SPIFSD:1;
  unsigned FRMEN:1;
} SPI1CON2BITS;
extern volatile SPI1CON2BITS SPI1CON2bits __attribute__((__sfr__));

extern volatile unsigned int  SPI1BUF __attribute__((__sfr__));
extern volatile unsigned int  SPI2STAT __attribute__((__sfr__));
__extension__ typedef struct tagSPI2STATBITS {
  union {
    struct {
      unsigned SPIRBF:1;
      unsigned SPITBF:1;
      unsigned SISEL:3;
      unsigned SRXMPT:1;
      unsigned SPIROV:1;
      unsigned SRMPT:1;
      unsigned SPIBEC:3;
      unsigned :2;
      unsigned SPISIDL:1;
      unsigned :1;
      unsigned SPIEN:1;
    };
    struct {
      unsigned :2;
      unsigned SISEL0:1;
      unsigned SISEL1:1;
      unsigned SISEL2:1;
      unsigned :3;
      unsigned SPIBEC0:1;
      unsigned SPIBEC1:1;
      unsigned SPIBEC2:1;
    };
  };
} SPI2STATBITS;
extern volatile SPI2STATBITS SPI2STATbits __attribute__((__sfr__));

extern volatile unsigned int  SPI2CON1 __attribute__((__sfr__));
__extension__ typedef struct tagSPI2CON1BITS {
  union {
    struct {
      unsigned PPRE:2;
      unsigned SPRE:3;
      unsigned MSTEN:1;
      unsigned CKP:1;
      unsigned SSEN:1;
      unsigned CKE:1;
      unsigned SMP:1;
      unsigned MODE16:1;
      unsigned DISSDO:1;
      unsigned DISSCK:1;
    };
    struct {
      unsigned PPRE0:1;
      unsigned PPRE1:1;
      unsigned SPRE0:1;
      unsigned SPRE1:1;
      unsigned SPRE2:1;
    };
  };
} SPI2CON1BITS;
extern volatile SPI2CON1BITS SPI2CON1bits __attribute__((__sfr__));

extern volatile unsigned int  SPI2CON2 __attribute__((__sfr__));
typedef struct tagSPI2CON2BITS {
  unsigned SPIBEN:1;
  unsigned FRMDLY:1;
  unsigned :11;
  unsigned FRMPOL:1;
  unsigned SPIFSD:1;
  unsigned FRMEN:1;
} SPI2CON2BITS;
extern volatile SPI2CON2BITS SPI2CON2bits __attribute__((__sfr__));

extern volatile unsigned int  SPI2BUF __attribute__((__sfr__));
extern volatile unsigned int  ADC1BUF0 __attribute__((__sfr__));
extern volatile unsigned int  ADC1BUF1 __attribute__((__sfr__));
extern volatile unsigned int  ADC1BUF2 __attribute__((__sfr__));
extern volatile unsigned int  ADC1BUF3 __attribute__((__sfr__));
extern volatile unsigned int  ADC1BUF4 __attribute__((__sfr__));
extern volatile unsigned int  ADC1BUF5 __attribute__((__sfr__));
extern volatile unsigned int  ADC1BUF6 __attribute__((__sfr__));
extern volatile unsigned int  ADC1BUF7 __attribute__((__sfr__));
extern volatile unsigned int  ADC1BUF8 __attribute__((__sfr__));
extern volatile unsigned int  ADC1BUF9 __attribute__((__sfr__));
extern volatile unsigned int  ADC1BUFA __attribute__((__sfr__));
extern volatile unsigned int  ADC1BUFB __attribute__((__sfr__));
extern volatile unsigned int  ADC1BUFC __attribute__((__sfr__));
extern volatile unsigned int  ADC1BUFD __attribute__((__sfr__));
extern volatile unsigned int  ADC1BUFE __attribute__((__sfr__));
extern volatile unsigned int  ADC1BUFF __attribute__((__sfr__));
extern volatile unsigned int  AD1CON1 __attribute__((__sfr__));
__extension__ typedef struct tagAD1CON1BITS {
  union {
    struct {
      unsigned DONE:1;
      unsigned SAMP:1;
      unsigned ASAM:1;
      unsigned SIMSAM:1;
      unsigned SSRCG:1;
      unsigned SSRC:3;
      unsigned FORM:2;
      unsigned AD12B:1;
      unsigned :1;
      unsigned ADDMABM:1;
      unsigned ADSIDL:1;
      unsigned :1;
      unsigned ADON:1;
    };
    struct {
      unsigned :5;
      unsigned SSRC0:1;
      unsigned SSRC1:1;
      unsigned SSRC2:1;
      unsigned FORM0:1;
      unsigned FORM1:1;
    };
  };
} AD1CON1BITS;
extern volatile AD1CON1BITS AD1CON1bits __attribute__((__sfr__));

extern volatile unsigned int  AD1CON2 __attribute__((__sfr__));
__extension__ typedef struct tagAD1CON2BITS {
  union {
    struct {
      unsigned ALTS:1;
      unsigned BUFM:1;
      unsigned SMPI:5;
      unsigned BUFS:1;
      unsigned CHPS:2;
      unsigned CSCNA:1;
      unsigned :2;
      unsigned VCFG:3;
    };
    struct {
      unsigned :2;
      unsigned SMPI0:1;
      unsigned SMPI1:1;
      unsigned SMPI2:1;
      unsigned SMPI3:1;
      unsigned SMPI4:1;
      unsigned :1;
      unsigned CHPS0:1;
      unsigned CHPS1:1;
      unsigned :3;
      unsigned VCFG0:1;
      unsigned VCFG1:1;
      unsigned VCFG2:1;
    };
  };
} AD1CON2BITS;
extern volatile AD1CON2BITS AD1CON2bits __attribute__((__sfr__));

extern volatile unsigned int  AD1CON3 __attribute__((__sfr__));
__extension__ typedef struct tagAD1CON3BITS {
  union {
    struct {
      unsigned ADCS:8;
      unsigned SAMC:5;
      unsigned :2;
      unsigned ADRC:1;
    };
    struct {
      unsigned ADCS0:1;
      unsigned ADCS1:1;
      unsigned ADCS2:1;
      unsigned ADCS3:1;
      unsigned ADCS4:1;
      unsigned ADCS5:1;
      unsigned ADCS6:1;
      unsigned ADCS7:1;
      unsigned SAMC0:1;
      unsigned SAMC1:1;
      unsigned SAMC2:1;
      unsigned SAMC3:1;
      unsigned SAMC4:1;
    };
  };
} AD1CON3BITS;
extern volatile AD1CON3BITS AD1CON3bits __attribute__((__sfr__));

extern volatile unsigned int  AD1CHS123 __attribute__((__sfr__));
__extension__ typedef struct tagAD1CHS123BITS {
  union {
    struct {
      unsigned CH123SA:1;
      unsigned CH123NA:2;
      unsigned :5;
      unsigned CH123SB:1;
      unsigned CH123NB:2;
    };
    struct {
      unsigned :1;
      unsigned CH123NA0:1;
      unsigned CH123NA1:1;
      unsigned :6;
      unsigned CH123NB0:1;
      unsigned CH123NB1:1;
    };
  };
} AD1CHS123BITS;
extern volatile AD1CHS123BITS AD1CHS123bits __attribute__((__sfr__));

extern volatile unsigned int  AD1CHS0 __attribute__((__sfr__));
__extension__ typedef struct tagAD1CHS0BITS {
  union {
    struct {
      unsigned CH0SA:5;
      unsigned :2;
      unsigned CH0NA:1;
      unsigned CH0SB:5;
      unsigned :2;
      unsigned CH0NB:1;
    };
    struct {
      unsigned CH0SA0:1;
      unsigned CH0SA1:1;
      unsigned CH0SA2:1;
      unsigned CH0SA3:1;
      unsigned CH0SA4:1;
      unsigned :3;
      unsigned CH0SB0:1;
      unsigned CH0SB1:1;
      unsigned CH0SB2:1;
      unsigned CH0SB3:1;
      unsigned CH0SB4:1;
    };
  };
} AD1CHS0BITS;
extern volatile AD1CHS0BITS AD1CHS0bits __attribute__((__sfr__));

extern volatile unsigned int  AD1CSSH __attribute__((__sfr__));
typedef struct tagAD1CSSHBITS {
  unsigned :8;
  unsigned CSS24:1;
  unsigned CSS25:1;
  unsigned CSS26:1;
  unsigned :3;
  unsigned CSS30:1;
  unsigned CSS31:1;
} AD1CSSHBITS;
extern volatile AD1CSSHBITS AD1CSSHbits __attribute__((__sfr__));

extern volatile unsigned int  AD1CSSL __attribute__((__sfr__));
typedef struct tagAD1CSSLBITS {
  unsigned CSS0:1;
  unsigned CSS1:1;
  unsigned CSS2:1;
  unsigned CSS3:1;
  unsigned CSS4:1;
  unsigned CSS5:1;
  unsigned CSS6:1;
  unsigned CSS7:1;
  unsigned CSS8:1;
  unsigned CSS9:1;
  unsigned CSS10:1;
  unsigned CSS11:1;
  unsigned CSS12:1;
  unsigned CSS13:1;
  unsigned CSS14:1;
  unsigned CSS15:1;
} AD1CSSLBITS;
extern volatile AD1CSSLBITS AD1CSSLbits __attribute__((__sfr__));

extern volatile unsigned int  AD1CON4 __attribute__((__sfr__));
__extension__ typedef struct tagAD1CON4BITS {
  union {
    struct {
      unsigned DMABL:3;
      unsigned :5;
      unsigned ADDMAEN:1;
    };
    struct {
      unsigned DMABL0:1;
      unsigned DMABL1:1;
      unsigned DMABL2:1;
    };
  };
} AD1CON4BITS;
extern volatile AD1CON4BITS AD1CON4bits __attribute__((__sfr__));

extern volatile unsigned int  CTMUCON1 __attribute__((__sfr__));
typedef struct tagCTMUCON1BITS {
  unsigned :8;
  unsigned CTTRIG:1;
  unsigned IDISSEN:1;
  unsigned EDGSEQEN:1;
  unsigned EDGEN:1;
  unsigned TGEN:1;
  unsigned CTMUSIDL:1;
  unsigned :1;
  unsigned CTMUEN:1;
} CTMUCON1BITS;
extern volatile CTMUCON1BITS CTMUCON1bits __attribute__((__sfr__));

extern volatile unsigned int  CTMUCON2 __attribute__((__sfr__));
__extension__ typedef struct tagCTMUCON2BITS {
  union {
    struct {
      unsigned :2;
      unsigned EDG2SEL:4;
      unsigned EDG2POL:1;
      unsigned EDG2MOD:1;
      unsigned EDG1STAT:1;
      unsigned EDG2STAT:1;
      unsigned EDG1SEL:4;
      unsigned EDG1POL:1;
      unsigned EDG1MOD:1;
    };
    struct {
      unsigned :2;
      unsigned EDG2SEL0:1;
      unsigned EDG2SEL1:1;
      unsigned EDG2SEL2:1;
      unsigned EDG2SEL3:1;
      unsigned :4;
      unsigned EDG1SEL0:1;
      unsigned EDG1SEL1:1;
      unsigned EDG1SEL2:1;
      unsigned EDG1SEL3:1;
    };
  };
} CTMUCON2BITS;
extern volatile CTMUCON2BITS CTMUCON2bits __attribute__((__sfr__));

extern volatile unsigned int  CTMUICON __attribute__((__sfr__));
__extension__ typedef struct tagCTMUICONBITS {
  union {
    struct {
      unsigned :8;
      unsigned IRNG:2;
      unsigned ITRIM:6;
    };
    struct {
      unsigned :8;
      unsigned IRNG0:1;
      unsigned IRNG1:1;
      unsigned ITRIM0:1;
      unsigned ITRIM1:1;
      unsigned ITRIM2:1;
      unsigned ITRIM3:1;
      unsigned ITRIM4:1;
      unsigned ITRIM5:1;
    };
  };
} CTMUICONBITS;
extern volatile CTMUICONBITS CTMUICONbits __attribute__((__sfr__));

extern volatile unsigned int  CRCCON1 __attribute__((__sfr__));
__extension__ typedef struct tagCRCCON1BITS {
  union {
    struct {
      unsigned :3;
      unsigned LENDIAN:1;
      unsigned CRCGO:1;
      unsigned CRCISEL:1;
      unsigned CRCMPT:1;
      unsigned CRCFUL:1;
      unsigned VWORD:5;
      unsigned CSIDL:1;
      unsigned :1;
      unsigned CRCEN:1;
    };
    struct {
      unsigned :8;
      unsigned VWORD0:1;
      unsigned VWORD1:1;
      unsigned VWORD2:1;
      unsigned VWORD3:1;
      unsigned VWORD4:1;
    };
  };
} CRCCON1BITS;
extern volatile CRCCON1BITS CRCCON1bits __attribute__((__sfr__));

extern volatile unsigned int  CRCCON2 __attribute__((__sfr__));
__extension__ typedef struct tagCRCCON2BITS {
  union {
    struct {
      unsigned PLEN:5;
      unsigned :3;
      unsigned DWIDTH:5;
    };
    struct {
      unsigned PLEN0:1;
      unsigned PLEN1:1;
      unsigned PLEN2:1;
      unsigned PLEN3:1;
      unsigned PLEN4:1;
      unsigned :3;
      unsigned DWIDTH0:1;
      unsigned DWIDTH1:1;
      unsigned DWIDTH2:1;
      unsigned DWIDTH3:1;
      unsigned DWIDTH4:1;
    };
  };
} CRCCON2BITS;
extern volatile CRCCON2BITS CRCCON2bits __attribute__((__sfr__));

extern volatile unsigned int  CRCXORL __attribute__((__sfr__));
typedef struct tagCRCXORLBITS {
  unsigned :1;
  unsigned X1:1;
  unsigned X2:1;
  unsigned X3:1;
  unsigned X4:1;
  unsigned X5:1;
  unsigned X6:1;
  unsigned X7:1;
  unsigned X8:1;
  unsigned X9:1;
  unsigned X10:1;
  unsigned X11:1;
  unsigned X12:1;
  unsigned X13:1;
  unsigned X14:1;
  unsigned X15:1;
} CRCXORLBITS;
extern volatile CRCXORLBITS CRCXORLbits __attribute__((__sfr__));

extern volatile unsigned int  CRCXORH __attribute__((__sfr__));
typedef struct tagCRCXORHBITS {
  unsigned X16:1;
  unsigned X17:1;
  unsigned X18:1;
  unsigned X19:1;
  unsigned X20:1;
  unsigned X21:1;
  unsigned X22:1;
  unsigned X23:1;
  unsigned X24:1;
  unsigned X25:1;
  unsigned X26:1;
  unsigned X27:1;
  unsigned X28:1;
  unsigned X29:1;
  unsigned X30:1;
  unsigned X31:1;
} CRCXORHBITS;
extern volatile CRCXORHBITS CRCXORHbits __attribute__((__sfr__));

extern volatile unsigned int  CRCDAT __attribute__((__sfr__));
extern volatile unsigned int  CRCDATL __attribute__((__sfr__));
extern volatile unsigned int  CRCDATH __attribute__((__sfr__));
extern volatile unsigned int  CRCWDAT __attribute__((__sfr__));
extern volatile unsigned int  CRCWDATL __attribute__((__sfr__));
extern volatile unsigned int  CRCWDATH __attribute__((__sfr__));
extern volatile unsigned int  RPOR0 __attribute__((__sfr__));
__extension__ typedef struct tagRPOR0BITS {
  union {
    struct {
      unsigned RP20R:6;
      unsigned :2;
      unsigned RP35R:6;
    };
    struct {
      unsigned RP20R0:1;
      unsigned RP20R1:1;
      unsigned RP20R2:1;
      unsigned RP20R3:1;
      unsigned RP20R4:1;
      unsigned RP20R5:1;
      unsigned :2;
      unsigned RP35R0:1;
      unsigned RP35R1:1;
      unsigned RP35R2:1;
      unsigned RP35R3:1;
      unsigned RP35R4:1;
      unsigned RP35R5:1;
    };
  };
} RPOR0BITS;
extern volatile RPOR0BITS RPOR0bits __attribute__((__sfr__));

extern volatile unsigned int  RPOR1 __attribute__((__sfr__));
__extension__ typedef struct tagRPOR1BITS {
  union {
    struct {
      unsigned RP36R:6;
      unsigned :2;
      unsigned RP37R:6;
    };
    struct {
      unsigned RP36R0:1;
      unsigned RP36R1:1;
      unsigned RP36R2:1;
      unsigned RP36R3:1;
      unsigned RP36R4:1;
      unsigned RP36R5:1;
      unsigned :2;
      unsigned RP37R0:1;
      unsigned RP37R1:1;
      unsigned RP37R2:1;
      unsigned RP37R3:1;
      unsigned RP37R4:1;
      unsigned RP37R5:1;
    };
  };
} RPOR1BITS;
extern volatile RPOR1BITS RPOR1bits __attribute__((__sfr__));

extern volatile unsigned int  RPOR2 __attribute__((__sfr__));
__extension__ typedef struct tagRPOR2BITS {
  union {
    struct {
      unsigned RP38R:6;
      unsigned :2;
      unsigned RP39R:6;
    };
    struct {
      unsigned RP38R0:1;
      unsigned RP38R1:1;
      unsigned RP38R2:1;
      unsigned RP38R3:1;
      unsigned RP38R4:1;
      unsigned RP38R5:1;
      unsigned :2;
      unsigned RP39R0:1;
      unsigned RP39R1:1;
      unsigned RP39R2:1;
      unsigned RP39R3:1;
      unsigned RP39R4:1;
      unsigned RP39R5:1;
    };
  };
} RPOR2BITS;
extern volatile RPOR2BITS RPOR2bits __attribute__((__sfr__));

extern volatile unsigned int  RPOR3 __attribute__((__sfr__));
__extension__ typedef struct tagRPOR3BITS {
  union {
    struct {
      unsigned RP40R:6;
      unsigned :2;
      unsigned RP41R:6;
    };
    struct {
      unsigned RP40R0:1;
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
      unsigned WRERR:1;
      unsigned WREN:1;
      unsigned WR:1;
    };
    struct {
      unsigned NVMOP0:1;
      unsigned NVMOP1:1;
      unsigned NVMOP2:1;
      unsigned NVMOP3:1;
    };
  };
} NVMCONBITS;
extern volatile NVMCONBITS NVMCONbits __attribute__((__sfr__));

extern volatile unsigned int  NVMADR __attribute__((__sfr__));
extern volatile unsigned int  NVMADRU __attribute__((__sfr__));
typedef struct tagNVMADRUBITS {
  unsigned NVMADRU:8;
} NVMADRUBITS;
extern volatile NVMADRUBITS NVMADRUbits __attribute__((__sfr__));

extern volatile unsigned int  NVMKEY __attribute__((__sfr__));
extern volatile unsigned int  RCON __attribute__((__sfr__));
typedef struct tagRCONBITS {
  unsigned POR:1;
  unsigned BOR:1;
  unsigned IDLE:1;
  unsigned SLEEP:1;
  unsigned WDTO:1;
  unsigned SWDTEN:1;
  unsigned SWR:1;
  unsigned EXTR:1;
  unsigned VREGS:1;
  unsigned CM:1;
  unsigned :1;
  unsigned VREGSF:1;
  unsigned :2;
  unsigned IOPUWR:1;
  unsigned TRAPR:1;
} RCONBITS;
extern volatile RCONBITS RCONbits __attribute__((__sfr__));

extern volatile unsigned int  OSCCON __attribute__((__sfr__));
__extension__ typedef struct tagOSCCONBITS {
  union {
    struct {
      unsigned OSWEN:1;
      unsigned :2;
      unsigned CF:1;
      unsigned :1;
      unsigned LOCK:1;
      unsigned IOLOCK:1;
      unsigned CLKLOCK:1;
      unsigned NOSC:3;
      unsigned :1;
      unsigned COSC:3;
    };
    struct {
      unsigned :8;
      unsigned NOSC0:1;
      unsigned NOSC1:1;
      unsigned NOSC2:1;
      unsigned :1;
      unsigned COSC0:1;
      unsigned COSC1:1;
      unsigned COSC2:1;
    };
  };
} OSCCONBITS;
extern volatile OSCCONBITS OSCCONbits __attribute__((__sfr__));

extern volatile unsigned char OSCCONL __attribute__((__sfr__));
extern volatile unsigned char OSCCONH __attribute__((__sfr__));
extern volatile unsigned int  CLKDIV __attribute__((__sfr__));
__extension__ typedef struct tagCLKDIVBITS {
  union {
    struct {
      unsigned PLLPRE:5;
      unsigned :1;
      unsigned PLLPOST:2;
      unsigned FRCDIV:3;
      unsigned DOZEN:1;
      unsigned DOZE:3;
      unsigned ROI:1;
    };
    struct {
      unsigned PLLPRE0:1;
      unsigned PLLPRE1:1;
      unsigned PLLPRE2:1;
      unsigned PLLPRE3:1;
      unsigned PLLPRE4:1;
      unsigned :1;
      unsigned PLLPOST0:1;
      unsigned PLLPOST1:1;
      unsigned FRCDIV0:1;
      unsigned FRCDIV1:1;
      unsigned FRCDIV2:1;
      unsigned :1;
      unsigned DOZE0:1;
      unsigned DOZE1:1;
      unsigned DOZE2:1;
    };
  };
} CLKDIVBITS;
extern volatile CLKDIVBITS CLKDIVbits __attribute__((__sfr__));

extern volatile unsigned int  PLLFBD __attribute__((__sfr__));
__extension__ typedef struct tagPLLFBDBITS {
  union {
    struct {
      unsigned PLLDIV:9;
    };
    struct {
      unsigned PLLDIV0:1;
      unsigned PLLDIV1:1;
      unsigned PLLDIV2:1;
      unsigned PLLDIV3:1;
      unsigned PLLDIV4:1;
      unsigned PLLDIV5:1;
      unsigned PLLDIV6:1;
      unsigned PLLDIV7:1;
      unsigned PLLDIV8:1;
    };
  };
} PLLFBDBITS;
extern volatile PLLFBDBITS PLLFBDbits __attribute__((__sfr__));

extern volatile unsigned int  OSCTUN __attribute__((__sfr__));
__extension__ typedef struct tagOSCTUNBITS {
  union {
    struct {
      unsigned TUN:6;
    };
    struct {
      unsigned TUN0:1;
      unsigned TUN1:1;
      unsigned TUN2:1;
      unsigned TUN3:1;
      unsigned TUN4:1;
      unsigned TUN5:1;
    };
  };
} OSCTUNBITS;
extern volatile OSCTUNBITS OSCTUNbits __attribute__((__sfr__));

extern volatile unsigned int  REFOCON __attribute__((__sfr__));
__extension__ typedef struct tagREFOCONBITS {
  union {
    struct {
      unsigned :8;
      unsigned RODIV:4;
      unsigned ROSEL:1;
      unsigned ROSSLP:1;
      unsigned :1;
      unsigned ROON:1;
    };
    struct {
      unsigned :8;
      unsigned RODIV0:1;
      unsigned RODIV1:1;
      unsigned RODIV2:1;
      unsigned RODIV3:1;
    };
  };
} REFOCONBITS;
extern volatile REFOCONBITS REFOCONbits __attribute__((__sfr__));

extern volatile unsigned int  PMD1 __attribute__((__sfr__));
typedef struct tagPMD1BITS {
  unsigned AD1MD:1;
  unsigned :2;
  unsigned SPI1MD:1;
  unsigned SPI2MD:1;
  unsigned U1MD:1;
  unsigned U2MD:1;
  unsigned I2C1MD:1;
  unsigned :1;
  unsigned PWMMD:1;
  unsigned QEI1MD:1;
  unsigned T1MD:1;
  unsigned T2MD:1;
  unsigned T3MD:1;
  unsigned T4MD:1;
  unsigned T5MD:1;
} PMD1BITS;
extern volatile PMD1BITS PMD1bits __attribute__((__sfr__));

extern volatile unsigned int  PMD2 __attribute__((__sfr__));
typedef struct tagPMD2BITS {
  unsigned OC1MD:1;
  unsigned OC2MD:1;
  unsigned OC3MD:1;
  unsigned OC4MD:1;
  unsigned :4;
  unsigned IC1MD:1;
  unsigned IC2MD:1;
  unsigned IC3MD:1;
  unsigned IC4MD:1;
} PMD2BITS;
extern volatile PMD2BITS PMD2bits __attribute__((__sfr__));

extern volatile unsigned int  PMD3 __attribute__((__sfr__));
typedef struct tagPMD3BITS {
  unsigned :1;
  unsigned I2C2MD:1;
  unsigned :5;
  unsigned CRCMD:1;
  unsigned :2;
  unsigned CMPMD:1;
} PMD3BITS;
extern volatile PMD3BITS PMD3bits __attribute__((__sfr__));

extern volatile unsigned int  PMD4 __attribute__((__sfr__));
typedef struct tagPMD4BITS {
  unsigned :2;
  unsigned CTMUMD:1;
  unsigned REFOMD:1;
} PMD4BITS;
extern volatile PMD4BITS PMD4bits __attribute__((__sfr__));

extern volatile unsigned int  PMD6 __attribute__((__sfr__));
extern volatile unsigned int  PMD7 __attribute__((__sfr__));
__extension__ typedef struct tagPMD7BITS {
  union {
    struct {
      unsigned :3;
      unsigned PTGMD:1;
      unsigned DMA0MD:1;
    };
    struct {
      unsigned :4;
      unsigned DMA1MD:1;
      unsigned DMA5MD:1;
      unsigned DMA9MD:1;
      unsigned DMA13MD:1;
    };
    struct {
      unsigned :4;
      unsigned DMA2MD:1;
      unsigned DMA6MD:1;
      unsigned DMA10MD:1;
      unsigned DMA14MD:1;
    };
    struct {
      unsigned :4;
      unsigned DMA3MD:1;
      unsigned DMA7MD:1;
      unsigned DMA11MD:1;
    };
  };
} PMD7BITS;
extern volatile PMD7BITS PMD7bits __attribute__((__sfr__));

extern volatile unsigned int  IFS0 __attribute__((__sfr__));
typedef struct tagIFS0BITS {
  unsigned INT0IF:1;
  unsigned IC1IF:1;
  unsigned OC1IF:1;
  unsigned T1IF:1;
  unsigned DMA0IF:1;
  unsigned IC2IF:1;
  unsigned OC2IF:1;
  unsigned T2IF:1;
  unsigned T3IF:1;
  unsigned SPI1EIF:1;
  unsigned SPI1IF:1;
  unsigned U1RXIF:1;
  unsigned U1TXIF:1;
  unsigned AD1IF:1;
  unsigned DMA1IF:1;
} IFS0BITS;
extern volatile IFS0BITS IFS0bits __attribute__((__sfr__));

extern volatile unsigned int  IFS1 __attribute__((__sfr__));
typedef struct tagIFS1BITS {
  unsigned SI2C1IF:1;
  unsigned MI2C1IF:1;
  unsigned CMIF:1;
  unsigned CNIF:1;
  unsigned INT1IF:1;
  unsigned :3;
  unsigned DMA2IF:1;
  unsigned OC3IF:1;
  unsigned OC4IF:1;
  unsigned T4IF:1;
  unsigned T5IF:1;
  unsigned INT2IF:1;
  unsigned U2RXIF:1;
  unsigned U2TXIF:1;
} IFS1BITS;
extern volatile IFS1BITS IFS1bits __attribute__((__sfr__));

extern volatile unsigned int  IFS2 __attribute__((__sfr__));
typedef struct tagIFS2BITS {
  unsigned SPI2EIF:1;
  unsigned SPI2IF:1;
  unsigned :2;
  unsigned DMA3IF:1;
  unsigned IC3IF:1;
  unsigned IC4IF:1;
} IFS2BITS;
extern volatile IFS2BITS IFS2bits __attribute__((__sfr__));

extern volatile unsigned int  IFS3 __attribute__((__sfr__));
typedef struct tagIFS3BITS {
  unsigned :1;
  unsigned SI2C2IF:1;
  unsigned MI2C2IF:1;
  unsigned :6;
  unsigned PSEMIF:1;
  unsigned QEI1IF:1;
} IFS3BITS;
extern volatile IFS3BITS IFS3bits __attribute__((__sfr__));

extern volatile unsigned int  IFS4 __attribute__((__sfr__));
typedef struct tagIFS4BITS {
  unsigned :1;
  unsigned U1EIF:1;
  unsigned U2EIF:1;
  unsigned CRCIF:1;
  unsigned :9;
  unsigned CTMUIF:1;
} IFS4BITS;
extern volatile IFS4BITS IFS4bits __attribute__((__sfr__));

extern volatile unsigned int  IFS8 __attribute__((__sfr__));
typedef struct tagIFS8BITS {
  unsigned :14;
  unsigned ICDIF:1;
  unsigned JTAGIF:1;
} IFS8BITS;
extern volatile IFS8BITS IFS8bits __attribute__((__sfr__));

extern volatile unsigned int  IFS9 __attribute__((__sfr__));
typedef struct tagIFS9BITS {
  unsigned :1;
  unsigned PTGSTEPIF:1;
  unsigned PTGWDTIF:1;
  unsigned PTG0IF:1;
  unsigned PTG1IF:1;
  unsigned PTG2IF:1;
  unsigned PTG3IF:1;
} IFS9BITS;
extern volatile IFS9BITS IFS9bits __attribute__((__sfr__));

extern volatile unsigned int  IEC0 __attribute__((__sfr__));
typedef struct tagIEC0BITS {
  unsigned INT0IE:1;
  unsigned IC1IE:1;
  unsigned OC1IE:1;
  unsigned T1IE:1;
  unsigned DMA0IE:1;
  unsigned IC2IE:1;
  unsigned OC2IE:1;
  unsigned T2IE:1;
  unsigned T3IE:1;
  unsigned SPI1EIE:1;
  unsigned SPI1IE:1;
  unsigned U1RXIE:1;
  unsigned U1TXIE:1;
  unsigned AD1IE:1;
  unsigned DMA1IE:1;
} IEC0BITS;
extern volatile IEC0BITS IEC0bits __attribute__((__sfr__));

extern volatile unsigned int  IEC1 __attribute__((__sfr__));
typedef struct tagIEC1BITS {
  unsigned SI2C1IE:1;
  unsigned MI2C1IE:1;
  unsigned CMIE:1;
  unsigned CNIE:1;
  unsigned INT1IE:1;
  unsigned :3;
  unsigned DMA2IE:1;
  unsigned OC3IE:1;
  unsigned OC4IE:1;
  unsigned T4IE:1;
  unsigned T5IE:1;
  unsigned INT2IE:1;
  unsigned U2RXIE:1;
  unsigned U2TXIE:1;
} IEC1BITS;
extern volatile IEC1BITS IEC1bits __attribute__((__sfr__));

extern volatile unsigned int  IEC2 __attribute__((__sfr__));
typedef struct tagIEC2BITS {
  unsigned SPI2EIE:1;
  unsigned SPI2IE:1;
  unsigned :2;
  unsigned DMA3IE:1;
  unsigned IC3IE:1;
  unsigned IC4IE:1;
} IEC2BITS;
extern volatile IEC2BITS IEC2bits __attribute__((__sfr__));

extern volatile unsigned int  IEC3 __attribute__((__sfr__));
typedef struct tagIEC3BITS {
  unsigned :1;
  unsigned SI2C2IE:1;
  unsigned MI2C2IE:1;
  unsigned :6;
  unsigned PSEMIE:1;
  unsigned QEI1IE:1;
} IEC3BITS;
extern volatile IEC3BITS IEC3bits __attribute__((__sfr__));

extern volatile unsigned int  IEC4 __attribute__((__sfr__));
typedef struct tagIEC4BITS {
  unsigned :1;
  unsigned U1EIE:1;
  unsigned U2EIE:1;
  unsigned CRCIE:1;
  unsigned :9;
  unsigned CTMUIE:1;
} IEC4BITS;
extern volatile IEC4BITS IEC4bits __attribute__((__sfr__));

extern volatile unsigned int  IEC8 __attribute__((__sfr__));
typedef struct tagIEC8BITS {
  unsigned :14;
  unsigned ICDIF:1;
  unsigned JTAGIE:1;
} IEC8BITS;
extern volatile IEC8BITS IEC8bits __attribute__((__sfr__));

extern volatile unsigned int  IEC9 __attribute__((__sfr__));
typedef struct tagIEC9BITS {
  unsigned :1;
  unsigned PTGSTEPIE:1;
  unsigned PTGWDTIE:1;
  unsigned PTG0IE:1;
  unsigned PTG1IE:1;
  unsigned PTG2IE:1;
  unsigned PTG3IE:1;
} IEC9BITS;
extern volatile IEC9BITS IEC9bits __attribute__((__sfr__));

extern volatile unsigned int  IPC0 __attribute__((__sfr__));
__extension__ typedef struct tagIPC0BITS {
  union {
    struct {
      unsigned INT0IP:3;
      unsigned :1;
      unsigned IC1IP:3;
      unsigned :1;
      unsigned OC1IP:3;
      unsigned :1;
      unsigned T1IP:3;
    };
    struct {
      unsigned INT0IP0:1;
      unsigned INT0IP1:1;
      unsigned INT0IP2:1;
      unsigned :1;
      unsigned IC1IP0:1;
      unsigned IC1IP1:1;
      unsigned IC1IP2:1;
      unsigned :1;
      unsigned OC1IP0:1;
      unsigned OC1IP1:1;
      unsigned OC1IP2:1;
      unsigned :1;
      unsigned T1IP0:1;
      unsigned T1IP1:1;
      unsigned T1IP2:1;
    };
  };
} IPC0BITS;
extern volatile IPC0BITS IPC0bits __attribute__((__sfr__));

extern volatile unsigned int  IPC1 __attribute__((__sfr__));
__extension__ typedef struct tagIPC1BITS {
  union {
    struct {
      unsigned DMA0IP:3;
      unsigned :1;
      unsigned IC2IP:3;
      unsigned :1;
      unsigned OC2IP:3;
      unsigned :1;
      unsigned T2IP:3;
    };
    struct {
      unsigned DMA0IP0:1;
      unsigned DMA0IP1:1;
      unsigned DMA0IP2:1;
      unsigned :1;
      unsigned IC2IP0:1;
      unsigned IC2IP1:1;
      unsigned IC2IP2:1;
      unsigned :1;
      unsigned OC2IP0:1;
      unsigned OC2IP1:1;
      unsigned OC2IP2:1;
      unsigned :1;
      unsigned T2IP0:1;
      unsigned T2IP1:1;
      unsigned T2IP2:1;
    };
  };
} IPC1BITS;
extern volatile IPC1BITS IPC1bits __attribute__((__sfr__));

extern volatile unsigned int  IPC2 __attribute__((__sfr__));
__extension__ typedef struct tagIPC2BITS {
  union {
    struct {
      unsigned T3IP:3;
      unsigned :1;
      unsigned SPI1EIP:3;
      unsigned :1;
      unsigned SPI1IP:3;
      unsigned :1;
      unsigned U1RXIP:3;
    };
    struct {
      unsigned T3IP0:1;
      unsigned T3IP1:1;
      unsigned T3IP2:1;
      unsigned :1;
      unsigned SPI1EIP0:1;
      unsigned SPI1EIP1:1;
      unsigned SPI1EIP2:1;
      unsigned :1;
      unsigned SPI1IP0:1;
      unsigned SPI1IP1:1;
      unsigned SPI1IP2:1;
      unsigned :1;
      unsigned U1RXIP0:1;
      unsigned U1RXIP1:1;
      unsigned U1RXIP2:1;
    };
  };
} IPC2BITS;
extern volatile IPC2BITS IPC2bits __attribute__((__sfr__));

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
      unsigned :1;
      unsigned IC16IP0:1;
      unsigned IC16IP1:1;
      unsigned IC16IP2:1;
      unsigned :1;
      unsigned ICDIP0:1;
      unsigned ICDIP1:1;
      unsigned ICDIP2:1;
    };
  };
} IPC35BITS;
extern volatile IPC35BITS IPC35bits __attribute__((__sfr__));

extern volatile unsigned int  IPC36 __attribute__((__sfr__));
typedef struct tagIPC36BITS {
  unsigned :4;
  unsigned PTGSTEPIP:3;
  unsigned :1;
  unsigned PTGWDTIP:3;
  unsigned :1;
  unsigned PTG0IP:3;
} IPC36BITS;
extern volatile IPC36BITS IPC36bits __attribute__((__sfr__));

extern volatile unsigned int  IPC37 __attribute__((__sfr__));
typedef struct tagIPC37BITS {
  unsigned PTG1IP:3;
  unsigned :1;
  unsigned PTG2IP:3;
  unsigned :1;
  unsigned PTG3IP:3;
} IPC37BITS;
extern volatile IPC37BITS IPC37bits __attribute__((__sfr__));

extern volatile unsigned int  INTCON1 __attribute__((__sfr__));
typedef struct tagINTCON1BITS {
  unsigned :1;
  unsigned OSCFAIL:1;
  unsigned STKERR:1;
  unsigned ADDRERR:1;
  unsigned MATHERR:1;
  unsigned DMACERR:1;
  unsigned DIV0ERR:1;
  unsigned :6;
  unsigned OVBERR:1;
  unsigned OVAERR:1;
  unsigned NSTDIS:1;
} INTCON1BITS;
extern volatile INTCON1BITS INTCON1bits __attribute__((__sfr__));

extern volatile unsigned int  INTCON2 __attribute__((__sfr__));
typedef struct tagINTCON2BITS {
  unsigned INT0EP:1;
  unsigned INT1EP:1;
  unsigned INT2EP:1;
  unsigned :10;
  unsigned SWTRAP:1;
  unsigned DISI:1;
  unsigned GIE:1;
} INTCON2BITS;
extern volatile INTCON2BITS INTCON2bits __attribute__((__sfr__));

extern volatile unsigned int  INTCON3 __attribute__((__sfr__));
typedef struct tagINTCON3BITS {
  unsigned :4;
  unsigned DOOVR:1;
  unsigned DAE:1;
} INTCON3BITS;
extern volatile INTCON3BITS INTCON3bits __attribute__((__sfr__));

extern volatile unsigned int  INTCON4 __attribute__((__sfr__));
typedef struct tagINTCON4BITS {
  unsigned SGHT:1;
} INTCON4BITS;
extern volatile INTCON4BITS INTCON4bits __attribute__((__sfr__));

extern volatile unsigned int  INTTREG __attribute__((__sfr__));
__extension__ typedef struct tagINTTREGBITS {
  union {
    struct {
      unsigned VECNUM:8;
      unsigned ILR:4;
    };
    struct {
      unsigned VECNUM0:1;
      unsigned VECNUM1:1;
      unsigned VECNUM2:1;
      unsigned VECNUM3:1;
      unsigned VECNUM4:1;
      unsigned VECNUM5:1;
      unsigned VECNUM6:1;
      unsigned VECNUM7:1;
      unsigned ILR0:1;
      unsigned ILR1:1;
      unsigned ILR2:1;
      unsigned ILR3:1;
    };
  };
} INTTREGBITS;
extern volatile INTTREGBITS INTTREGbits __attribute__((__sfr__));

extern volatile unsigned int  OC1CON1 __attribute__((__sfr__));
__extension__ typedef struct tagOC1CON1BITS {
  union {
    struct {
      unsigned OCM:3;
      unsigned TRIGMODE:1;
      unsigned OCFLTA:1;
      unsigned OCFLTB:1;
      unsigned :1;
      unsigned ENFLTA:1;
      unsigned ENFLTB:1;
      unsigned :1;
      unsigned OCTSEL:3;
      unsigned OCSIDL:1;
    };
    struct {
      unsigned OCM0:1;
      unsigned OCM1:1;
      unsigned OCM2:1;
      unsigned :1;
      unsigned OCFLT:3;
      unsigned ENFLT:3;
      unsigned OCTSEL0:1;
      unsigned OCTSEL1:1;
      unsigned OCTSEL2:1;
    };
    struct {
      unsigned :4;
      unsigned OCFLT0:1;
      unsigned OCFLT1:1;
      unsigned :1;
      unsigned ENFLT0:1;
      unsigned ENFLT1:1;
    };
  };
} OC1CON1BITS;
extern volatile OC1CON1BITS OC1CON1bits __attribute__((__sfr__));

extern volatile unsigned int  OC1CON2 __attribute__((__sfr__));
__extension__ typedef struct tagOC1CON2BITS {
  union {
    struct {
      unsigned SYNCSEL:5;
      unsigned OCTRIS:1;
      unsigned TRIGSTAT:1;
      unsigned OCTRIG:1;
      unsigned OC32:1;
      unsigned :3;
      unsigned OCINV:1;
      unsigned FLTTRIEN:1;
      unsigned FLTOUT:1;
      unsigned FLTMD:1;
    };
    struct {
      unsigned SYNCSEL0:1;
      unsigned SYNCSEL1:1;
      unsigned SYNCSEL2:1;
      unsigned SYNCSEL3:1;
      unsigned SYNCSEL4:1;
      unsigned :9;
      unsigned FLTMODE:1;
    };
  };
} OC1CON2BITS;
extern volatile OC1CON2BITS OC1CON2bits __attribute__((__sfr__));


/* Generic structure of entire SFR area for Output Compare modules */
typedef struct tagOC {
        unsigned int ocxrs;
        unsigned int ocxr;
        unsigned int ocxcon;
} OC, *POC;

/* SFR blocks for Output Compare modules */
extern volatile OC OC1 __attribute__((__sfr__));
extern volatile OC OC2 __attribute__((__sfr__));
extern volatile OC OC3 __attribute__((__sfr__));
extern volatile OC OC4 __attribute__((__sfr__));

extern volatile unsigned int  OC1RS __attribute__((__sfr__));
extern volatile unsigned int  OC1R __attribute__((__sfr__));
extern volatile unsigned int  OC1TMR __attribute__((__sfr__));
extern volatile unsigned int  OC2CON1 __attribute__((__sfr__));
__extension__ typedef struct tagOC2CON1BITS {
  union {
    struct {
      unsigned OCM:3;
      unsigned TRIGMODE:1;
      unsigned OCFLTA:1;
      unsigned OCFLTB:1;
      unsigned :1;
      unsigned ENFLTA:1;
      unsigned ENFLTB:1;
      unsigned :1;
      unsigned OCTSEL:3;
      unsigned OCSIDL:1;
    };
    struct {
      unsigned OCM0:1;
      unsigned OCM1:1;
      unsigned OCM2:1;
      unsigned :1;
      unsigned OCFLT:3;
      unsigned ENFLT:3;
      unsigned OCTSEL0:1;
      unsigned OCTSEL1:1;
      unsigned OCTSEL2:1;
    };
    struct {
      unsigned :4;
      unsigned OCFLT0:1;
      unsigned OCFLT1:1;
      unsigned :1;
      unsigned ENFLT0:1;
      unsigned ENFLT1:1;
    };
  };
} OC2CON1BITS;
extern volatile OC2CON1BITS OC2CON1bits __attribute__((__sfr__));

extern volatile unsigned int  OC2CON2 __attribute__((__sfr__));
__extension__ typedef struct tagOC2CON2BITS {
  union {
    struct {
      unsigned SYNCSEL:5;
      unsigned OCTRIS:1;
      unsigned TRIGSTAT:1;
      unsigned OCTRIG:1;
      unsigned OC32:1;
      unsigned :3;
      unsigned OCINV:1;
      unsigned FLTTRIEN:1;
      unsigned FLTOUT:1;
      unsigned FLTMD:1;
    };
    struct {
      unsigned SYNCSEL0:1;
      unsigned SYNCSEL1:1;
      unsigned SYNCSEL2:1;
      unsigned SYNCSEL3:1;
      unsigned SYNCSEL4:1;
      unsigned :9;
      unsigned FLTMODE:1;
    };
  };
} OC2CON2BITS;
extern volatile OC2CON2BITS OC2CON2bits __attribute__((__sfr__));

extern volatile unsigned int  OC2RS __attribute__((__sfr__));
extern volatile unsigned int  OC2R __attribute__((__sfr__));
extern volatile unsigned int  OC2TMR __attribute__((__sfr__));
extern volatile unsigned int  OC3CON1 __attribute__((__sfr__));
__extension__ typedef struct tagOC3CON1BITS {
  union {
    struct {
      unsigned OCM:3;
      unsigned TRIGMODE:1;
      unsigned OCFLTA:1;
      unsigned OCFLTB:1;
      unsigned :1;
      unsigned ENFLTA:1;
      unsigned ENFLTB:1;
      unsigned :1;
      unsigned OCTSEL:3;
      unsigned OCSIDL:1;
    };
    struct {
      unsigned OCM0:1;
      unsigned OCM1:1;
      unsigned OCM2:1;
      unsigned :1;
      unsigned OCFLT:3;
      unsigned ENFLT:3;
      unsigned OCTSEL0:1;
      unsigned OCTSEL1:1;
      unsigned OCTSEL2:1;
    };
    struct {
      unsigned :4;
      unsigned OCFLT0:1;
      unsigned OCFLT1:1;
      unsigned :1;
      unsigned ENFLT0:1;
      unsigned ENFLT1:1;
    };
  };
} OC3CON1BITS;
extern volatile OC3CON1BITS OC3CON1bits __attribute__((__sfr__));

extern volatile unsigned int  OC3CON2 __attribute__((__sfr__));
__extension__ typedef struct tagOC3CON2BITS {
  union {
    struct {
      unsigned SYNCSEL:5;
      unsigned OCTRIS:1;
      unsigned TRIGSTAT:1;
      unsigned OCTRIG:1;
      unsigned OC32:1;
      unsigned :3;
      unsigned OCINV:1;
      unsigned FLTTRIEN:1;
      unsigned FLTOUT:1;
      unsigned FLTMD:1;
    };
    struct {
      unsigned SYNCSEL0:1;
      unsigned SYNCSEL1:1;
      unsigned SYNCSEL2:1;
      unsigned SYNCSEL3:1;
      unsigned SYNCSEL4:1;
      unsigned :9;
      unsigned FLTMODE:1;
    };
  };
} OC3CON2BITS;
extern volatile OC3CON2BITS OC3CON2bits __attribute__((__sfr__));

extern volatile unsigned int  OC3RS __attribute__((__sfr__));
extern volatile unsigned int  OC3R __attribute__((__sfr__));
extern volatile unsigned int  OC3TMR __attribute__((__sfr__));
extern volatile unsigned int  OC4CON1 __attribute__((__sfr__));
__extension__ typedef struct tagOC4CON1BITS {
  union {
    struct {
      unsigned OCM:3;
      unsigned TRIGMODE:1;
      unsigned OCFLTA:1;
      unsigned OCFLTB:1;
      unsigned :1;
      unsigned ENFLTA:1;
      unsigned ENFLTB:1;
      unsigned :1;
      unsigned OCTSEL:3;
      unsigned OCSIDL:1;
    };
    struct {
      unsigned OCM0:1;
      unsigned OCM1:1;
      unsigned OCM2:1;
      unsigned :1;
      unsigned OCFLT:3;
      unsigned ENFLT:3;
      unsigned OCTSEL0:1;
      unsigned OCTSEL1:1;
      unsigned OCTSEL2:1;
    };
    struct {
      unsigned :4;
      unsigned OCFLT0:1;
      unsigned OCFLT1:1;
      unsigned :1;
      unsigned ENFLT0:1;
      unsigned ENFLT1:1;
    };
  };
} OC4CON1BITS;
extern volatile OC4CON1BITS OC4CON1bits __attribute__((__sfr__));

extern volatile unsigned int  OC4CON2 __attribute__((__sfr__));
__extension__ typedef struct tagOC4CON2BITS {
  union {
    struct {
      unsigned SYNCSEL:5;
      unsigned OCTRIS:1;
      unsigned TRIGSTAT:1;
      unsigned OCTRIG:1;
      unsigned OC32:1;
      unsigned :3;
      unsigned OCINV:1;
      unsigned FLTTRIEN:1;
      unsigned FLTOUT:1;
      unsigned FLTMD:1;
    };
    struct {
      unsigned SYNCSEL0:1;
      unsigned SYNCSEL1:1;
      unsigned SYNCSEL2:1;
      unsigned SYNCSEL3:1;
      unsigned SYNCSEL4:1;
      unsigned :9;
      unsigned FLTMODE:1;
    };
  };
} OC4CON2BITS;
extern volatile OC4CON2BITS OC4CON2bits __attribute__((__sfr__));

extern volatile unsigned int  OC4RS __attribute__((__sfr__));
extern volatile unsigned int  OC4R __attribute__((__sfr__));
extern volatile unsigned int  OC4TMR __attribute__((__sfr__));
extern volatile unsigned int  CMSTAT __attribute__((__sfr__));
typedef struct tagCMSTATBITS {
  unsigned C1OUT:1;
  unsigned C2OUT:1;
  unsigned C3OUT:1;
  unsigned C4OUT:1;
  unsigned :4;
  unsigned C1EVT:1;
  unsigned C2EVT:1;
  unsigned C3EVT:1;
  unsigned C4EVT:1;
  unsigned :3;
  unsigned CMSIDL:1;
} CMSTATBITS;
extern volatile CMSTATBITS CMSTATbits __attribute__((__sfr__));

extern volatile unsigned int  CVRCON __attribute__((__sfr__));
__extension__ typedef struct tagCVRCONBITS {
  union {
    struct {
      unsigned CVR:4;
      unsigned CVRSS:1;
      unsigned CVRR:1;
      unsigned CVROE:1;
      unsigned CVREN:1;
      unsigned :2;
      unsigned VREFSEL:1;
      unsigned :3;
      unsigned CVR2OE:1;
    };
    struct {
      unsigned CVR0:1;
      unsigned CVR1:1;
      unsigned CVR2:1;
      unsigned CVR3:1;
      unsigned :2;
      unsigned CVR1OE:1;
      unsigned :1;
      unsigned BGSEL0:1;
      unsigned BGSEL1:1;
    };
  };
} CVRCONBITS;
extern volatile CVRCONBITS CVRCONbits __attribute__((__sfr__));

extern volatile unsigned int  CM1CON __attribute__((__sfr__));
__extension__ typedef struct tagCM1CONBITS {
  union {
    struct {
      unsigned CCH:2;
      unsigned :2;
      unsigned CREF:1;
      unsigned :1;
      unsigned EVPOL:2;
      unsigned COUT:1;
      unsigned CEVT:1;
      unsigned OPMODE:1;
      unsigned :2;
      unsigned CPOL:1;
      unsigned COE:1;
      unsigned CON:1;
    };
    struct {
      unsigned CCH0:1;
      unsigned CCH1:1;
      unsigned :4;
      unsigned EVPOL0:1;
      unsigned EVPOL1:1;
      unsigned :7;
      unsigned CEN:1;
    };
  };
} CM1CONBITS;
extern volatile CM1CONBITS CM1CONbits __attribute__((__sfr__));

extern volatile unsigned int  CM1MSKSRC __attribute__((__sfr__));
__extension__ typedef struct tagCM1MSKSRCBITS {
  union {
    struct {
      unsigned SELSRCA:4;
      unsigned SELSRCB:4;
      unsigned SELSRCC:4;
    };
    struct {
      unsigned SELSRCA0:1;
      unsigned SELSRCA1:1;
      unsigned SELSRCA2:1;
      unsigned SELSRCA3:1;
      unsigned SELSRCB0:1;
      unsigned SELSRCB1:1;
      unsigned SELSRCB2:1;
      unsigned SELSRCB3:1;
      unsigned SELSRCC0:1;
      unsigned SELSRCC1:1;
      unsigned SELSRCC2:1;
      unsigned SELSRCC3:1;
    };
  };
} CM1MSKSRCBITS;
extern volatile CM1MSKSRCBITS CM1MSKSRCbits __attribute__((__sfr__));

extern volatile unsigned int  CM1MSKCON __attribute__((__sfr__));
typedef struct tagCM1MSKCONBITS {
  unsigned AANEN:1;
  unsigned AAEN:1;
  unsigned ABNEN:1;
  unsigned ABEN:1;
  unsigned ACNEN:1;
  unsigned ACEN:1;
  unsigned PAGS:1;
  unsigned NAGS:1;
  unsigned OANEN:1;
  unsigned OAEN:1;
  unsigned OBNEN:1;
  unsigned OBEN:1;
  unsigned OCNEN:1;
  unsigned OCEN:1;
  unsigned :1;
  unsigned HLMS:1;
} CM1MSKCONBITS;
extern volatile CM1MSKCONBITS CM1MSKCONbits __attribute__((__sfr__));

extern volatile unsigned int  CM1FLTR __attribute__((__sfr__));
__extension__ typedef struct tagCM1FLTRBITS {
  union {
    struct {
      unsigned CFDIV:3;
      unsigned CFLTREN:1;
      unsigned CFSEL:3;
    };
    struct {
      unsigned CFDIV0:1;
      unsigned CFDIV1:1;
      unsigned CFDIV2:1;
      unsigned :1;
      unsigned CFSEL0:1;
      unsigned CFSEL1:1;
      unsigned CFSEL2:1;
    };
  };
} CM1FLTRBITS;
extern volatile CM1FLTRBITS CM1FLTRbits __attribute__((__sfr__));

extern volatile unsigned int  CM2CON __attribute__((__sfr__));
__extension__ typedef struct tagCM2CONBITS {
  union {
    struct {
      unsigned CCH:2;
      unsigned :2;
      unsigned CREF:1;
      unsigned :1;
      unsigned EVPOL:2;
      unsigned COUT:1;
      unsigned CEVT:1;
      unsigned OPMODE:1;
      unsigned :2;
      unsigned CPOL:1;
      unsigned COE:1;
      unsigned CON:1;
    };
    struct {
      unsigned CCH0:1;
      unsigned CCH1:1;
      unsigned :4;
      unsigned EVPOL0:1;
      unsigned EVPOL1:1;
      unsigned :7;
      unsigned CEN:1;
    };
  };
} CM2CONBITS;
extern volatile CM2CONBITS CM2CONbits __attribute__((__sfr__));

extern volatile unsigned int  CM2MSKSRC __attribute__((__sfr__));
__extension__ typedef struct tagCM2MSKSRCBITS {
  union {
    struct {
      unsigned SELSRCA:4;
      unsigned SELSRCB:4;
      unsigned SELSRCC:4;
    };
    struct {
      unsigned SELSRCA0:1;
      unsigned SELSRCA1:1;
      unsigned SELSRCA2:1;
      unsigned SELSRCA3:1;
      unsigned SELSRCB0:1;
      unsigned SELSRCB1:1;
      unsigned SELSRCB2:1;
      unsigned SELSRCB3:1;
      unsigned SELSRCC0:1;
      unsigned SELSRCC1:1;
      unsigned SELSRCC2:1;
      unsigned SELSRCC3:1;
    };
  };
} CM2MSKSRCBITS;
extern volatile CM2MSKSRCBITS CM2MSKSRCbits __attribute__((__sfr__));

extern volatile unsigned int  CM2MSKCON __attribute__((__sfr__));
typedef struct tagCM2MSKCONBITS {
  unsigned AANEN:1;
  unsigned AAEN:1;
  unsigned ABNEN:1;
  unsigned ABEN:1;
  unsigned ACNEN:1;
  unsigned ACEN:1;
  unsigned PAGS:1;
  unsigned NAGS:1;
  unsigned OANEN:1;
  unsigned OAEN:1;
  unsigned OBNEN:1;
  unsigned OBEN:1;
  unsigned OCNEN:1;
  unsigned OCEN:1;
  unsigned :1;
  unsigned HLMS:1;
} CM2MSKCONBITS;
extern volatile CM2MSKCONBITS CM2MSKCONbits __attribute__((__sfr__));

extern volatile unsigned int  CM2FLTR __attribute__((__sfr__));
__extension__ typedef struct tagCM2FLTRBITS {
  union {
    struct {
      unsigned CFDIV:3;
      unsigned CFLTREN:1;
      unsigned CFSEL:3;
    };
    struct {
      unsigned CFDIV0:1;
      unsigned CFDIV1:1;
      unsigned CFDIV2:1;
      unsigned :1;
      unsigned CFSEL0:1;
      unsigned CFSEL1:1;
      unsigned CFSEL2:1;
    };
  };
} CM2FLTRBITS;
extern volatile CM2FLTRBITS CM2FLTRbits __attribute__((__sfr__));

extern volatile unsigned int  CM3CON __attribute__((__sfr__));
__extension__ typedef struct tagCM3CONBITS {
  union {
    struct {
      unsigned CCH:2;
      unsigned :2;
      unsigned CREF:1;
      unsigned :1;
      unsigned EVPOL:2;
      unsigned COUT:1;
      unsigned CEVT:1;
      unsigned OPMODE:1;
      unsigned :2;
      unsigned CPOL:1;
      unsigned COE:1;
      unsigned CON:1;
    };
    struct {
      unsigned CCH0:1;
      unsigned CCH1:1;
      unsigned :4;
      unsigned EVPOL0:1;
      unsigned EVPOL1:1;
      unsigned :7;
      unsigned CEN:1;
    };
  };
} CM3CONBITS;
extern volatile CM3CONBITS CM3CONbits __attribute__((__sfr__));

extern volatile unsigned int  CM3MSKSRC __attribute__((__sfr__));
__extension__ typedef struct tagCM3MSKSRCBITS {
  union {
    struct {
      unsigned SELSRCA:4;
      unsigned SELSRCB:4;
      unsigned SELSRCC:4;
    };
    struct {
      unsigned SELSRCA0:1;
      unsigned SELSRCA1:1;
      unsigned SELSRCA2:1;
      unsigned SELSRCA3:1;
      unsigned SELSRCB0:1;
      unsigned SELSRCB1:1;
      unsigned SELSRCB2:1;
      unsigned SELSRCB3:1;
      unsigned SELSRCC0:1;
      unsigned SELSRCC1:1;
      unsigned SELSRCC2:1;
      unsigned SELSRCC3:1;
    };
  };
} CM3MSKSRCBITS;
extern volatile CM3MSKSRCBITS CM3MSKSRCbits __attribute__((__sfr__));

extern volatile unsigned int  CM3MSKCON __attribute__((__sfr__));
typedef struct tagCM3MSKCONBITS {
  unsigned AANEN:1;
  unsigned AAEN:1;
  unsigned ABNEN:1;
  unsigned ABEN:1;
  unsigned ACNEN:1;
  unsigned ACEN:1;
  unsigned PAGS:1;
  unsigned NAGS:1;
  unsigned OANEN:1;
  unsigned OAEN:1;
  unsigned OBNEN:1;
  unsigned OBEN:1;
  unsigned OCNEN:1;
  unsigned OCEN:1;
  unsigned :1;
  unsigned HLMS:1;
} CM3MSKCONBITS;
extern volatile CM3MSKCONBITS CM3MSKCONbits __attribute__((__sfr__));

extern volatile unsigned int  CM3FLTR __attribute__((__sfr__));
__extension__ typedef struct tagCM3FLTRBITS {
  union {
    struct {
      unsigned CFDIV:3;
      unsigned CFLTREN:1;
      unsigned CFSEL:3;
    };
    struct {
      unsigned CFDIV0:1;
      unsigned CFDIV1:1;
      unsigned CFDIV2:1;
      unsigned :1;
      unsigned CFSEL0:1;
      unsigned CFSEL1:1;
      unsigned CFSEL2:1;
    };
  };
} CM3FLTRBITS;
extern volatile CM3FLTRBITS CM3FLTRbits __attribute__((__sfr__));

extern volatile unsigned int  CM4CON __attribute__((__sfr__));
__extension__ typedef struct tagCM4CONBITS {
  union {
    struct {
      unsigned CCH:2;
      unsigned :2;
      unsigned CREF:1;
      unsigned :1;
      unsigned EVPOL:2;
      unsigned COUT:1;
      unsigned CEVT:1;
      unsigned :3;
      unsigned CPOL:1;
      unsigned COE:1;
      unsigned CON:1;
    };
    struct {
      unsigned CCH0:1;
      unsigned CCH1:1;
      unsigned :4;
      unsigned EVPOL0:1;
      unsigned EVPOL1:1;
      unsigned :7;
      unsigned CEN:1;
    };
  };
} CM4CONBITS;
extern volatile CM4CONBITS CM4CONbits __attribute__((__sfr__));

extern volatile unsigned int  CM4MSKSRC __attribute__((__sfr__));
__extension__ typedef struct tagCM4MSKSRCBITS {
  union {
    struct {
      unsigned SELSRCA:4;
      unsigned SELSRCB:4;
      unsigned SELSRCC:4;
    };
    struct {
      unsigned SELSRCA0:1;
      unsigned SELSRCA1:1;
      unsigned SELSRCA2:1;
      unsigned SELSRCA3:1;
      unsigned SELSRCB0:1;
      unsigned SELSRCB1:1;
      unsigned SELSRCB2:1;
      unsigned SELSRCB3:1;
      unsigned SELSRCC0:1;
      unsigned SELSRCC1:1;
      unsigned SELSRCC2:1;
      unsigned SELSRCC3:1;
    };
  };
} CM4MSKSRCBITS;
extern volatile CM4MSKSRCBITS CM4MSKSRCbits __attribute__((__sfr__));

extern volatile unsigned int  CM4MSKCON __attribute__((__sfr__));
typedef struct tagCM4MSKCONBITS {
  unsigned AANEN:1;
  unsigned AAEN:1;
  unsigned ABNEN:1;
  unsigned ABEN:1;
  unsigned ACNEN:1;
  unsigned ACEN:1;
  unsigned PAGS:1;
  unsigned NAGS:1;
  unsigned OANEN:1;
  unsigned OAEN:1;
  unsigned OBNEN:1;
  unsigned OBEN:1;
  unsigned OCNEN:1;
  unsigned OCEN:1;
  unsigned :1;
  unsigned HLMS:1;
} CM4MSKCONBITS;
extern volatile CM4MSKCONBITS CM4MSKCONbits __attribute__((__sfr__));

extern volatile unsigned int  CM4FLTR __attribute__((__sfr__));
__extension__ typedef struct tagCM4FLTRBITS {
  union {
    struct {
      unsigned CFDIV:3;
      unsigned CFLTREN:1;
      unsigned CFSEL:3;
    };
    struct {
      unsigned CFDIV0:1;
      unsigned CFDIV1:1;
      unsigned CFDIV2:1;
      unsigned :1;
      unsigned CFSEL0:1;
      unsigned CFSEL1:1;
      unsigned CFSEL2:1;
    };
  };
} CM4FLTRBITS;
extern volatile CM4FLTRBITS CM4FLTRbits __attribute__((__sfr__));

extern volatile unsigned int  PTGCST __attribute__((__sfr__));
__extension__ typedef struct tagPTGCSTBITS {
  union {
    struct {
      unsigned PTGITM:2;
      unsigned :4;
      unsigned PTGWTO:1;
      unsigned PTGSTRT:1;
      unsigned PTGIVIS:1;
      unsigned :1;
      unsigned PTGSWT:1;
      unsigned :1;
      unsigned PTGTOGL:1;
      unsigned PTGSIDL:1;
      unsigned :1;
      unsigned PTGEN:1;
    };
    struct {
      unsigned :5;
      unsigned SSRC0:1;
      unsigned SSRC1:1;
      unsigned SSRC2:1;
      unsigned FORM0:1;
      unsigned FORM1:1;
    };
  };
} PTGCSTBITS;
extern volatile PTGCSTBITS PTGCSTbits __attribute__((__sfr__));

extern volatile unsigned int  PTGCON __attribute__((__sfr__));
typedef struct tagPTGCONBITS {
  unsigned PTGWDT:3;
  unsigned :1;
  unsigned PTGPWD:4;
  unsigned PTGDIV:5;
  unsigned PTGCLK:3;
} PTGCONBITS;
extern volatile PTGCONBITS PTGCONbits __attribute__((__sfr__));

extern volatile unsigned int  PTGBTE __attribute__((__sfr__));
typedef struct tagPTGBTEBITS {
  unsigned OC1TSS:1;
  unsigned OC2TSS:1;
  unsigned OC3TSS:1;
  unsigned OC4TSS:1;
  unsigned OC1CS:1;
  unsigned OC2CS:1;
  unsigned OC3CS:1;
  unsigned OC4CS:1;
  unsigned IC1TSS:1;
  unsigned IC2TSS:1;
  unsigned IC3TSS:1;
  unsigned IC4TSS:1;
  unsigned ADCTS1:1;
  unsigned ADCTS2:1;
  unsigned ADCTS3:1;
  unsigned ADCTS4:1;
} PTGBTEBITS;
extern volatile PTGBTEBITS PTGBTEbits __attribute__((__sfr__));

extern volatile unsigned int  PTGHOLD __attribute__((__sfr__));
extern volatile unsigned int  PTGT0LIM __attribute__((__sfr__));
extern volatile unsigned int  PTGT1LIM __attribute__((__sfr__));
extern volatile unsigned int  PTGSDLIM __attribute__((__sfr__));
extern volatile unsigned int  PTGC0LIM __attribute__((__sfr__));
extern volatile unsigned int  PTGC1LIM __attribute__((__sfr__));
extern volatile unsigned int  PTGADJ __attribute__((__sfr__));
extern volatile unsigned int  PTGL0 __attribute__((__sfr__));
extern volatile unsigned int  PTGQPTR __attribute__((__sfr__));
typedef struct tagPTGQPTRBITS {
  unsigned PTGQPTR:5;
} PTGQPTRBITS;
extern volatile PTGQPTRBITS PTGQPTRbits __attribute__((__sfr__));

extern volatile unsigned int  PTGQUE0 __attribute__((__sfr__));
typedef struct tagPTGQUE0BITS {
  unsigned STEP0:8;
  unsigned STEP1:8;
} PTGQUE0BITS;
extern volatile PTGQUE0BITS PTGQUE0bits __attribute__((__sfr__));

extern volatile unsigned int  PTGQUE1 __attribute__((__sfr__));
typedef struct tagPTGQUE1BITS {
  unsigned STEP2:8;
  unsigned STEP3:8;
} PTGQUE1BITS;
extern volatile PTGQUE1BITS PTGQUE1bits __attribute__((__sfr__));

extern volatile unsigned int  PTGQUE2 __attribute__((__sfr__));
typedef struct tagPTGQUE2BITS {
  unsigned STEP4:8;
  unsigned STEP5:8;
} PTGQUE2BITS;
extern volatile PTGQUE2BITS PTGQUE2bits __attribute__((__sfr__));

extern volatile unsigned int  PTGQUE3 __attribute__((__sfr__));
typedef struct tagPTGQUE3BITS {
  unsigned STEP6:8;
  unsigned STEP7:8;
} PTGQUE3BITS;
extern volatile PTGQUE3BITS PTGQUE3bits __attribute__((__sfr__));

extern volatile unsigned int  PTGQUE4 __attribute__((__sfr__));
typedef struct tagPTGQUE4BITS {
  unsigned STEP8:8;
  unsigned STEP9:8;
} PTGQUE4BITS;
extern volatile PTGQUE4BITS PTGQUE4bits __attribute__((__sfr__));

extern volatile unsigned int  PTGQUE5 __attribute__((__sfr__));
typedef struct tagPTGQUE5BITS {
  unsigned STEP10:8;
  unsigned STEP11:8;
} PTGQUE5BITS;
extern volatile PTGQUE5BITS PTGQUE5bits __attribute__((__sfr__));

extern volatile unsigned int  PTGQUE6 __attribute__((__sfr__));
typedef struct tagPTGQUE6BITS {
  unsigned STEP12:8;
  unsigned STEP13:8;
} PTGQUE6BITS;
extern volatile PTGQUE6BITS PTGQUE6bits __attribute__((__sfr__));

extern volatile unsigned int  PTGQUE7 __attribute__((__sfr__));
typedef struct tagPTGQUE7BITS {
  unsigned STEP14:8;
  unsigned STEP15:8;
} PTGQUE7BITS;
extern volatile PTGQUE7BITS PTGQUE7bits __attribute__((__sfr__));

extern volatile unsigned int  DMA0CON __attribute__((__sfr__));
__extension__ typedef struct tagDMA0CONBITS {
  union {
    struct {
      unsigned MODE:2;
      unsigned :2;
      unsigned AMODE:2;
      unsigned :5;
      unsigned NULLW:1;
      unsigned HALF:1;
      unsigned DIR:1;
      unsigned SIZE:1;
      unsigned CHEN:1;
    };
    struct {
      unsigned MODE0:1;
      unsigned MODE1:1;
      unsigned :2;
      unsigned AMODE0:1;
      unsigned AMODE1:1;
    };
  };
} DMA0CONBITS;
extern volatile DMA0CONBITS DMA0CONbits __attribute__((__sfr__));

extern volatile unsigned int  DMA0REQ __attribute__((__sfr__));
__extension__ typedef struct tagDMA0REQBITS {
  union {
    struct {
      unsigned IRQSEL:8;
      unsigned :7;
      unsigned FORCE:1;
    };
    struct {
      unsigned IRQSEL0:1;
      unsigned IRQSEL1:1;
      unsigned IRQSEL2:1;
      unsigned IRQSEL3:1;
      unsigned IRQSEL4:1;
      unsigned IRQSEL5:1;
      unsigned IRQSEL6:1;
      unsigned IRQSEL7:1;
    };
  };
} DMA0REQBITS;
extern volatile DMA0REQBITS DMA0REQbits __attribute__((__sfr__));

extern volatile unsigned int  DMA0STAL __attribute__((__sfr__));
extern volatile unsigned int  DMA0STAH __attribute__((__sfr__));
typedef struct tagDMA0STAHBITS {
  unsigned STA:8;
} DMA0STAHBITS;
extern volatile DMA0STAHBITS DMA0STAHbits __attribute__((__sfr__));

extern volatile unsigned int  DMA0STBL __attribute__((__sfr__));
extern volatile unsigned int  DMA0STBH __attribute__((__sfr__));
typedef struct tagDMA0STBHBITS {
  unsigned STB:8;
} DMA0STBHBITS;
extern volatile DMA0STBHBITS DMA0STBHbits __attribute__((__sfr__));

extern volatile unsigned int  DMA0PAD __attribute__((__sfr__));
extern volatile unsigned int  DMA0CNT __attribute__((__sfr__));
typedef struct tagDMA0CNTBITS {
  unsigned CNT:14;
} DMA0CNTBITS;
extern volatile DMA0CNTBITS DMA0CNTbits __attribute__((__sfr__));

extern volatile unsigned int  DMA1CON __attribute__((__sfr__));
__extension__ typedef struct tagDMA1CONBITS {
  union {
    struct {
      unsigned MODE:2;
      unsigned :2;
      unsigned AMODE:2;
      unsigned :5;
      unsigned NULLW:1;
      unsigned HALF:1;
      unsigned DIR:1;
      unsigned SIZE:1;
      unsigned CHEN:1;
    };
    struct {
      unsigned MODE0:1;
      unsigned MODE1:1;
      unsigned :2;
      unsigned AMODE0:1;
      unsigned AMODE1:1;
    };
  };
} DMA1CONBITS;
extern volatile DMA1CONBITS DMA1CONbits __attribute__((__sfr__));

extern volatile unsigned int  DMA1REQ __attribute__((__sfr__));
__extension__ typedef struct tagDMA1REQBITS {
  union {
    struct {
      unsigned IRQSEL:8;
      unsigned :7;
      unsigned FORCE:1;
    };
    struct {
      unsigned IRQSEL0:1;
      unsigned IRQSEL1:1;
      unsigned IRQSEL2:1;
      unsigned IRQSEL3:1;
      unsigned IRQSEL4:1;
      unsigned IRQSEL5:1;
      unsigned IRQSEL6:1;
      unsigned IRQSEL7:1;
    };
  };
} DMA1REQBITS;
extern volatile DMA1REQBITS DMA1REQbits __attribute__((__sfr__));

extern volatile unsigned int  DMA1STAL __attribute__((__sfr__));
extern volatile unsigned int  DMA1STAH __attribute__((__sfr__));
typedef struct tagDMA1STAHBITS {
  unsigned STA:8;
} DMA1STAHBITS;
extern volatile DMA1STAHBITS DMA1STAHbits __attribute__((__sfr__));

extern volatile unsigned int  DMA1STBL __attribute__((__sfr__));
extern volatile unsigned int  DMA1STBH __attribute__((__sfr__));
typedef struct tagDMA1STBHBITS {
  unsigned STB:8;
} DMA1STBHBITS;
extern volatile DMA1STBHBITS DMA1STBHbits __attribute__((__sfr__));

extern volatile unsigned int  DMA1PAD __attribute__((__sfr__));
extern volatile unsigned int  DMA1CNT __attribute__((__sfr__));
typedef struct tagDMA1CNTBITS {
  unsigned CNT:14;
} DMA1CNTBITS;
extern volatile DMA1CNTBITS DMA1CNTbits __attribute__((__sfr__));

extern volatile unsigned int  DMA2CON __attribute__((__sfr__));
__extension__ typedef struct tagDMA2CONBITS {
  union {
    struct {
      unsigned MODE:2;
      unsigned :2;
      unsigned AMODE:2;
      unsigned :5;
      unsigned NULLW:1;
      unsigned HALF:1;
      unsigned DIR:1;
      unsigned SIZE:1;
      unsigned CHEN:1;
    };
    struct {
      unsigned MODE0:1;
      unsigned MODE1:1;
      unsigned :2;
      unsigned AMODE0:1;
      unsigned AMODE1:1;
    };
  };
} DMA2CONBITS;
extern volatile DMA2CONBITS DMA2CONbits __attribute__((__sfr__));

extern volatile unsigned int  DMA2REQ __attribute__((__sfr__));
__extension__ typedef struct tagDMA2REQBITS {
  union {
    struct {
      unsigned IRQSEL:8;
      unsigned :7;
      unsigned FORCE:1;
    };
    struct {
      unsigned IRQSEL0:1;
      unsigned IRQSEL1:1;
      unsigned IRQSEL2:1;
      unsigned IRQSEL3:1;
      unsigned IRQSEL4:1;
      unsigned IRQSEL5:1;
      unsigned IRQSEL6:1;
      unsigned IRQSEL7:1;
    };
  };
} DMA2REQBITS;
extern volatile DMA2REQBITS DMA2REQbits __attribute__((__sfr__));

extern volatile unsigned int  DMA2STAL __attribute__((__sfr__));
extern volatile unsigned int  DMA2STAH __attribute__((__sfr__));
typedef struct tagDMA2STAHBITS {
  unsigned STA:8;
} DMA2STAHBITS;
extern volatile DMA2STAHBITS DMA2STAHbits __attribute__((__sfr__));

extern volatile unsigned int  DMA2STBL __attribute__((__sfr__));
extern volatile unsigned int  DMA2STBH __attribute__((__sfr__));
typedef struct tagDMA2STBHBITS {
  unsigned STB:8;
} DMA2STBHBITS;
extern volatile DMA2STBHBITS DMA2STBHbits __attribute__((__sfr__));

extern volatile unsigned int  DMA2PAD __attribute__((__sfr__));
extern volatile unsigned int  DMA2CNT __attribute__((__sfr__));
typedef struct tagDMA2CNTBITS {
  unsigned CNT:14;
} DMA2CNTBITS;
extern volatile DMA2CNTBITS DMA2CNTbits __attribute__((__sfr__));

extern volatile unsigned int  DMA3CON __attribute__((__sfr__));
__extension__ typedef struct tagDMA3CONBITS {
  union {
    struct {
      unsigned MODE:2;
      unsigned :2;
      unsigned AMODE:2;
      unsigned :5;
      unsigned NULLW:1;
      unsigned HALF:1;
      unsigned DIR:1;
      unsigned SIZE:1;
      unsigned CHEN:1;
    };
    struct {
      unsigned MODE0:1;
      unsigned MODE1:1;
      unsigned :2;
      unsigned AMODE0:1;
      unsigned AMODE1:1;
    };
  };
} DMA3CONBITS;
extern volatile DMA3CONBITS DMA3CONbits __attribute__((__sfr__));

extern volatile unsigned int  DMA3REQ __attribute__((__sfr__));
__extension__ typedef struct tagDMA3REQBITS {
  union {
    struct {
      unsigned IRQSEL:8;
      unsigned :7;
      unsigned FORCE:1;
    };
    struct {
      unsigned IRQSEL0:1;
      unsigned IRQSEL1:1;
      unsigned IRQSEL2:1;
      unsigned IRQSEL3:1;
      unsigned IRQSEL4:1;
      unsigned IRQSEL5:1;
      unsigned IRQSEL6:1;
      unsigned IRQSEL7:1;
    };
  };
} DMA3REQBITS;
extern volatile DMA3REQBITS DMA3REQbits __attribute__((__sfr__));

extern volatile unsigned int  DMA3STAL __attribute__((__sfr__));
extern volatile unsigned int  DMA3STAH __attribute__((__sfr__));
typedef struct tagDMA3STAHBITS {
  unsigned STA:8;
} DMA3STAHBITS;
extern volatile DMA3STAHBITS DMA3STAHbits __attribute__((__sfr__));

extern volatile unsigned int  DMA3STBL __attribute__((__sfr__));
extern volatile unsigned int  DMA3STBH __attribute__((__sfr__));
typedef struct tagDMA3STBHBITS {
  unsigned STB:8;
} DMA3STBHBITS;
extern volatile DMA3STBHBITS DMA3STBHbits __attribute__((__sfr__));

extern volatile unsigned int  DMA3PAD __attribute__((__sfr__));
extern volatile unsigned int  DMA3CNT __attribute__((__sfr__));
typedef struct tagDMA3CNTBITS {
  unsigned CNT:14;
} DMA3CNTBITS;
extern volatile DMA3CNTBITS DMA3CNTbits __attribute__((__sfr__));

extern volatile unsigned int  DMAPWC __attribute__((__sfr__));
typedef struct tagDMAPWCBITS {
  unsigned PWCOL0:1;
  unsigned PWCOL1:1;
  unsigned PWCOL2:1;
  unsigned PWCOL3:1;
} DMAPWCBITS;
extern volatile DMAPWCBITS DMAPWCbits __attribute__((__sfr__));

extern volatile unsigned int  DMARQC __attribute__((__sfr__));
typedef struct tagDMARQCBITS {
  unsigned RQCOL0:1;
  unsigned RQCOL1:1;
  unsigned RQCOL2:1;
  unsigned RQCOL3:1;
} DMARQCBITS;
extern volatile DMARQCBITS DMARQCbits __attribute__((__sfr__));

extern volatile unsigned int  DMAPPS __attribute__((__sfr__));
typedef struct tagDMAPPSBITS {
  unsigned PPST0:1;
  unsigned PPST1:1;
  unsigned PPST2:1;
  unsigned PPST3:1;
} DMAPPSBITS;
extern volatile DMAPPSBITS DMAPPSbits __attribute__((__sfr__));

extern volatile unsigned int  DMALCA __attribute__((__sfr__));
__extension__ typedef struct tagDMALCABITS {
  union {
    struct {
      unsigned LSTCH:4;
    };
    struct {
      unsigned LSTCH0:1;
      unsigned LSTCH1:1;
      unsigned LSTCH2:1;
      unsigned LSTCH3:1;
    };
  };
} DMALCABITS;
extern volatile DMALCABITS DMALCAbits __attribute__((__sfr__));

extern volatile unsigned int  DSADRL __attribute__((__sfr__));
extern volatile unsigned int  DSADRH __attribute__((__sfr__));
typedef struct tagDSADRHBITS {
  unsigned DSADR:8;
} DSADRHBITS;
extern volatile DSADRHBITS DSADRHbits __attribute__((__sfr__));

extern volatile unsigned int  TRISA __attribute__((__sfr__));
typedef struct tagTRISABITS {
  unsigned TRISA0:1;
  unsigned TRISA1:1;
  unsigned TRISA2:1;
  unsigned TRISA3:1;
  unsigned TRISA4:1;
  unsigned :3;
  unsigned TRISA8:1;
} TRISABITS;
extern volatile TRISABITS TRISAbits __attribute__((__sfr__));

extern volatile unsigned int  PORTA __attribute__((__sfr__));
typedef struct tagPORTABITS {
  unsigned RA0:1;
  unsigned RA1:1;
  unsigned RA2:1;
  unsigned RA3:1;
  unsigned RA4:1;
  unsigned :3;
  unsigned RA8:1;
} PORTABITS;
extern volatile PORTABITS PORTAbits __attribute__((__sfr__));

extern volatile unsigned int  LATA __attribute__((__sfr__));
typedef struct tagLATABITS {
  unsigned LATA0:1;
  unsigned LATA1:1;
  unsigned LATA2:1;
  unsigned LATA3:1;
  unsigned LATA4:1;
  unsigned :3;
  unsigned LATA8:1;
} LATABITS;
extern volatile LATABITS LATAbits __attribute__((__sfr__));

extern volatile unsigned int  ODCA __attribute__((__sfr__));
typedef struct tagODCABITS {
  unsigned ODCA0:1;
  unsigned ODCA1:1;
  unsigned ODCA2:1;
  unsigned ODCA3:1;
  unsigned ODCA4:1;
  unsigned :3;
  unsigned ODCA8:1;
} ODCABITS;
extern volatile ODCABITS ODCAbits __attribute__((__sfr__));

extern volatile unsigned int  CNENA __attribute__((__sfr__));
typedef struct tagCNENABITS {
  unsigned CNIEA0:1;
  unsigned CNIEA1:1;
  unsigned CNIEA2:1;
  unsigned CNIEA3:1;
  unsigned CNIEA4:1;
  unsigned :3;
  unsigned CNIEA8:1;
} CNENABITS;
extern volatile CNENABITS CNENAbits __attribute__((__sfr__));

extern volatile unsigned int  CNPUA __attribute__((__sfr__));
typedef struct tagCNPUABITS {
  unsigned CNPUA0:1;
  unsigned CNPUA1:1;
  unsigned CNPUA2:1;
  unsigned CNPUA3:1;
  unsigned CNPUA4:1;
  unsigned :3;
  unsigned CNPUA8:1;
} CNPUABITS;
extern volatile CNPUABITS CNPUAbits __attribute__((__sfr__));

extern volatile unsigned int  CNPDA __attribute__((__sfr__));
typedef struct tagCNPDABITS {
  unsigned CNPDA0:1;
  unsigned CNPDA1:1;
  unsigned CNPDA2:1;
  unsigned CNPDA3:1;
  unsigned CNPDA4:1;
  unsigned :3;
  unsigned CNPDA8:1;
} CNPDABITS;
extern volatile CNPDABITS CNPDAbits __attribute__((__sfr__));

extern volatile unsigned int  ANSELA __attribute__((__sfr__));
typedef struct tagANSELABITS {
  unsigned ANSA0:1;
  unsigned ANSA1:1;
  unsigned :2;
  unsigned ANSA4:1;
} ANSELABITS;
extern volatile ANSELABITS ANSELAbits __attribute__((__sfr__));

extern volatile unsigned int  TRISB __attribute__((__sfr__));
typedef struct tagTRISBBITS {
  unsigned TRISB0:1;
  unsigned TRISB1:1;
  unsigned TRISB2:1;
  unsigned TRISB3:1;
  unsigned TRISB4:1;
  unsigned TRISB5:1;
  unsigned TRISB6:1;
  unsigned TRISB7:1;
  unsigned TRISB8:1;
  unsigned TRISB9:1;
  unsigned TRISB10:1;
  unsigned TRISB11:1;
  unsigned TRISB12:1;
  unsigned TRISB13:1;
  unsigned TRISB14:1;
  unsigned TRISB15:1;
} TRISBBITS;
extern volatile TRISBBITS TRISBbits __attribute__((__sfr__));

extern volatile unsigned int  PORTB __attribute__((__sfr__));
typedef struct tagPORTBBITS {
  unsigned RB0:1;
  unsigned RB1:1;
  unsigned RB2:1;
  unsigned RB3:1;
  unsigned RB4:1;
  unsigned RB5:1;
  unsigned RB6:1;
  unsigned RB7:1;
  unsigned RB8:1;
  unsigned RB9:1;
  unsigned RB10:1;
  unsigned RB11:1;
  unsigned RB12:1;
  unsigned RB13:1;
  unsigned RB14:1;
  unsigned RB15:1;
} PORTBBITS;
extern volatile PORTBBITS PORTBbits __attribute__((__sfr__));

extern volatile unsigned int  LATB __attribute__((__sfr__));
typedef struct tagLATBBITS {
  unsigned LATB0:1;
  unsigned LATB1:1;
  unsigned LATB2:1;
  unsigned LATB3:1;
  unsigned LATB4:1;
  unsigned LATB5:1;
  unsigned LATB6:1;
  unsigned LATB7:1;
  unsigned LATB8:1;
  unsigned LATB9:1;
  unsigned LATB10:1;
  unsigned LATB11:1;
  unsigned LATB12:1;
  unsigned LATB13:1;
  unsigned LATB14:1;
  unsigned LATB15:1;
} LATBBITS;
extern volatile LATBBITS LATBbits __attribute__((__sfr__));

extern volatile unsigned int  ODCB __attribute__((__sfr__));
typedef struct tagODCBBITS {
  unsigned ODCB0:1;
  unsigned ODCB1:1;
  unsigned ODCB2:1;
  unsigned ODCB3:1;
  unsigned ODCB4:1;
  unsigned ODCB5:1;
  unsigned ODCB6:1;
  unsigned ODCB7:1;
  unsigned ODCB8:1;
  unsigned ODCB9:1;
  unsigned ODCB10:1;
  unsigned ODCB11:1;
  unsigned ODCB12:1;
  unsigned ODCB13:1;
  unsigned ODCB14:1;
  unsigned ODCB15:1;
} ODCBBITS;
extern volatile ODCBBITS ODCBbits __attribute__((__sfr__));

extern volatile unsigned int  CNENB __attribute__((__sfr__));
typedef struct tagCNENBBITS {
  unsigned CNIEB0:1;
  unsigned CNIEB1:1;
  unsigned CNIEB2:1;
  unsigned CNIEB3:1;
  unsigned CNIEB4:1;
  unsigned CNIEB5:1;
  unsigned CNIEB6:1;
  unsigned CNIEB7:1;
  unsigned CNIEB8:1;
  unsigned CNIEB9:1;
  unsigned CNIEB10:1;
  unsigned CNIEB11:1;
  unsigned CNIEB12:1;
  unsigned CNIEB13:1;
  unsigned CNIEB14:1;
  unsigned CNIEB15:1;
} CNENBBITS;
extern volatile CNENBBITS CNENBbits __attribute__((__sfr__));

extern volatile unsigned int  CNPUB __attribute__((__sfr__));
typedef struct tagCNPUBBITS {
  unsigned CNPUB0:1;
  unsigned CNPUB1:1;
  unsigned CNPUB2:1;
  unsigned CNPUB3:1;
  unsigned CNPUB4:1;
  unsigned CNPUB5:1;
  unsigned CNPUB6:1;
  unsigned CNPUB7:1;
  unsigned CNPUB8:1;
  unsigned CNPUB9:1;
  unsigned CNPUB10:1;
  unsigned CNPUB11:1;
  unsigned CNPUB12:1;
  unsigned CNPUB13:1;
  unsigned CNPUB14:1;
  unsigned CNPUB15:1;
} CNPUBBITS;
extern volatile CNPUBBITS CNPUBbits __attribute__((__sfr__));

extern volatile unsigned int  CNPDB __attribute__((__sfr__));
typedef struct tagCNPDBBITS {
  unsigned CNPDB0:1;
  unsigned CNPDB1:1;
  unsigned CNPDB2:1;
  unsigned CNPDB3:1;
  unsigned CNPDB4:1;
  unsigned CNPDB5:1;
  unsigned CNPDB6:1;
  unsigned CNPDB7:1;
  unsigned CNPDB8:1;
  unsigned CNPDB9:1;
  unsigned CNPDB10:1;
  unsigned CNPDB11:1;
  unsigned CNPDB12:1;
  unsigned CNPDB13:1;
  unsigned CNPDB14:1;
  unsigned CNPDB15:1;
} CNPDBBITS;
extern volatile CNPDBBITS CNPDBbits __attribute__((__sfr__));

extern volatile unsigned int  ANSELB __attribute__((__sfr__));
typedef struct tagANSELBBITS {
  unsigned ANSB0:1;
  unsigned ANSB1:1;
  unsigned ANSB2:1;
  unsigned ANSB3:1;
  unsigned :4;
  unsigned ANSB8:1;
} ANSELBBITS;
extern volatile ANSELBBITS ANSELBbits __attribute__((__sfr__));

extern volatile unsigned int  TRISC __attribute__((__sfr__));
typedef struct tagTRISCBITS {
  unsigned TRISC0:1;
  unsigned TRISC1:1;
  unsigned :6;
  unsigned TRISC8:1;
} TRISCBITS;
extern volatile TRISCBITS TRISCbits __attribute__((__sfr__));

extern volatile unsigned int  PORTC __attribute__((__sfr__));
typedef struct tagPORTCBITS {
  unsigned RC0:1;
  unsigned RC1:1;
  unsigned :6;
  unsigned RC8:1;
} PORTCBITS;
extern volatile PORTCBITS PORTCbits __attribute__((__sfr__));

extern volatile unsigned int  LATC __attribute__((__sfr__));
typedef struct tagLATCBITS {
  unsigned LATC0:1;
  unsigned LATC1:1;
  unsigned :6;
  unsigned LATC8:1;
} LATCBITS;
extern volatile LATCBITS LATCbits __attribute__((__sfr__));

extern volatile unsigned int  ODCC __attribute__((__sfr__));
typedef struct tagODCCBITS {
  unsigned ODCC0:1;
  unsigned ODCC1:1;
  unsigned :6;
  unsigned ODCC8:1;
} ODCCBITS;
extern volatile ODCCBITS ODCCbits __attribute__((__sfr__));

extern volatile unsigned int  CNENC __attribute__((__sfr__));
typedef struct tagCNENCBITS {
  unsigned CNIEC0:1;
  unsigned CNIEC1:1;
  unsigned :6;
  unsigned CNIEC8:1;
} CNENCBITS;
extern volatile CNENCBITS CNENCbits __attribute__((__sfr__));

extern volatile unsigned int  CNPUC __attribute__((__sfr__));
typedef struct tagCNPUCBITS {
  unsigned CNPUC0:1;
  unsigned CNPUC1:1;
  unsigned :6;
  unsigned CNPUC8:1;
} CNPUCBITS;
extern volatile CNPUCBITS CNPUCbits __attribute__((__sfr__));

extern volatile unsigned int  CNPDC __attribute__((__sfr__));
typedef struct tagCNPDCBITS {
  unsigned CNPDC0:1;
  unsigned CNPDC1:1;
  unsigned :6;
  unsigned CNPDC8:1;
} CNPDCBITS;
extern volatile CNPDCBITS CNPDCbits __attribute__((__sfr__));

extern volatile unsigned int  ANSELC __attribute__((__sfr__));
typedef struct tagANSELCBITS {
  unsigned ANSC0:1;
  unsigned ANSC1:1;
} ANSELCBITS;
extern volatile ANSELCBITS ANSELCbits __attribute__((__sfr__));

extern volatile unsigned int  _APPO __attribute__((__sfr__));
extern volatile unsigned int  _APPIN __attribute__((__sfr__));
extern volatile unsigned int  APPS __attribute__((__sfr__));
typedef struct tagAPPSBITS {
  unsigned APIFUL:1;
  unsigned APIOV:1;
  unsigned AROFUL:1;
  unsigned APOOV:1;
  unsigned STRFUL:1;
} APPSBITS;
extern volatile APPSBITS APPSbits __attribute__((__sfr__));

extern volatile unsigned int  STROUTL __attribute__((__sfr__));
extern volatile unsigned int  STROUTH __attribute__((__sfr__));
extern volatile unsigned int  STROVCNT __attribute__((__sfr__));
extern volatile unsigned int  JDATAH __attribute__((__sfr__));
extern volatile unsigned int  JDATAL __attribute__((__sfr__));


/* ---------------------------------------------------------- */
/* Defines for unique SFR bit names                           */
/* ---------------------------------------------------------- */

/* DSRPAG */
#define _DSRPAG DSRPAGbits.DSRPAG

/* DSWPAG */
#define _DSWPAG DSWPAGbits.DSWPAG

/* SR */
#define _C SRbits.C
#define _Z SRbits.Z
#define _OV SRbits.OV
#define _N SRbits.N
#define _RA SRbits.RA
#define _IPL SRbits.IPL
#define _DC SRbits.DC
#define _DA SRbits.DA
#define _SAB SRbits.SAB
#define _OAB SRbits.OAB
#define _SB SRbits.SB
#define _SA SRbits.SA
#define _OB SRbits.OB
#define _OA SRbits.OA
#define _IPL0 SRbits.IPL0
#define _IPL1 SRbits.IPL1
#define _IPL2 SRbits.IPL2

/* CORCON */
#define _IF CORCONbits.IF
#define _RND CORCONbits.RND
#define _SFA CORCONbits.SFA
#define _IPL3 CORCONbits.IPL3
#define _ACCSAT CORCONbits.ACCSAT
#define _SATDW CORCONbits.SATDW
#define _SATB CORCONbits.SATB
#define _SATA CORCONbits.SATA
#define _DL CORCONbits.DL
#define _EDT CORCONbits.EDT
#define _US CORCONbits.US
#define _VAR CORCONbits.VAR
#define _DL0 CORCONbits.DL0
#define _DL1 CORCONbits.DL1
#define _DL2 CORCONbits.DL2
#define _US0 CORCONbits.US0
#define _US1 CORCONbits.US1

/* TBLPAG */
#define _TBLPAG TBLPAGbits.TBLPAG

/* T1CON */
#define _TCS T1CONbits.TCS
#define _TSYNC T1CONbits.TSYNC
#define _TCKPS T1CONbits.TCKPS
#define _TGATE T1CONbits.TGATE
#define _TSIDL T1CONbits.TSIDL
#define _TON T1CONbits.TON
#define _TCKPS0 T1CONbits.TCKPS0
#define _TCKPS1 T1CONbits.TCKPS1

/* T2CON */
/* Bitname _TCS cannot be defined because it is used by more than one SFR */
/* Bitname _T32 cannot be defined because it is used by more than one SFR */
/* Bitname _TCKPS cannot be defined because it is used by more than one SFR */
/* Bitname _TGATE cannot be defined because it is used by more than one SFR */
/* Bitname _TSIDL cannot be defined because it is used by more than one SFR */
/* Bitname _TON cannot be defined because it is used by more than one SFR */
/* Bitname _TCKPS0 cannot be defined because it is used by more than one SFR */
/* Bitname _TCKPS1 cannot be defined because it is used by more than one SFR */

/* T3CON */
/* Bitname _TCS cannot be defined because it is used by more than one SFR */
/* Bitname _TCKPS cannot be defined because it is used by more than one SFR */
/* Bitname _TGATE cannot be defined because it is used by more than one SFR */
/* Bitname _TSIDL cannot be defined because it is used by more than one SFR */
/* Bitname _TON cannot be defined because it is used by more than one SFR */
/* Bitname _TCKPS0 cannot be defined because it is used by more than one SFR */
/* Bitname _TCKPS1 cannot be defined because it is used by more than one SFR */

/* T4CON */
/* Bitname _TCS cannot be defined because it is used by more than one SFR */
/* Bitname _T32 cannot be defined because it is used by more than one SFR */
/* Bitname _TCKPS cannot be defined because it is used by more than one SFR */
/* Bitname _TGATE cannot be defined because it is used by more than one SFR */
/* Bitname _TSIDL cannot be defined because it is used by more than one SFR */
/* Bitname _TON cannot be defined because it is used by more than one SFR */
/* Bitname _TCKPS0 cannot be defined because it is used by more than one SFR */
/* Bitname _TCKPS1 cannot be defined because it is used by more than one SFR */

/* T5CON */
/* Bitname _TCS cannot be defined because it is used by more than one SFR */
/* Bitname _TCKPS cannot be defined because it is used by more than one SFR */
/* Bitname _TGATE cannot be defined because it is used by more than one SFR */
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
/* Bitname _ICTSEL0 cannot be defined because it is used by more than one SFR */
/* Bitname _ICTSEL1 cannot be defined because it is used by more than one SFR */
/* Bitname _ICTSEL2 cannot be defined because it is used by more than one SFR */

/* IC4CON2 */
/* Bitname _SYNCSEL cannot be defined because it is used by more than one SFR */
/* Bitname _TRIGSTAT cannot be defined because it is used by more than one SFR */
/* Bitname _ICTRIG cannot be defined because it is used by more than one SFR */
/* Bitname _IC32 cannot be defined because it is used by more than one SFR */
/* Bitname _SYNCSEL0 cannot be defined because it is used by more than one SFR */
/* Bitname _SYNCSEL1 cannot be defined because it is used by more than one SFR */
/* Bitname _SYNCSEL2 cannot be defined because it is used by more than one SFR */
/* Bitname _SYNCSEL3 cannot be defined because it is used by more than one SFR */
/* Bitname _SYNCSEL4 cannot be defined because it is used by more than one SFR */

/* I2C1CON */
#define _SEN I2C1CONbits.SEN
#define _RSEN I2C1CONbits.RSEN
#define _PEN I2C1CONbits.PEN
#define _RCEN I2C1CONbits.RCEN
#define _ACKEN I2C1CONbits.ACKEN
#define _ACKDT I2C1CONbits.ACKDT
#define _STREN I2C1CONbits.STREN
#define _GCEN I2C1CONbits.GCEN
#define _SMEN I2C1CONbits.SMEN
#define _DISSLW I2C1CONbits.DISSLW
#define _A10M I2C1CONbits.A10M
#define _IPMIEN I2C1CONbits.IPMIEN
#define _SCLREL I2C1CONbits.SCLREL
#define _I2CSIDL I2C1CONbits.I2CSIDL
#define _I2CEN I2C1CONbits.I2CEN

/* I2C1STAT */
#define _TBF I2C1STATbits.TBF
#define _RBF I2C1STATbits.RBF
#define _R_W I2C1STATbits.R_W
#define _S I2C1STATbits.S
#define _P I2C1STATbits.P
#define _D_A I2C1STATbits.D_A
#define _I2COV I2C1STATbits.I2COV
#define _IWCOL I2C1STATbits.IWCOL
#define _ADD10 I2C1STATbits.ADD10
#define _GCSTAT I2C1STATbits.GCSTAT
#define _BCL I2C1STATbits.BCL
#define _TRSTAT I2C1STATbits.TRSTAT
#define _ACKSTAT I2C1STATbits.ACKSTAT

/* I2C2CON */
/* Bitname _SEN cannot be defined because it is used by more than one SFR */
/* Bitname _RSEN cannot be defined because it is used by more than one SFR */
/* Bitname _PEN cannot be defined because it is used by more than one SFR */
/* Bitname _RCEN cannot be defined because it is used by more than one SFR */
/* Bitname _ACKEN cannot be defined because it is used by more than one SFR */
/* Bitname _ACKDT cannot be defined because it is used by more than one SFR */
/* Bitname _STREN cannot be defined because it is used by more than one SFR */
/* Bitname _GCEN cannot be defined because it is used by more than one SFR */
/* Bitname _SMEN cannot be defined because it is used by more than one SFR */
/* Bitname _DISSLW cannot be defined because it is used by more than one SFR */
/* Bitname _A10M cannot be defined because it is used by more than one SFR */
/* Bitname _IPMIEN cannot be defined because it is used by more than one SFR */
/* Bitname _SCLREL cannot be defined because it is used by more than one SFR */
/* Bitname _I2CSIDL cannot be defined because it is used by more than one SFR */
/* Bitname _I2CEN cannot be defined because it is used by more than one SFR */

/* I2C2STAT */
/* Bitname _TBF cannot be defined because it is used by more than one SFR */
/* Bitname _RBF cannot be defined because it is used by more than one SFR */
/* Bitname _R_W cannot be defined because it is used by more than one SFR */
/* Bitname _S cannot be defined because it is used by more than one SFR */
/* Bitname _P cannot be defined because it is used by more than one SFR */
/* Bitname _D_A cannot be defined because it is used by more than one SFR */
/* Bitname _I2COV cannot be defined because it is used by more than one SFR */
/* Bitname _IWCOL cannot be defined because it is used by more than one SFR */
/* Bitname _ADD10 cannot be defined because it is used by more than one SFR */
/* Bitname _GCSTAT cannot be defined because it is used by more than one SFR */
/* Bitname _BCL cannot be defined because it is used by more than one SFR */
/* Bitname _TRSTAT cannot be defined because it is used by more than one SFR */
/* Bitname _ACKSTAT cannot be defined because it is used by more than one SFR */

/* U1MODE */
#define _STSEL U1MODEbits.STSEL
#define _PDSEL U1MODEbits.PDSEL
#define _BRGH U1MODEbits.BRGH
#define _URXINV U1MODEbits.URXINV
#define _ABAUD U1MODEbits.ABAUD
#define _LPBACK U1MODEbits.LPBACK
#define _WAKE U1MODEbits.WAKE
#define _UEN U1MODEbits.UEN
#define _RTSMD U1MODEbits.RTSMD
#define _IREN U1MODEbits.IREN
#define _USIDL U1MODEbits.USIDL
#define _UARTEN U1MODEbits.UARTEN
#define _PDSEL0 U1MODEbits.PDSEL0
#define _PDSEL1 U1MODEbits.PDSEL1
#define _RXINV U1MODEbits.RXINV
#define _UEN0 U1MODEbits.UEN0
#define _UEN1 U1MODEbits.UEN1

/* U1STA */
#define _URXDA U1STAbits.URXDA
#define _OERR U1STAbits.OERR
#define _FERR U1STAbits.FERR
#define _PERR U1STAbits.PERR
#define _RIDLE U1STAbits.RIDLE
#define _ADDEN U1STAbits.ADDEN
#define _URXISEL U1STAbits.URXISEL
#define _TRMT U1STAbits.TRMT
#define _UTXBF U1STAbits.UTXBF
#define _UTXEN U1STAbits.UTXEN
#define _UTXBRK U1STAbits.UTXBRK
#define _UTXISEL0 U1STAbits.UTXISEL0
#define _UTXINV U1STAbits.UTXINV
#define _UTXISEL1 U1STAbits.UTXISEL1
#define _URXISEL0 U1STAbits.URXISEL0
#define _URXISEL1 U1STAbits.URXISEL1

/* U2MODE */
/* Bitname _STSEL cannot be defined because it is used by more than one SFR */
/* Bitname _PDSEL cannot be defined because it is used by more than one SFR */
/* Bitname _BRGH cannot be defined because it is used by more than one SFR */
/* Bitname _URXINV cannot be defined because it is used by more than one SFR */
/* Bitname _ABAUD cannot be defined because it is used by more than one SFR */
/* Bitname _LPBACK cannot be defined because it is used by more than one SFR */
/* Bitname _WAKE cannot be defined because it is used by more than one SFR */
/* Bitname _UEN cannot be defined because it is used by more than one SFR */
/* Bitname _RTSMD cannot be defined because it is used by more than one SFR */
/* Bitname _IREN cannot be defined because it is used by more than one SFR */
/* Bitname _USIDL cannot be defined because it is used by more than one SFR */
/* Bitname _UARTEN cannot be defined because it is used by more than one SFR */
/* Bitname _PDSEL0 cannot be defined because it is used by more than one SFR */
/* Bitname _PDSEL1 cannot be defined because it is used by more than one SFR */
/* Bitname _RXINV cannot be defined because it is used by more than one SFR */
/* Bitname _UEN0 cannot be defined because it is used by more than one SFR */
/* Bitname _UEN1 cannot be defined because it is used by more than one SFR */
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
