AndresMtzP/Globetrotters/(commit log)

2017-03-11 Changes implementation of rotation, introduces new script to generate frames before rotation script runs
2017-03-11 Deletes previous rotationScript directory, along with the preloaded frame images
2017-03-13 Removes frames directory, updates changes to rotation script now based on 120 frames
2017-05-03 Adds python socket functions for pi-2-picomms
2017-05-24 Adds final revision of the project files. This revision was submitted along with the final report on 05-11-17
    [10_pin_dbl_.1sp.pcb, 10_pin_dbl_.1sp_Box.pcb, 10_pin_dbl_.1sp_SMD.pcb, 10_pin_dbl_.1sp_SMD_Top.pcb, 10_pin_edge_.1sp.pcb, 10_pin_sngl_.1sp.pcb, 10_pin_sngl_.1sp_SMD_Top.pcb, 11_pin_sngl_.1sp.pcb]
