AndresMtzP/Globetrotters/(notices)

Notices in the files:
ProjectFiles/Website/hardware.html:
Released for free under the Creative Commons Attribution 3.0 license (templated.co/license)
