AndresMtzP/Globetrotters/ProjectFiles/Website/images/handcoil.jpg

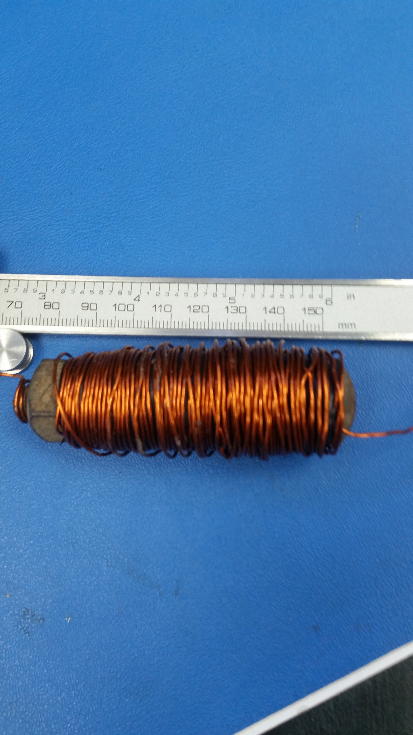
ProjectFiles/Website/images/handcoil.jpg
